20sffactory/community_robot_arm/Assembly & Control Guides/Wiring Guide/wiring-a4988.jpg

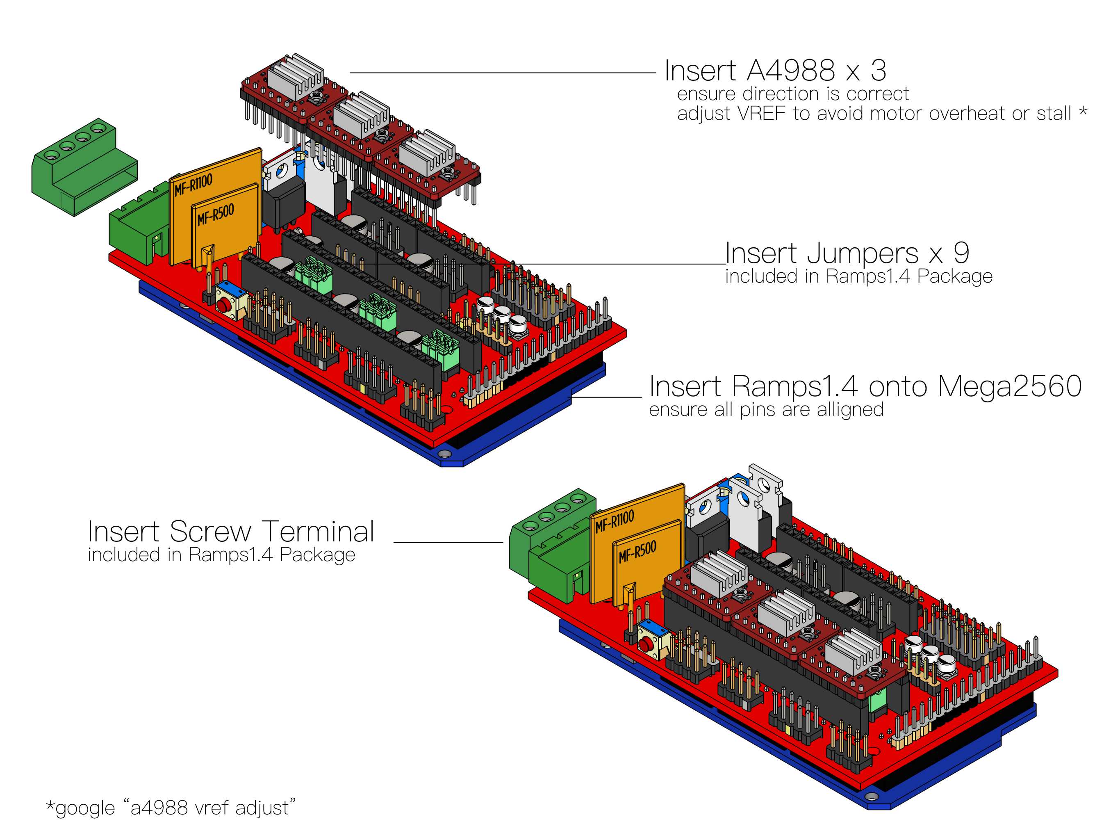
Assembly & Control Guides/Wiring Guide/wiring-a4988.jpg
