20sffactory/community_robot_arm/Assembly & Control Guides/Wiring Guide/wiring-endstops.jpg

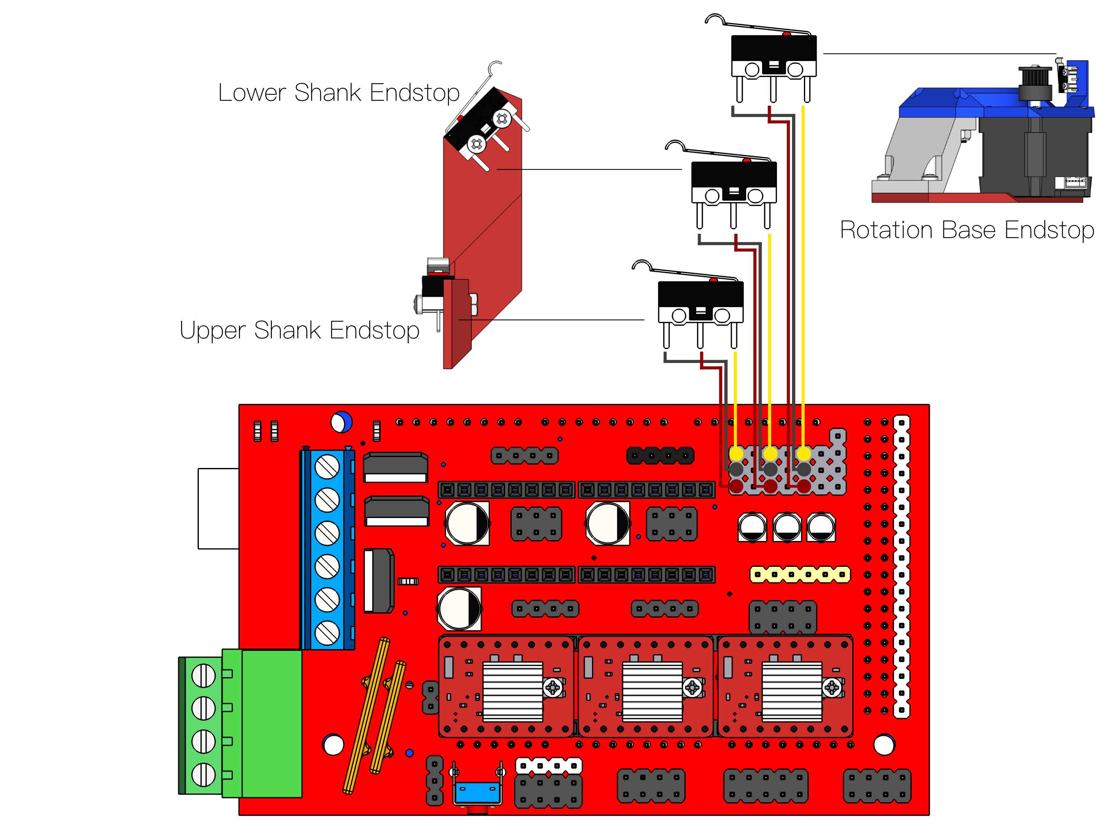
Assembly & Control Guides/Wiring Guide/wiring-endstops.jpg
