20sffactory/community_robot_arm/Assembly & Control Guides/robot_bom.jpg

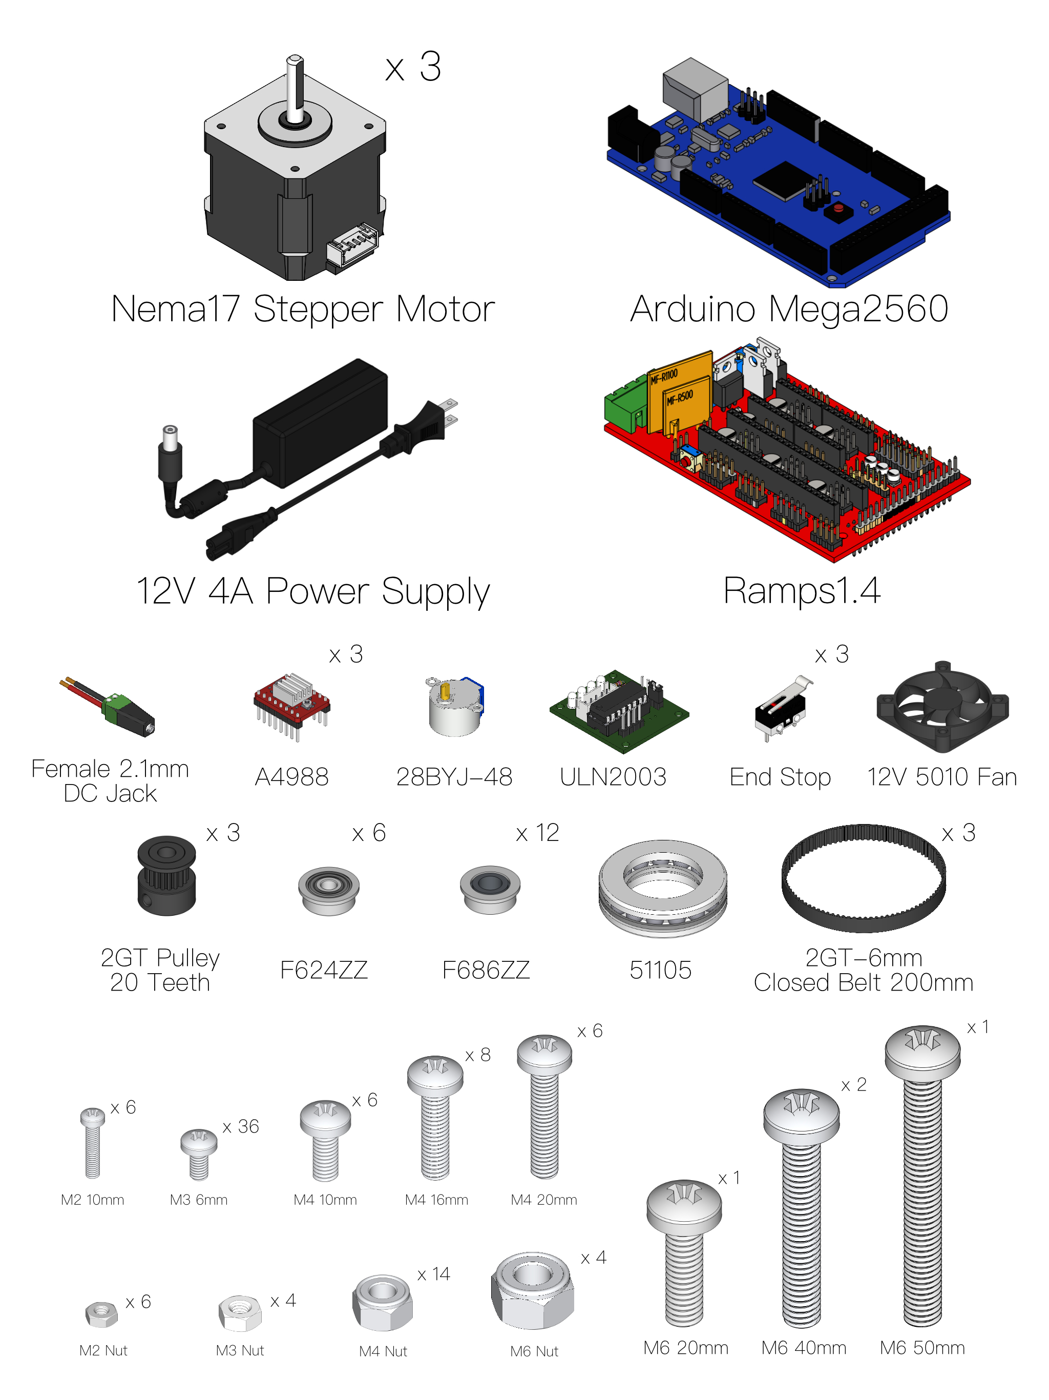
Assembly & Control Guides/robot_bom.jpg
