20sffactory/community_robot_arm/CAD Files/dual_manipulator_support/main_body_dual_v2.stl

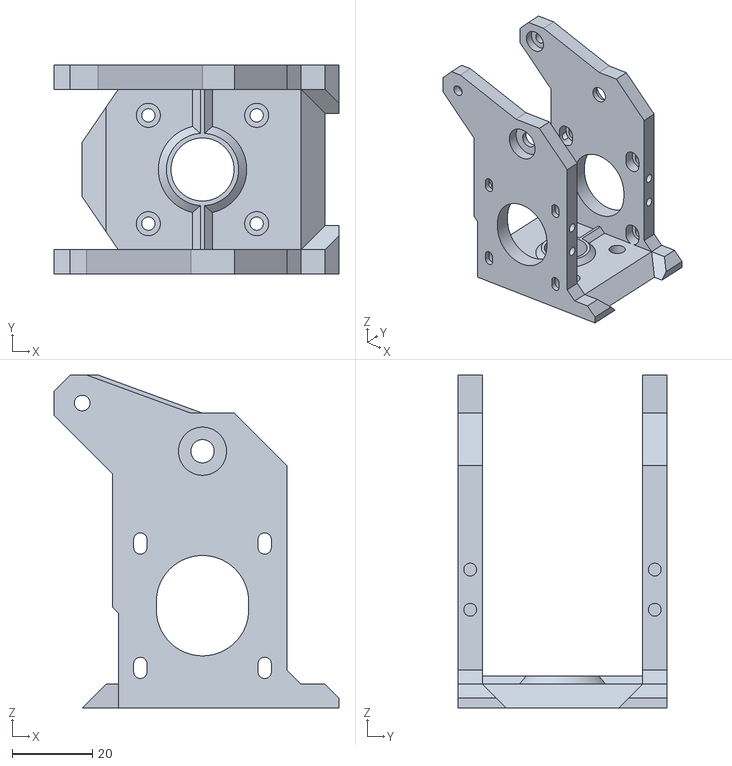
[picture p4: CAD file, 2021-02-04]
CAD Files/dual_manipulator_support/main_body_dual_v2.stl
71.0 x 52.0 x 83.0
