20sffactory/community_robot_arm/CAD Files/robot_belt_arm main_body_v2.stl

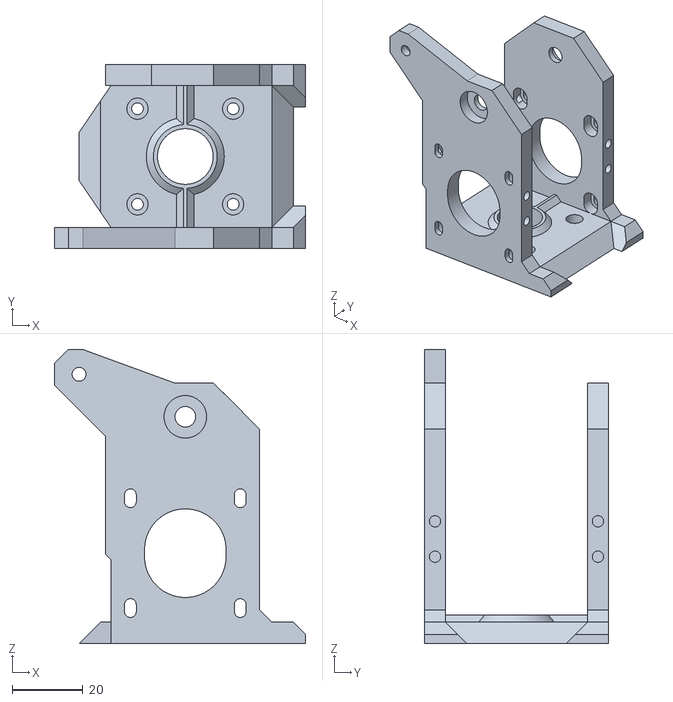
[picture p5: CAD file, 2021-02-04]
CAD Files/robot_belt_arm main_body_v2.stl
71.0 x 52.0 x 83.0
