20sffactory/community_robot_arm/CAD Files/rail_stl/rail_motor_mount.stl

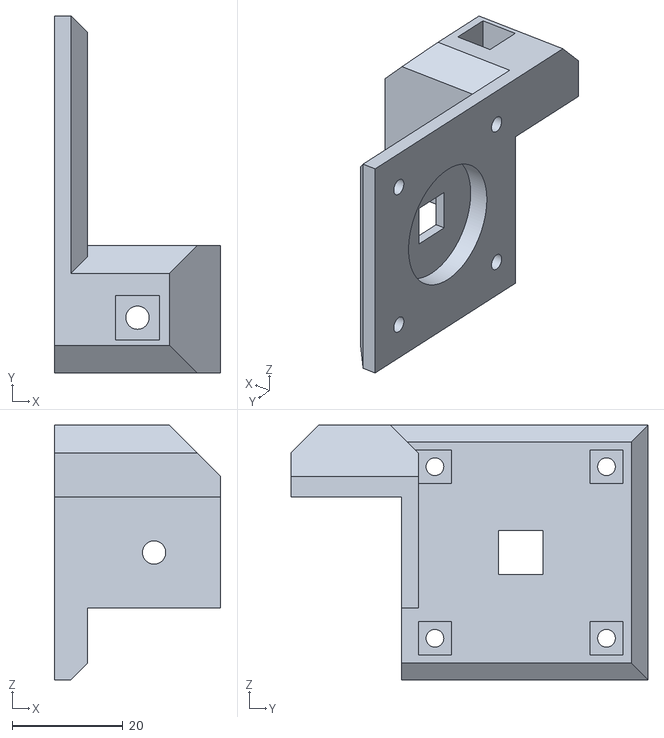
[picture p6: CAD file, 2020-11-04]
CAD Files/rail_stl/rail_motor_mount.stl
30.0 x 64.5 x 46.0
