20sffactory/community_robot_arm/CAD Files/robot_arm_upper_shank_v2.stl

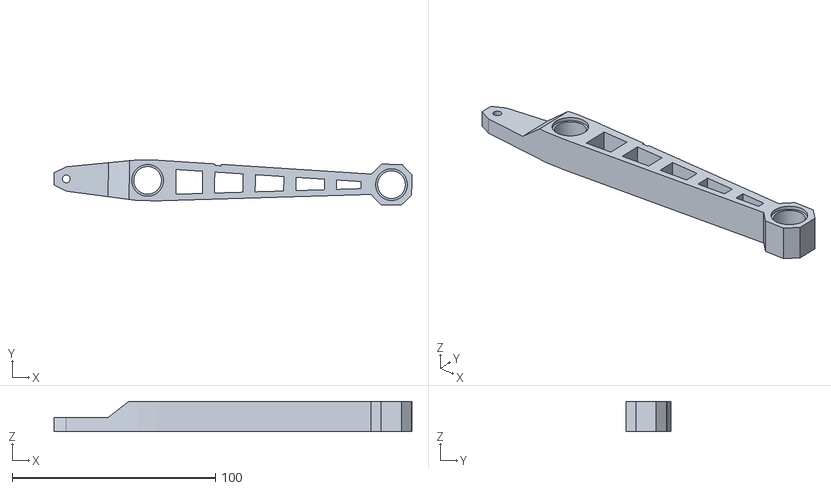
[picture p7: CAD file, 2021-08-22]
CAD Files/robot_arm_upper_shank_v2.stl
176.1 x 22.3 x 15.0
