20sffactory/community_robot_arm/CAD Files/shank_calibrator/shank_calibrator_120mm.stl

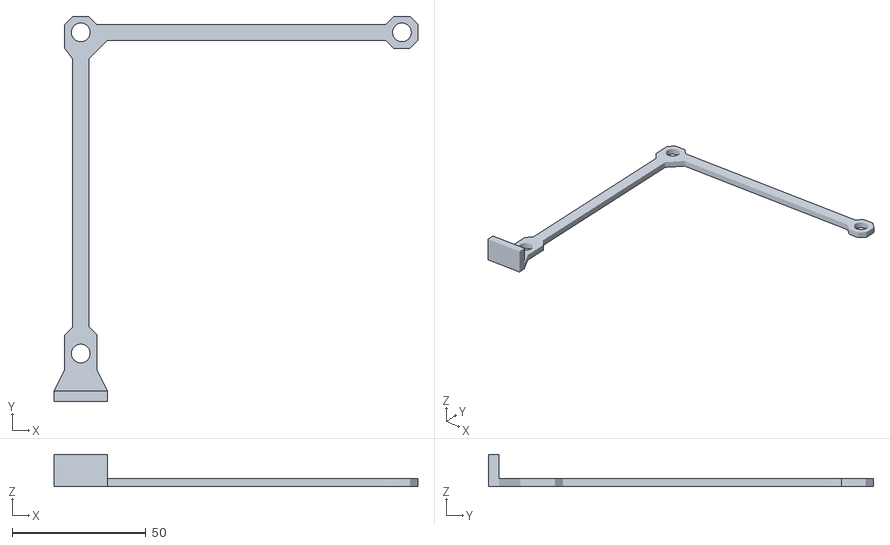
[picture p8: CAD file, 2021-01-24]
CAD Files/shank_calibrator/shank_calibrator_120mm.stl
136.0 x 144.0 x 12.0
