20sffactory/community_robot_arm/CAD Files/shank_pleuel_140mm/lower_shank_140.stl

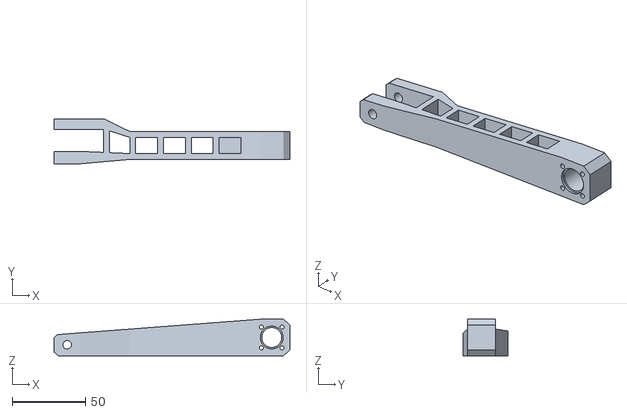
[picture p9: CAD file, 2021-01-19]
CAD Files/shank_pleuel_140mm/lower_shank_140.stl
161.4 x 30.5 x 25.0
