20sffactory/community_robot_arm/CAD Files/toolheads_stl/28byj_cover_by_woutervanschaik/Cap.stp

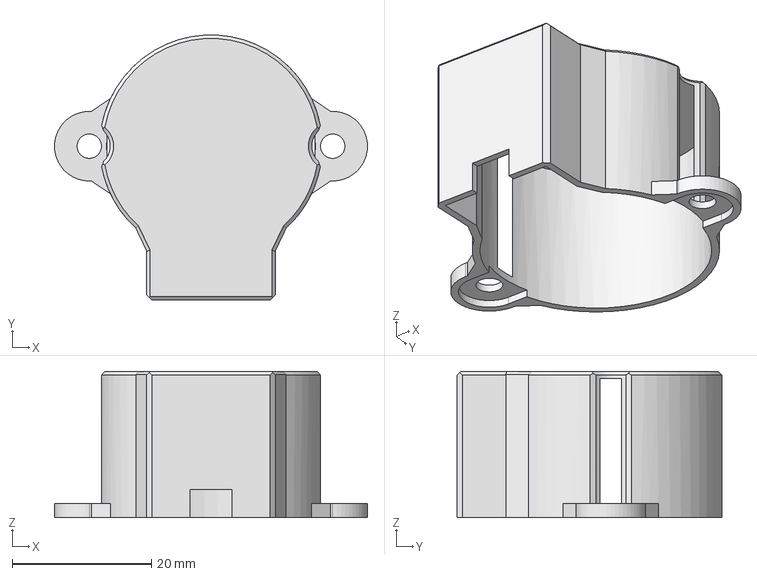
[picture p10: CAD file, 2021-02-07]
CAD Files/toolheads_stl/28byj_cover_by_woutervanschaik/Cap.stp
45.0 x 38.1 x 21.0 mm
