20sffactory/community_robot_arm/CAD Files/toolheads_stl/3dprint_extractor.stl

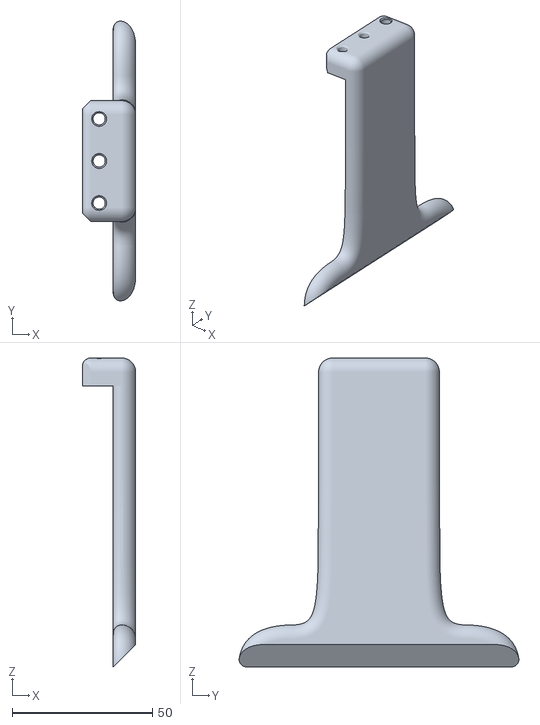
[picture p11: CAD file, 2021-02-24]
CAD Files/toolheads_stl/3dprint_extractor.stl
19.0 x 99.6 x 110.0
