20sffactory/community_robot_arm/CAD Files/toolheads_stl/gripper_stl_by_ftobler/gripperHolePlateWithPenHolder_by_Leandro.stl

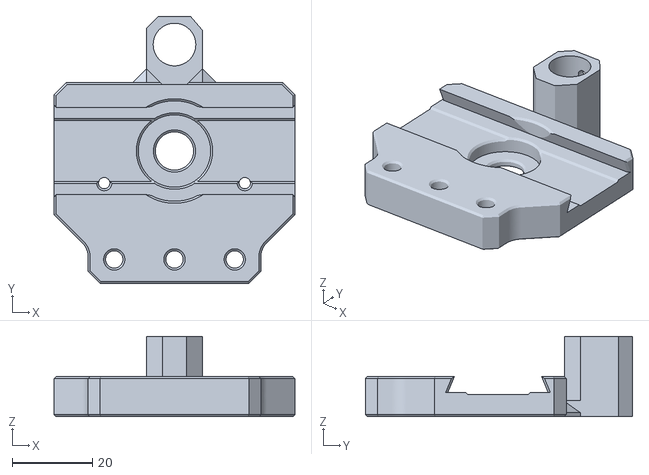
[picture p12: CAD file, 2021-01-23]
CAD Files/toolheads_stl/gripper_stl_by_ftobler/gripperHolePlateWithPenHolder_by_Leandro.stl
60.0 x 66.5 x 20.0
