20sffactory/community_robot_arm/CAD Files/toolheads_stl/servo_gripper_stl_by_20sffactory/servo_gripperBase.stl

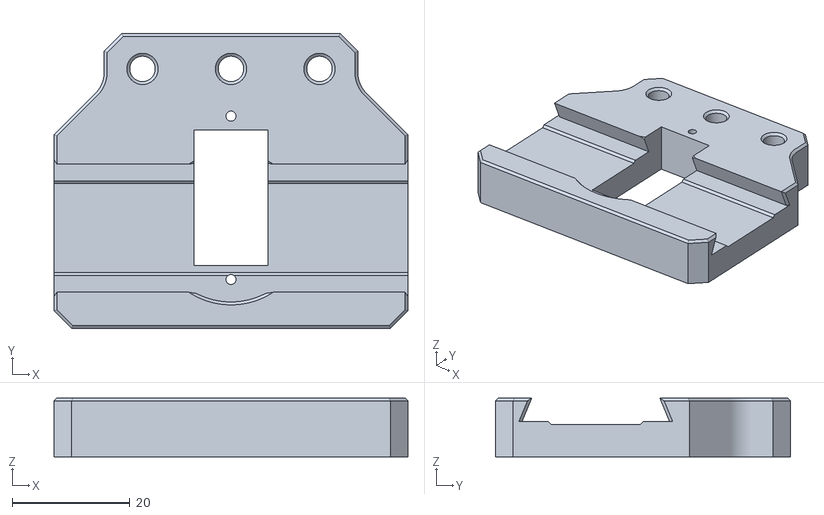
[picture p13: CAD file, 2021-05-25]
CAD Files/toolheads_stl/servo_gripper_stl_by_20sffactory/servo_gripperBase.stl
60.0 x 50.0 x 10.0
