20sffactory/community_robot_arm/CAD Files/rail_stl/rail_leg.stl

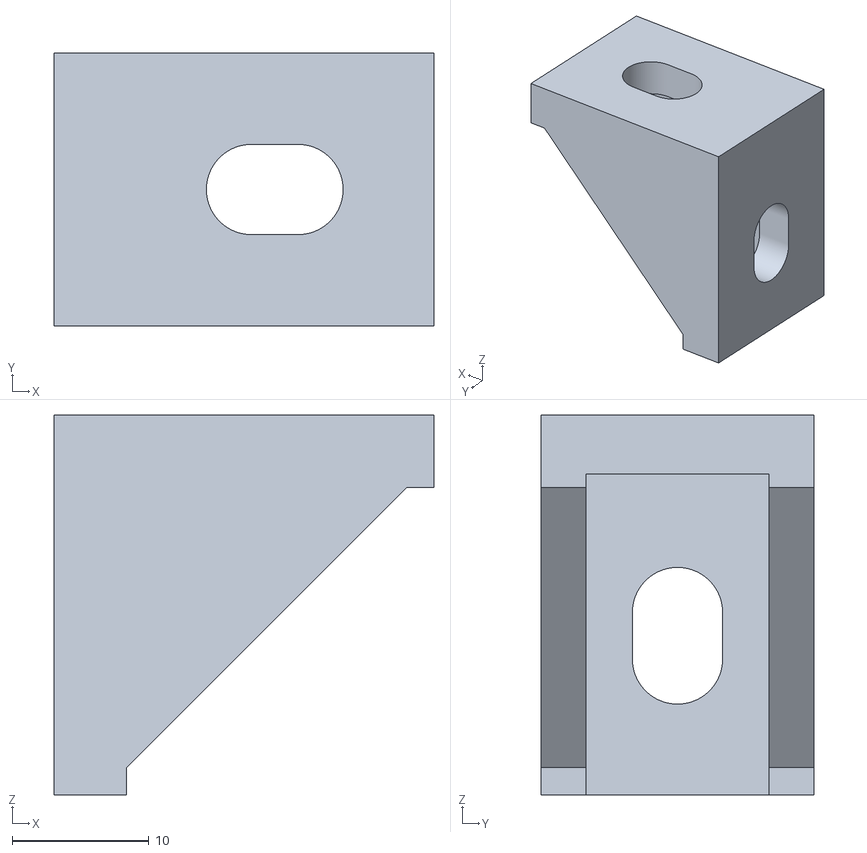
[picture p14: CAD file, 2020-11-04]
CAD Files/rail_stl/rail_leg.stl
27.8 x 20.0 x 27.8
