20sffactory/community_robot_arm/CAD Files/robot_belt_arm socket_v2.stl

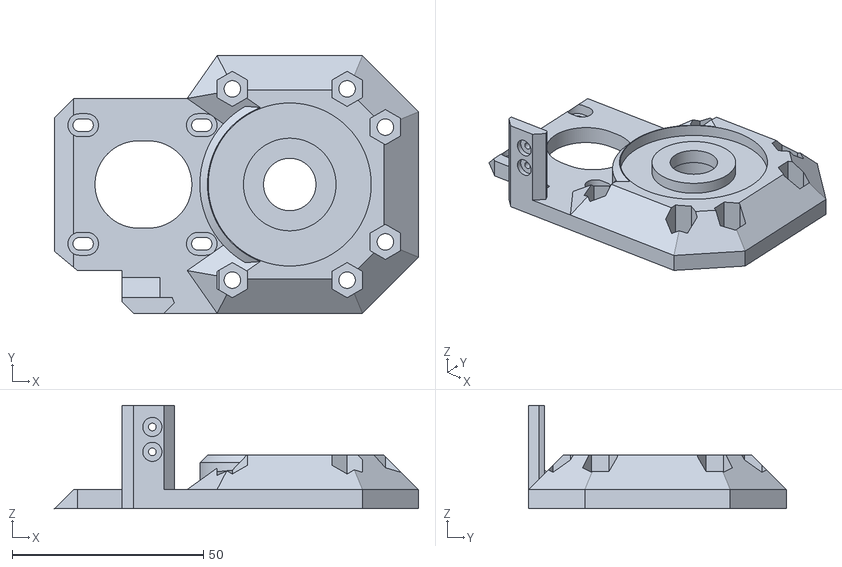
[picture p15: CAD file, 2021-02-04]
CAD Files/robot_belt_arm socket_v2.stl
95.2 x 67.3 x 27.0
