20sffactory/community_robot_arm/CAD Files/shank_calibrator/shank_calibrator_140mm.stl

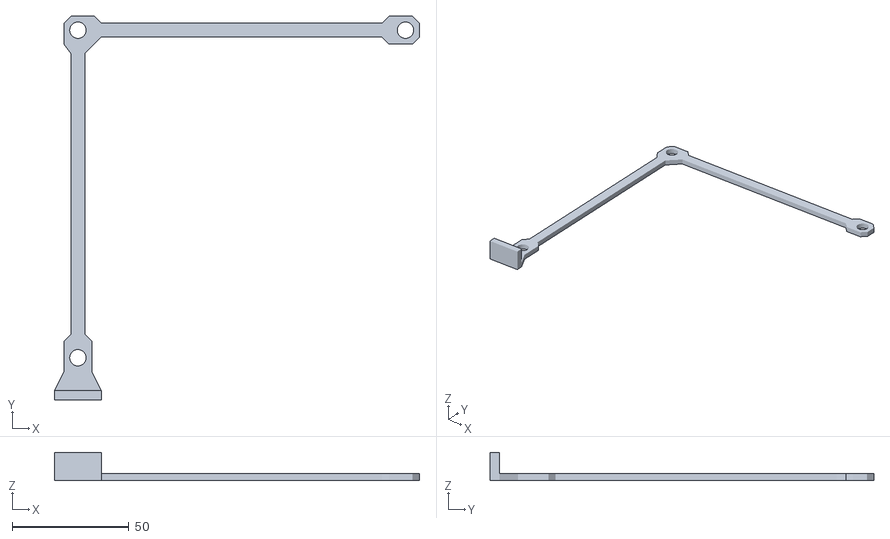
[picture p16: CAD file, 2021-01-24]
CAD Files/shank_calibrator/shank_calibrator_140mm.stl
156.0 x 164.0 x 12.0
