20sffactory/community_robot_arm/CAD Files/shank_pleuel_140mm/pleuel_bend_140.stl

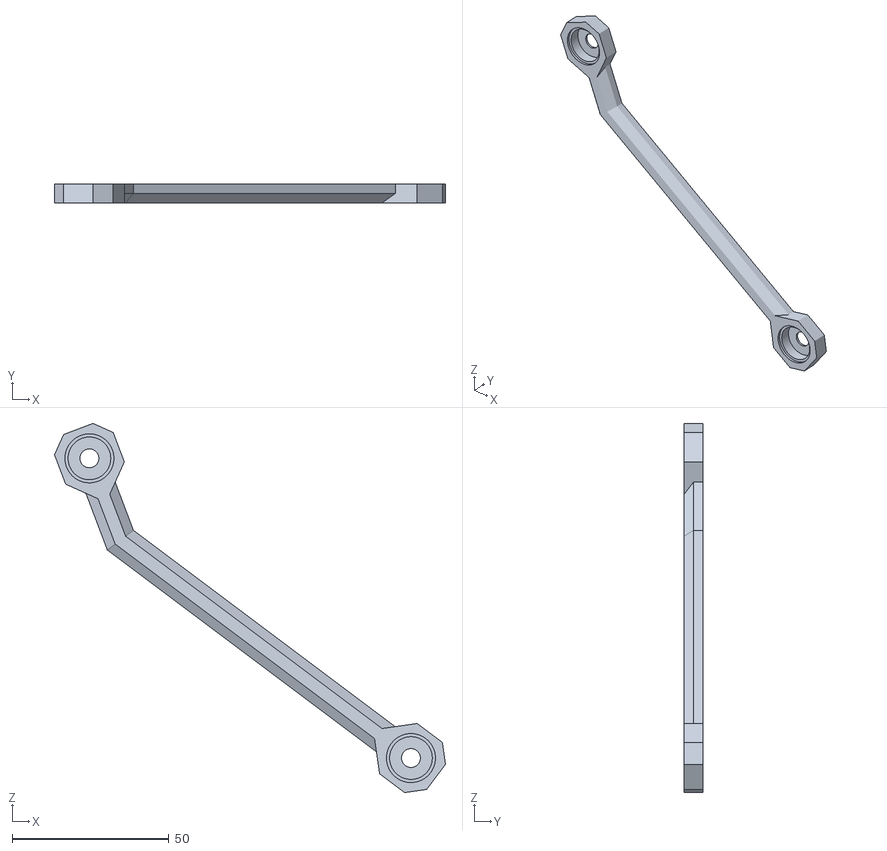
[picture p17: CAD file, 2021-01-19]
CAD Files/shank_pleuel_140mm/pleuel_bend_140.stl
124.5 x 6.00 x 117.6
