20sffactory/community_robot_arm/CAD Files/toolheads_stl/dragon_head.stl

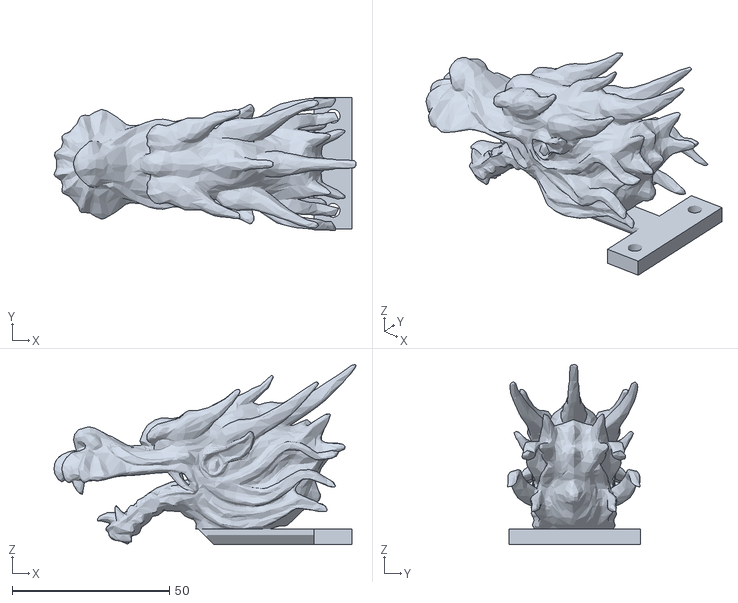
[picture p18: CAD file, 2021-02-24]
CAD Files/toolheads_stl/dragon_head.stl
96.2 x 42.5 x 57.4
