20sffactory/community_robot_arm/CAD Files/toolheads_stl/gripper_stl_by_ftobler/gripperBase_by_ftobler.stl

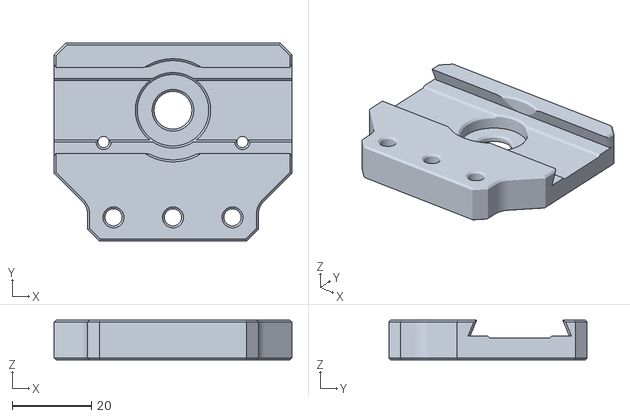
[picture p19: CAD file, 2021-01-16]
CAD Files/toolheads_stl/gripper_stl_by_ftobler/gripperBase_by_ftobler.stl
60.0 x 50.0 x 10.0
