20sffactory/community_robot_arm/CAD Files/toolheads_stl/servo_gripper_stl_by_20sffactory/servo_gripper_shaft.stl

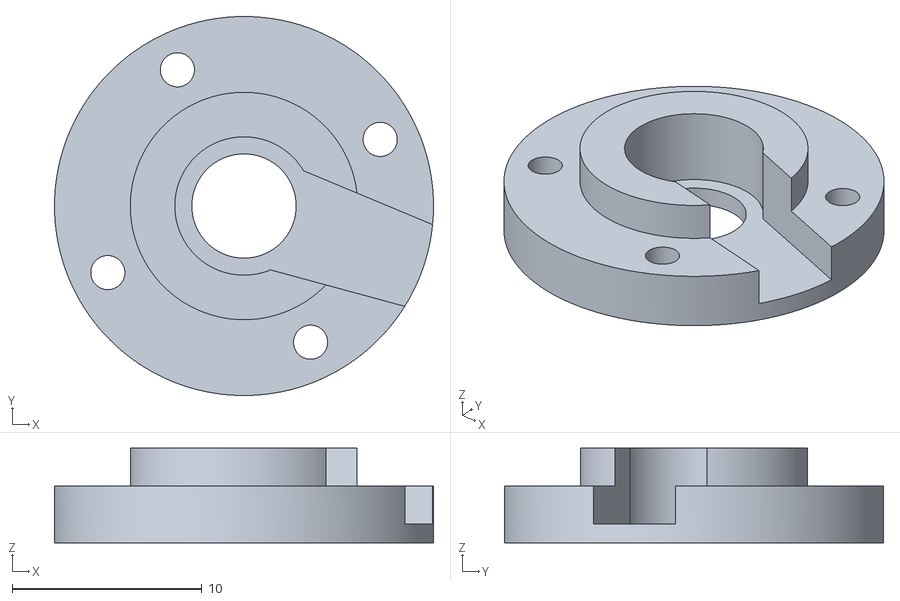
[picture p20: CAD file, 2021-05-25]
CAD Files/toolheads_stl/servo_gripper_stl_by_20sffactory/servo_gripper_shaft.stl
20.0 x 20.0 x 5.00
