20sffactory/community_robot_arm/CAD Files/dual_manipulator_support/triplate_dual.stl

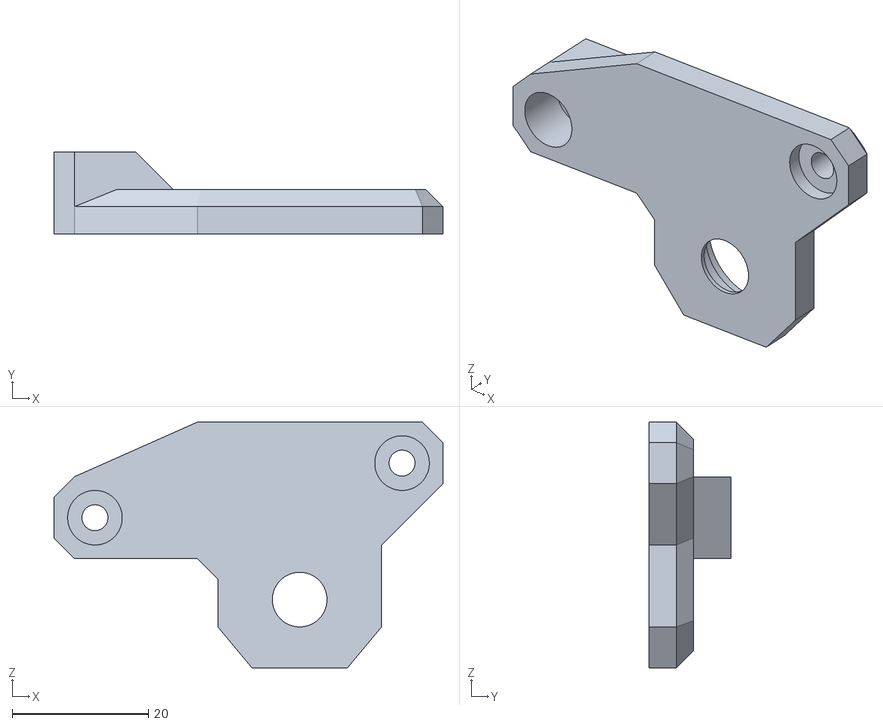
[picture p21: CAD file, 2021-01-19]
CAD Files/dual_manipulator_support/triplate_dual.stl
57.0 x 12.0 x 36.0
