20sffactory/community_robot_arm/CAD Files/rail_stl/rail_slide_plate.stl

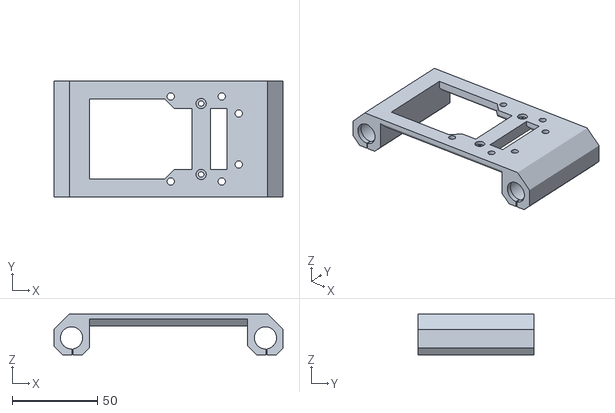
[picture p22: CAD file, 2020-11-04]
CAD Files/rail_stl/rail_slide_plate.stl
134.6 x 68.0 x 24.0
