20sffactory/community_robot_arm/CAD Files/shank_pleuel_140mm/upper_shank_140.stl

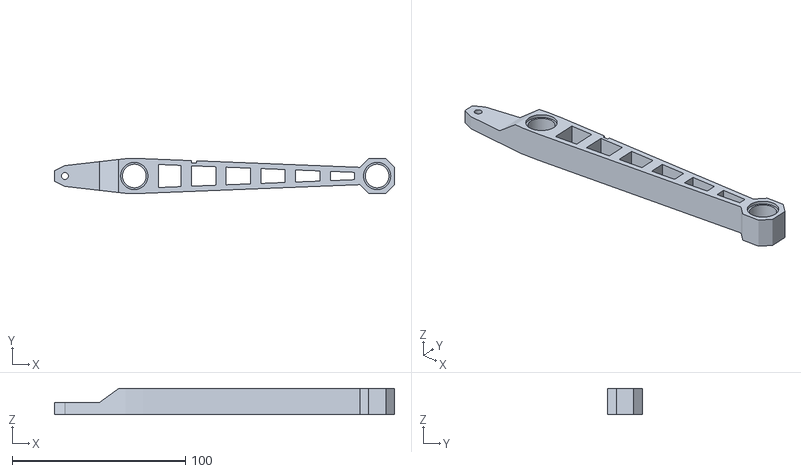
[picture p23: CAD file, 2021-01-19]
CAD Files/shank_pleuel_140mm/upper_shank_140.stl
196.0 x 20.0 x 15.0
