20sffactory/community_robot_arm/CAD Files/toolheads_stl/gripper_stl_by_ftobler/gripper_shaft.stl

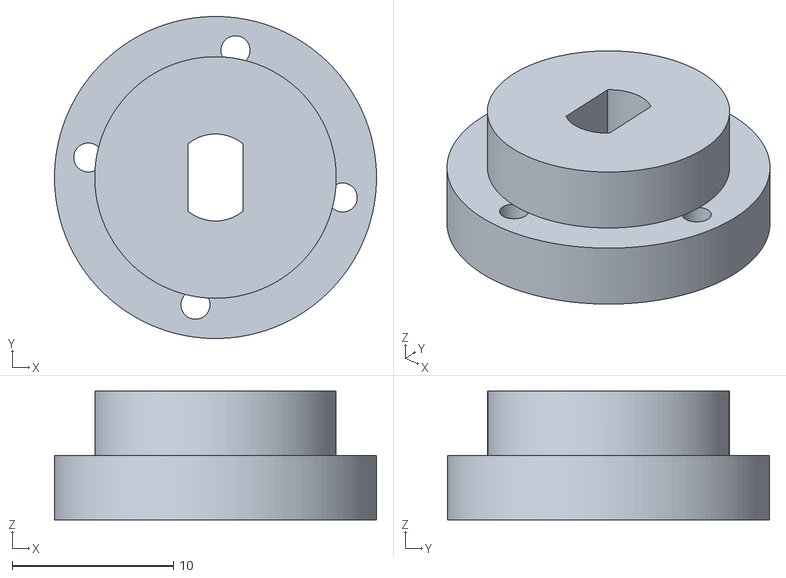
[picture p24: CAD file, 2021-01-16]
CAD Files/toolheads_stl/gripper_stl_by_ftobler/gripper_shaft.stl
20.0 x 20.0 x 8.00
