20sffactory/community_robot_arm/CAD Files/toolheads_stl/pen_plotter.stl

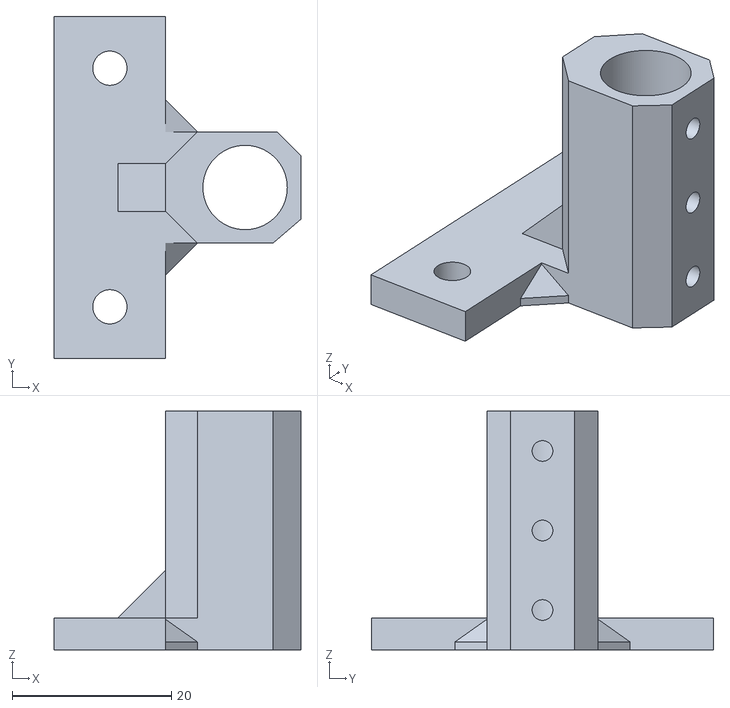
[picture p25: CAD file, 2020-10-14]
CAD Files/toolheads_stl/pen_plotter.stl
31.0 x 43.0 x 30.0
