20sffactory/community_robot_arm/CAD Files/toolheads_stl/servo_gripper_stl_by_20sffactory/servo_gripperBaseWithPenHolder.stl

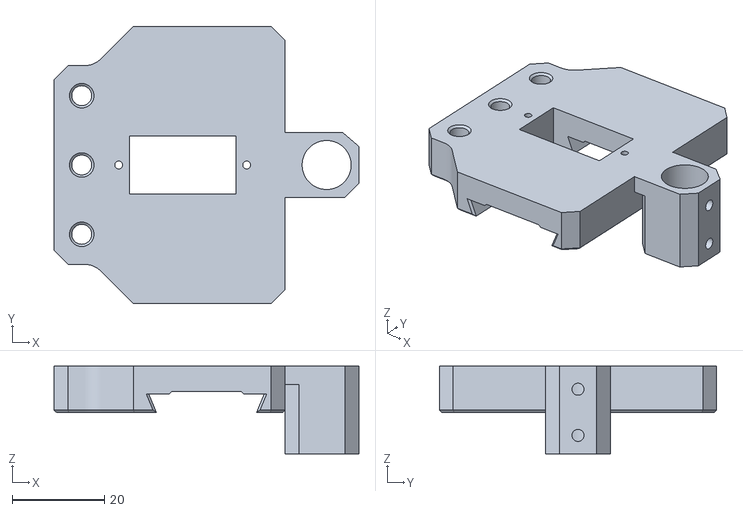
[picture p26: CAD file, 2021-05-25]
CAD Files/toolheads_stl/servo_gripper_stl_by_20sffactory/servo_gripperBaseWithPenHolder.stl
66.0 x 60.0 x 19.0
