20sffactory/community_robot_arm/CAD Files/case_fangrill.stl

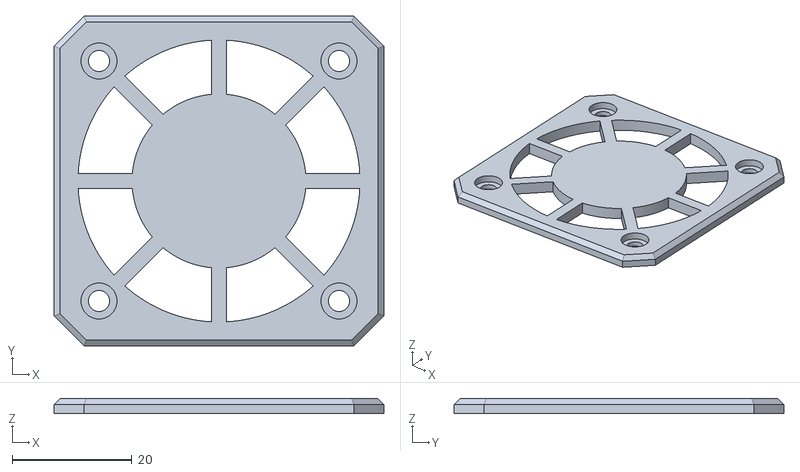
[picture p27: CAD file, 2020-10-07]
CAD Files/case_fangrill.stl
55.0 x 55.0 x 2.50
