20sffactory/community_robot_arm/CAD Files/dual_manipulator_support/manipulator_dual.stl

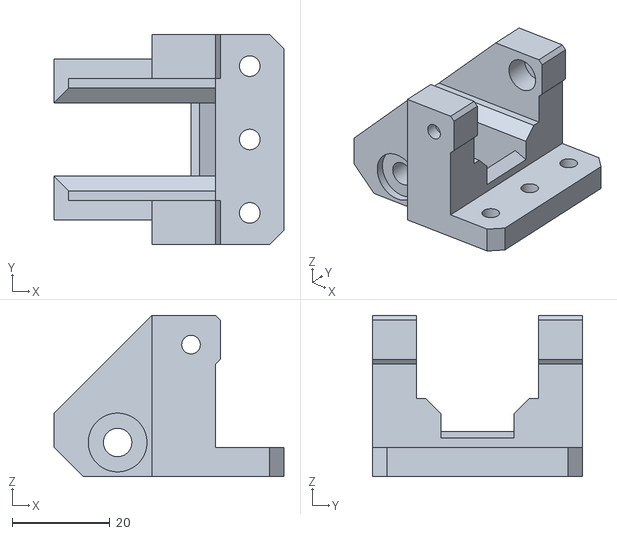
[picture p28: CAD file, 2021-01-19]
CAD Files/dual_manipulator_support/manipulator_dual.stl
47.0 x 43.0 x 33.0
