20sffactory/community_robot_arm/CAD Files/rail_stl/rail_rod_fastener.stl

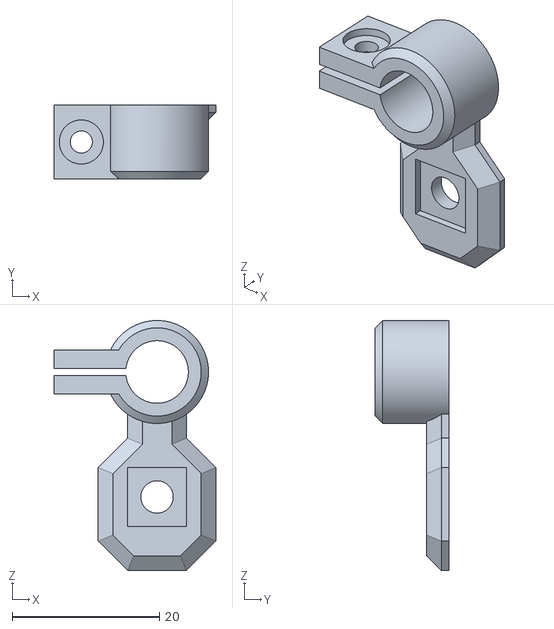
[picture p29: CAD file, 2020-11-04]
CAD Files/rail_stl/rail_rod_fastener.stl
22.0 x 10.0 x 34.0
