20sffactory/community_robot_arm/CAD Files/shank_pleuel_140mm/pleuel_140.stl

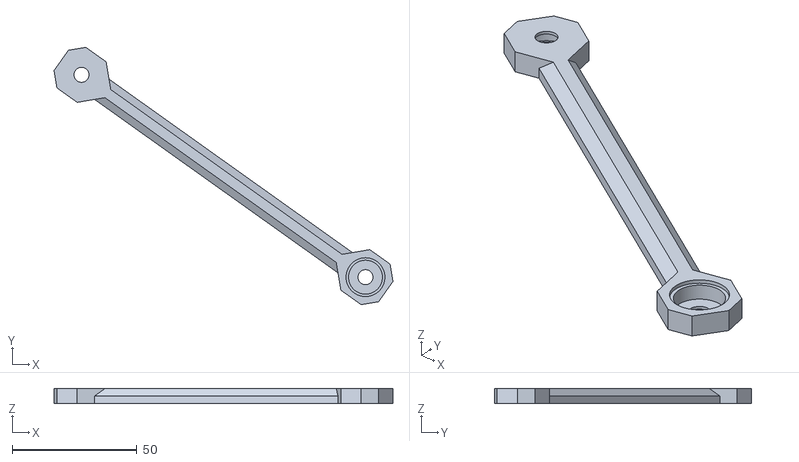
[picture p30: CAD file, 2021-01-19]
CAD Files/shank_pleuel_140mm/pleuel_140.stl
136.1 x 103.3 x 6.00
