20sffactory/community_robot_arm/CAD Files/toolheads_stl/servo_gripper_stl_by_20sffactory/gripperFinger_by_ftobler.stl

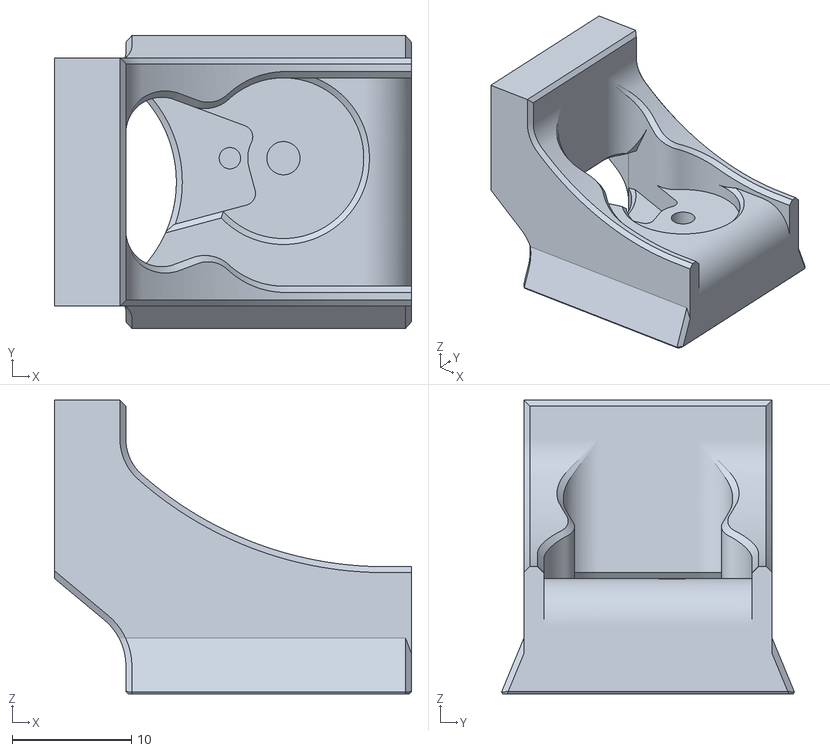
[picture p31: CAD file, 2021-01-16]
CAD Files/toolheads_stl/servo_gripper_stl_by_20sffactory/gripperFinger_by_ftobler.stl
30.0 x 24.6 x 24.7
