20sffactory/community_robot_arm/CAD Files/case_top.stl

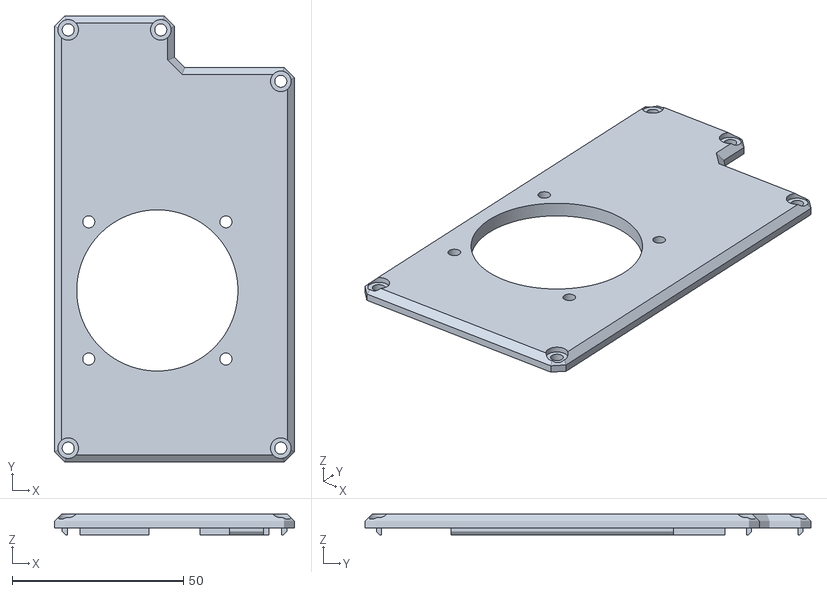
[picture p32: CAD file, 2020-10-07]
CAD Files/case_top.stl
70.0 x 130.0 x 6.00
