20sffactory/community_robot_arm/CAD Files/rail_stl/rail_belt_holder.stl

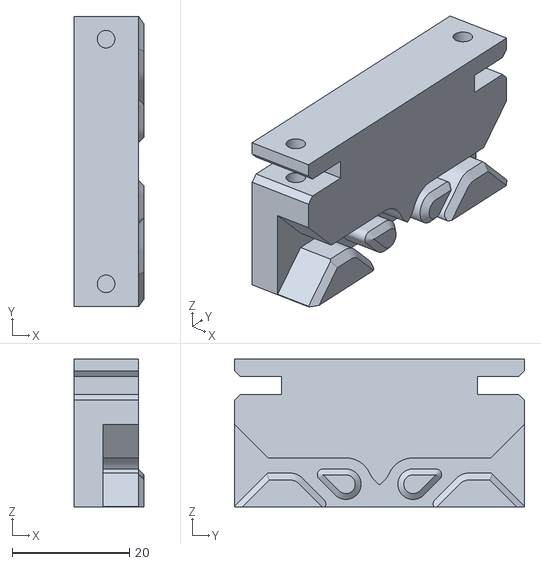
[picture p33: CAD file, 2020-11-04]
CAD Files/rail_stl/rail_belt_holder.stl
12.0 x 49.4 x 25.2
