20sffactory/community_robot_arm/CAD Files/case_grill_duplicate.stl

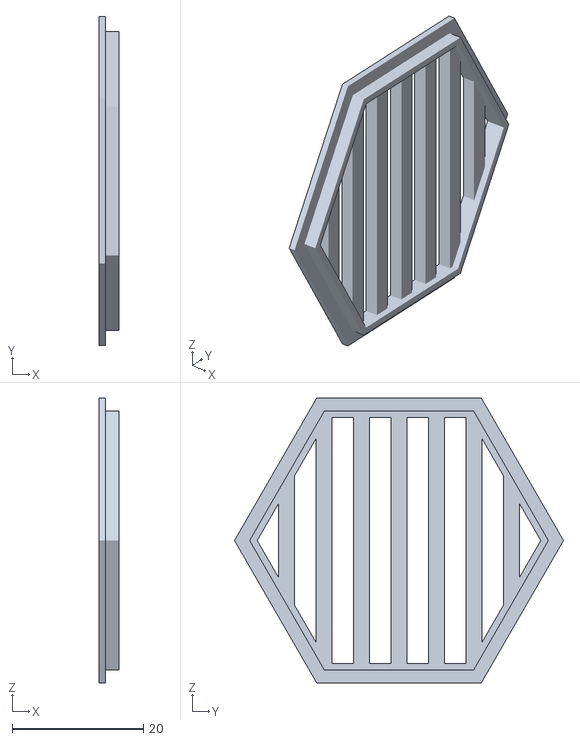
[picture p34: CAD file, 2020-10-07]
CAD Files/case_grill_duplicate.stl
3.00 x 50.1 x 43.4
