20sffactory/community_robot_arm/CAD Files/rail_stl/rail_2020.stl

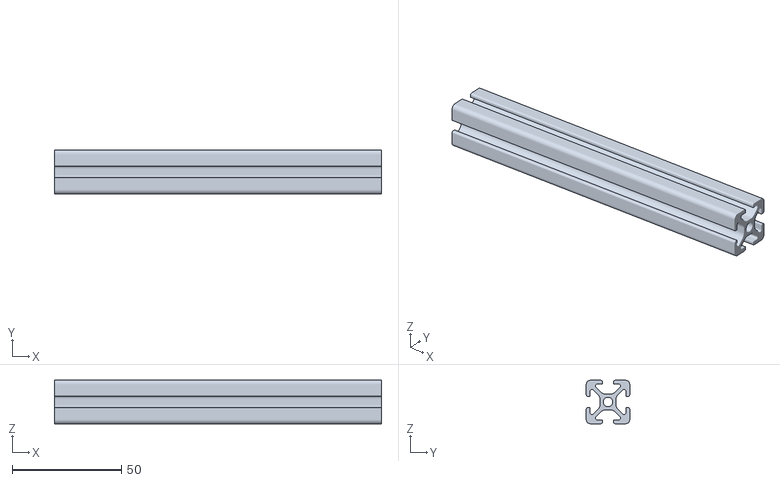
[picture p35: CAD file, 2020-11-04]
CAD Files/rail_stl/rail_2020.stl
150.0 x 20.0 x 20.0
