20sffactory/community_robot_arm/CAD Files/case_cablehole.stl

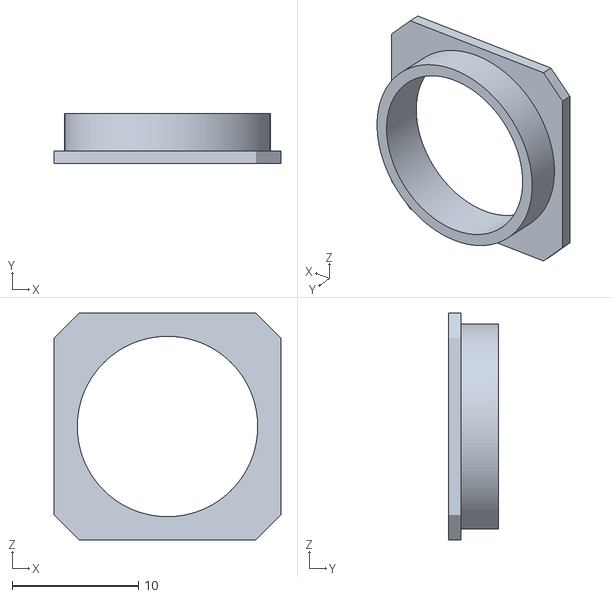
[picture p36: CAD file, 2020-10-07]
CAD Files/case_cablehole.stl
18.0 x 4.00 x 18.0
