20sffactory/community_robot_arm/CAD Files/rail_stl/rail_rod_mount.stl

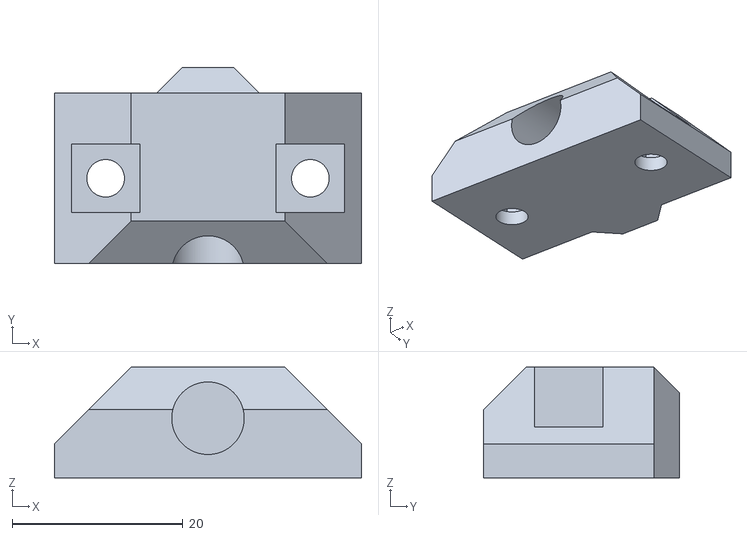
[picture p37: CAD file, 2020-11-04]
CAD Files/rail_stl/rail_rod_mount.stl
36.0 x 23.0 x 13.0
