20sffactory/community_robot_arm/CAD Files/case_bottom.stl

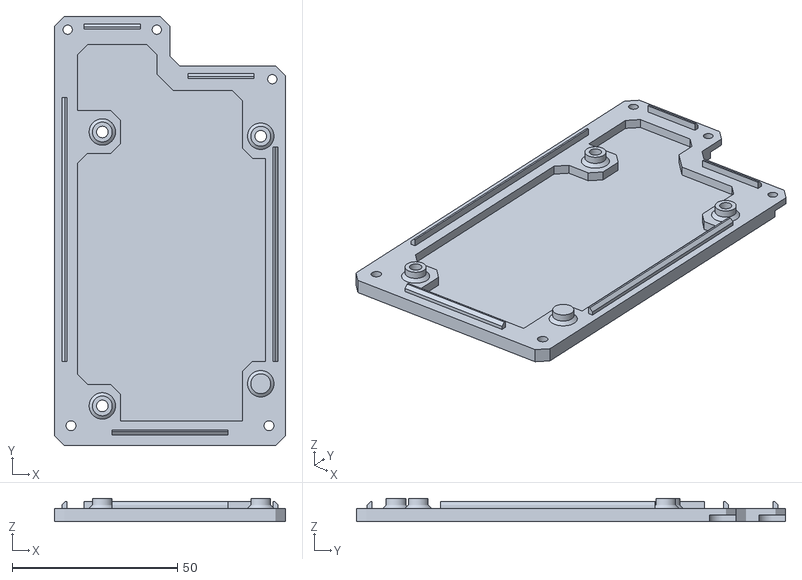
[picture p38: CAD file, 2020-10-07]
CAD Files/case_bottom.stl
70.0 x 130.0 x 7.00
