20sffactory/community_robot_arm/CAD Files/rail_stl/rail_slide_endstop.stl

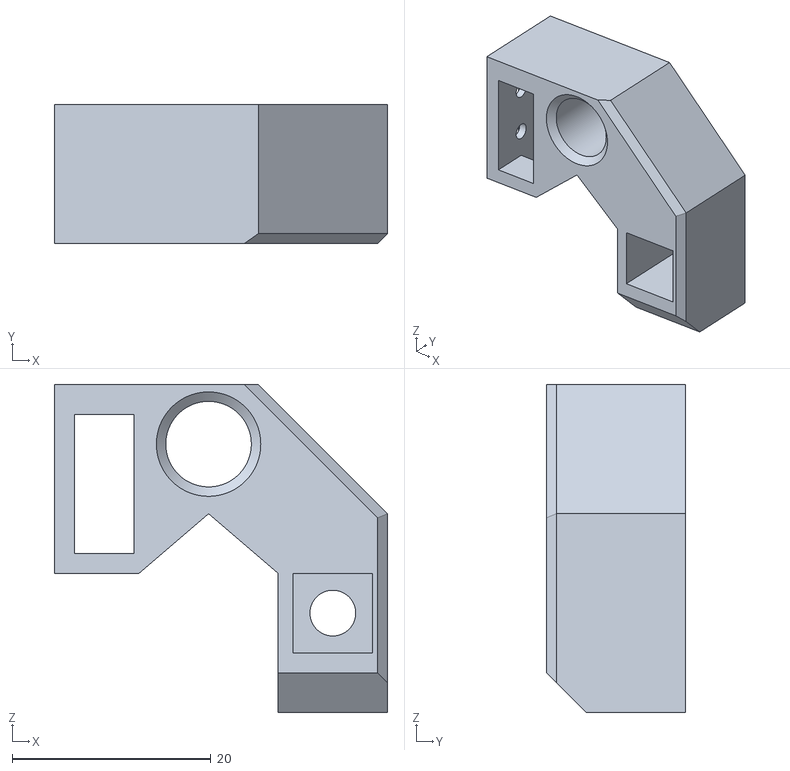
[picture p39: CAD file, 2020-11-04]
CAD Files/rail_stl/rail_slide_endstop.stl
33.5 x 14.0 x 33.0
