20sffactory/community_robot_arm/CAD Files/case_body.stl

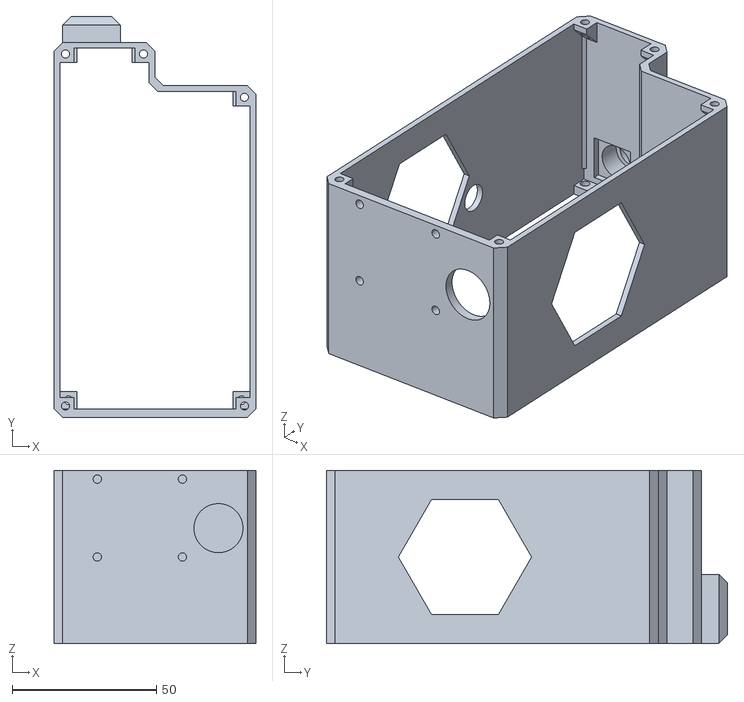
[picture p40: CAD file, 2020-10-07]
CAD Files/case_body.stl
70.0 x 139.0 x 60.0
