20sffactory/community_robot_arm/CAD Files/rail_stl/rail_pulley_mount.stl

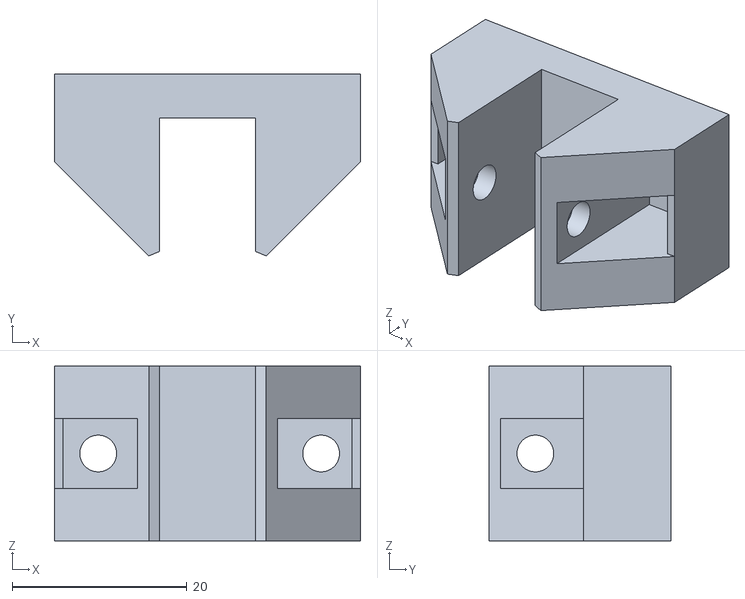
[picture p41: CAD file, 2020-11-04]
CAD Files/rail_stl/rail_pulley_mount.stl
35.0 x 20.8 x 20.0
