20sffactory/community_robot_arm/CAD Files/case_resetbutton.stl

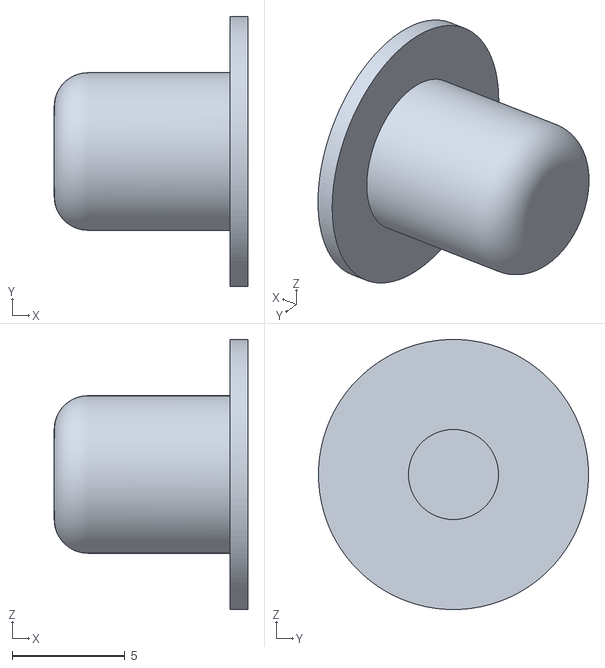
[picture p42: CAD file, 2020-10-07]
CAD Files/case_resetbutton.stl
8.60 x 12.0 x 12.0
