20sffactory/community_robot_arm/CAD Files/case_usb.stl

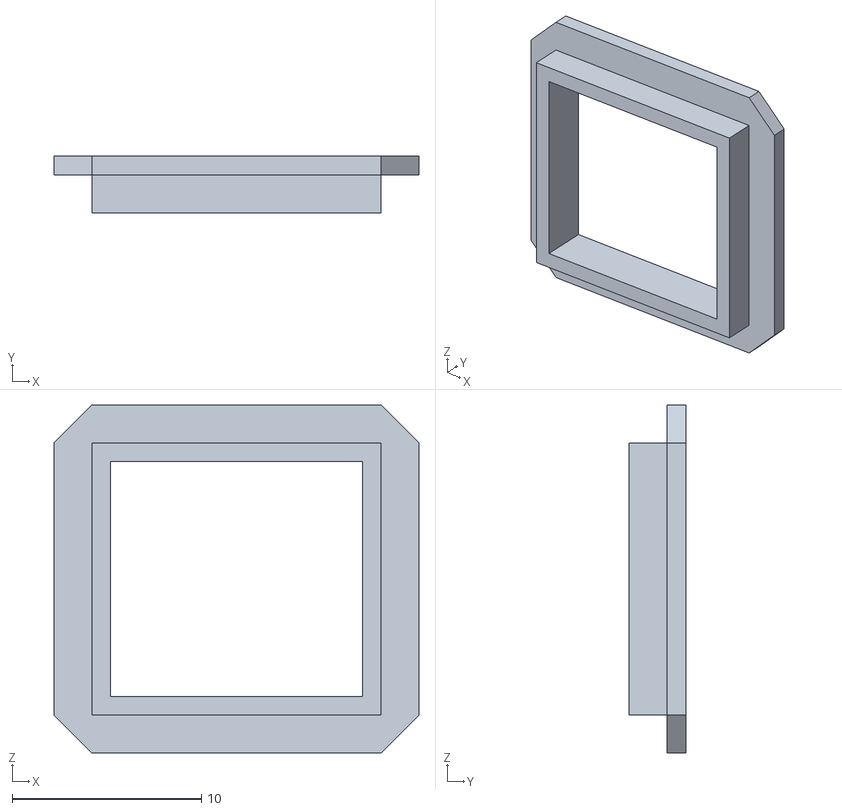
[picture p43: CAD file, 2020-10-07]
CAD Files/case_usb.stl
19.3 x 3.00 x 18.4
