20sffactory/community_robot_arm/CAD Files/robot_arm_enclosure_v0.2.step

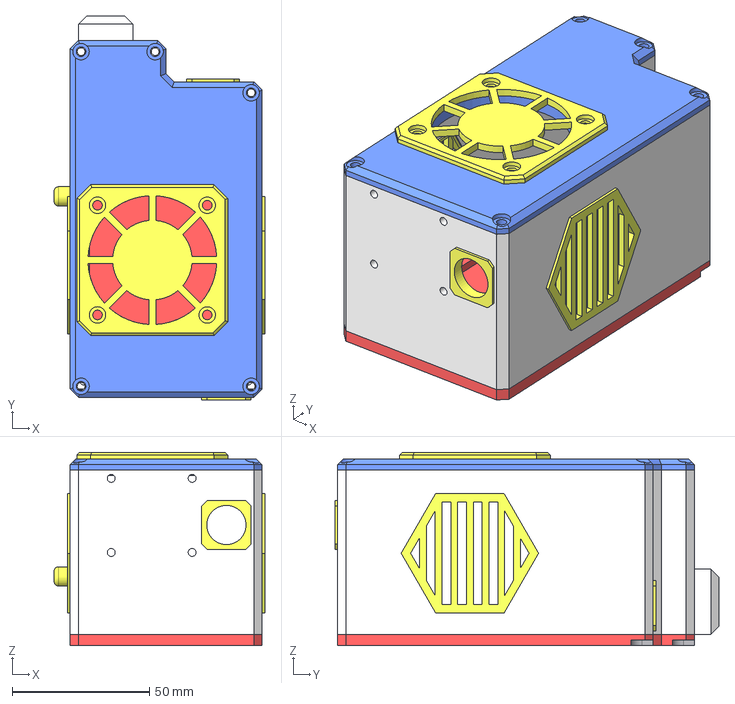
[picture p44: CAD file, 2020-10-04]
CAD Files/robot_arm_enclosure_v0.2.step
76.8 x 140.0 x 70.5 mm
