20sffactory/community_robot_arm/CAD Files/robot_arm upper_shank.stl

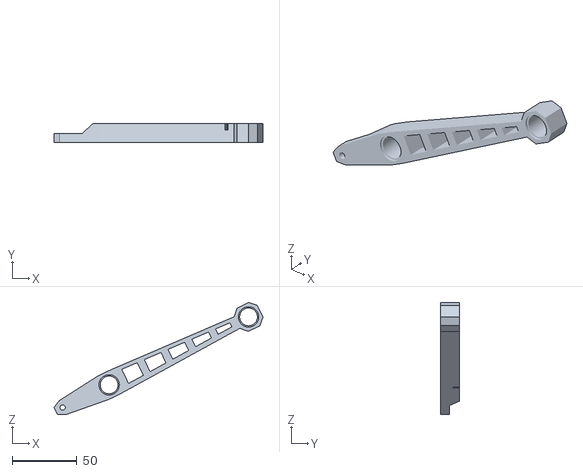
[picture p45: CAD file, 2020-08-24]
CAD Files/robot_arm upper_shank.stl
161.7 x 15.0 x 86.7
