20sffactory/community_robot_arm/CAD Files/robot_belt_arm triplate.stl

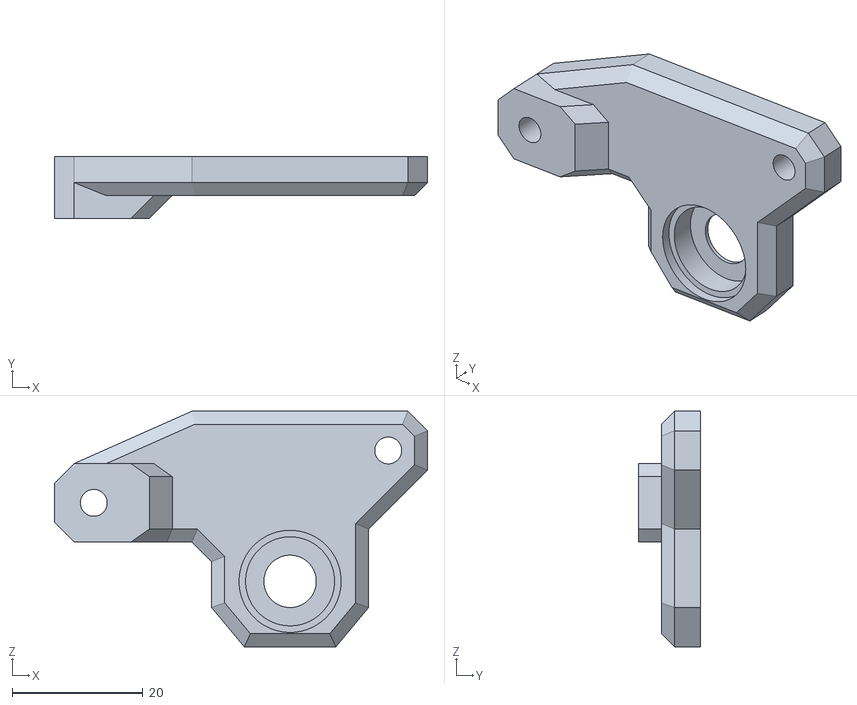
[picture p46: CAD file, 2020-08-24]
CAD Files/robot_belt_arm triplate.stl
57.0 x 9.50 x 36.0
