20sffactory/community_robot_arm/CAD Files/robot_belt_arm gear_body.stl

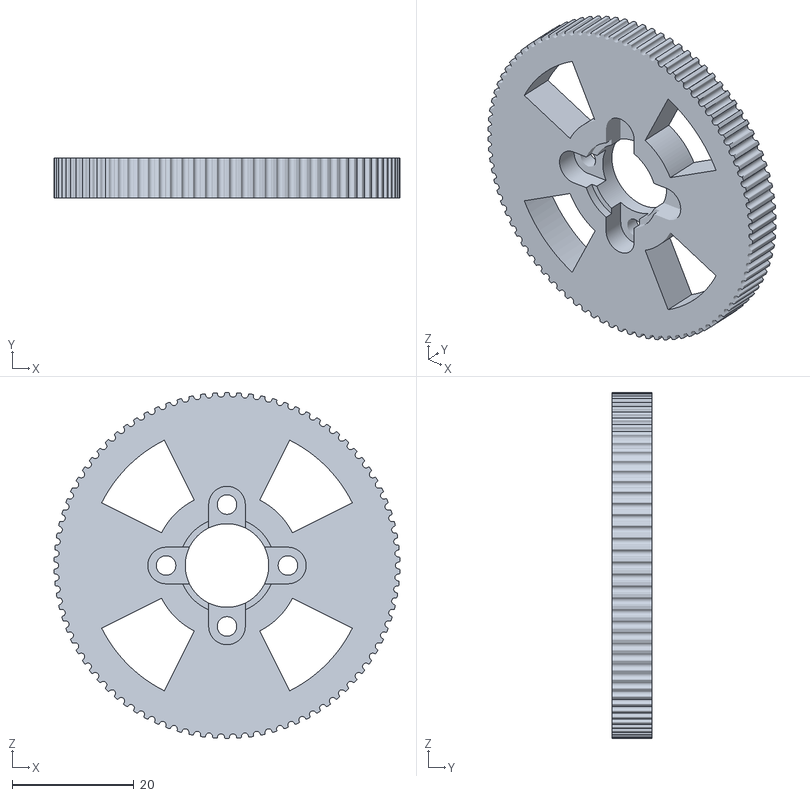
[picture p47: CAD file, 2020-08-24]
CAD Files/robot_belt_arm gear_body.stl
56.8 x 6.50 x 56.8
