20sffactory/community_robot_arm/CAD Files/robot_belt_arm basering.stl

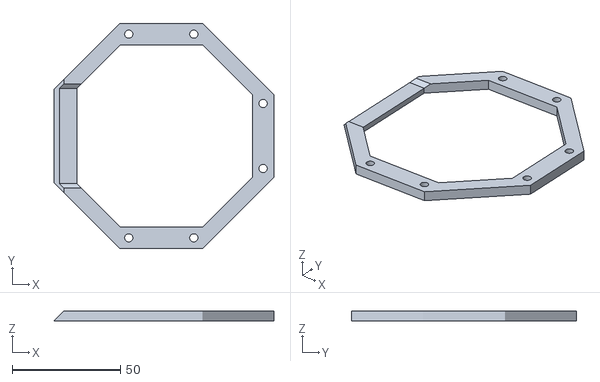
[picture p48: CAD file, 2020-08-24]
CAD Files/robot_belt_arm basering.stl
101.5 x 104.0 x 4.50
