20sffactory/community_robot_arm/CAD Files/robot_belt_arm stabilizer.stl

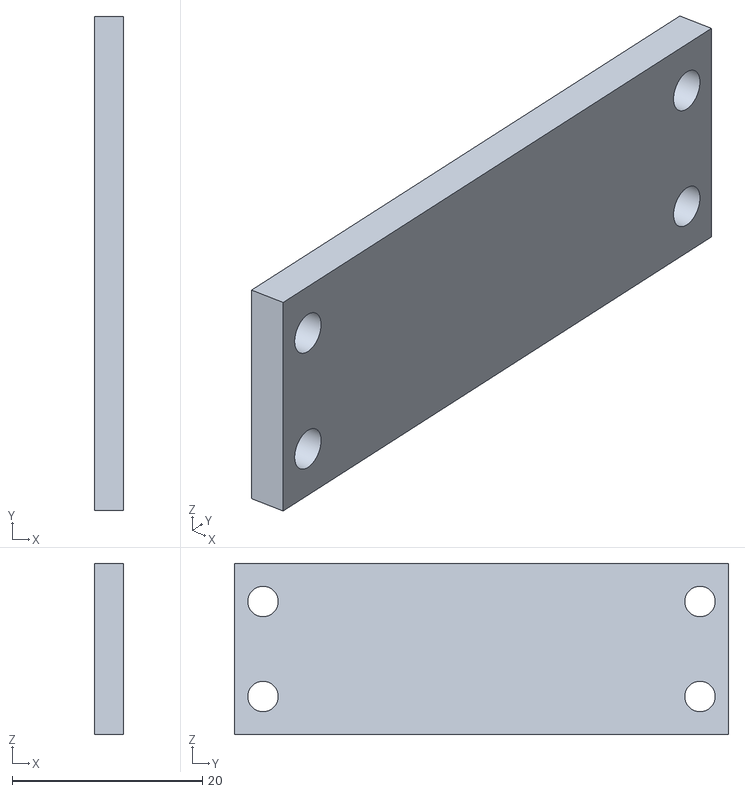
[picture p49: CAD file, 2020-08-24]
CAD Files/robot_belt_arm stabilizer.stl
3.00 x 52.0 x 18.0
