20sffactory/community_robot_arm/CAD Files/robot_belt_arm rotategear.stl

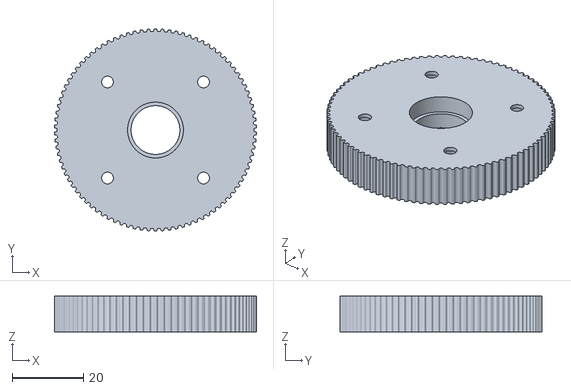
[picture p50: CAD file, 2020-08-24]
CAD Files/robot_belt_arm rotategear.stl
56.8 x 56.8 x 10.0
