20sffactory/community_robot_arm/CAD Files/robot_belt_arm pleuel_bend_lower.stl

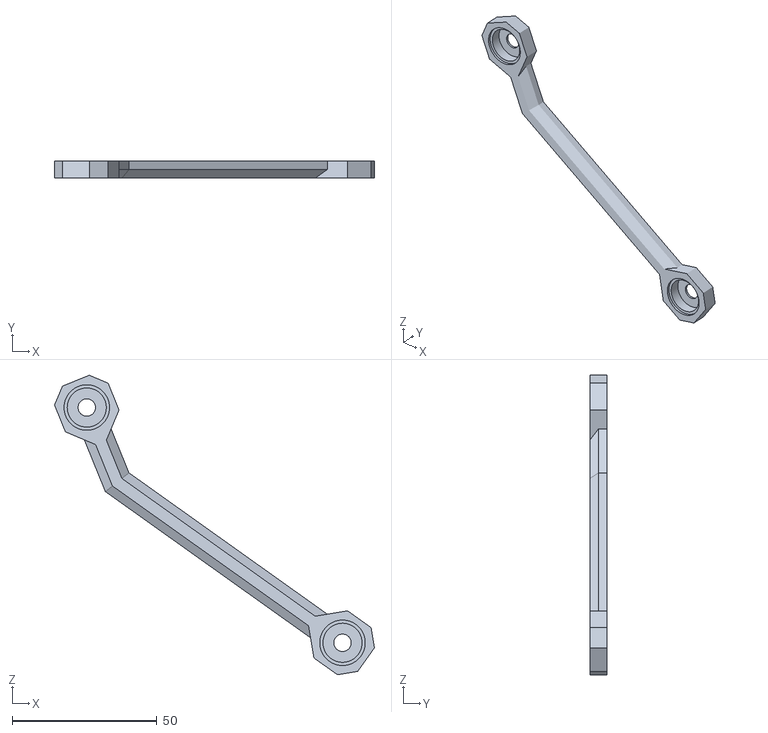
[picture p51: CAD file, 2020-08-24]
CAD Files/robot_belt_arm pleuel_bend_lower.stl
110.5 x 6.00 x 103.4
