20sffactory/community_robot_arm/CAD Files/robot_belt_arm leg.stl

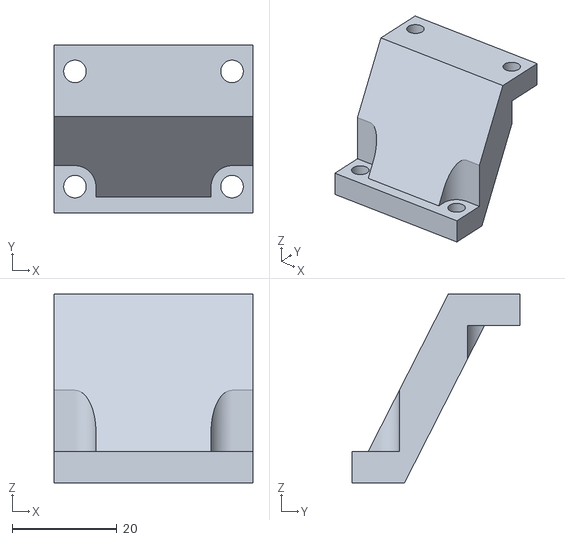
[picture p52: CAD file, 2020-08-24]
CAD Files/robot_belt_arm leg.stl
38.0 x 32.0 x 36.0
