20sffactory/community_robot_arm/CAD Files/robot_belt_arm lever.stl

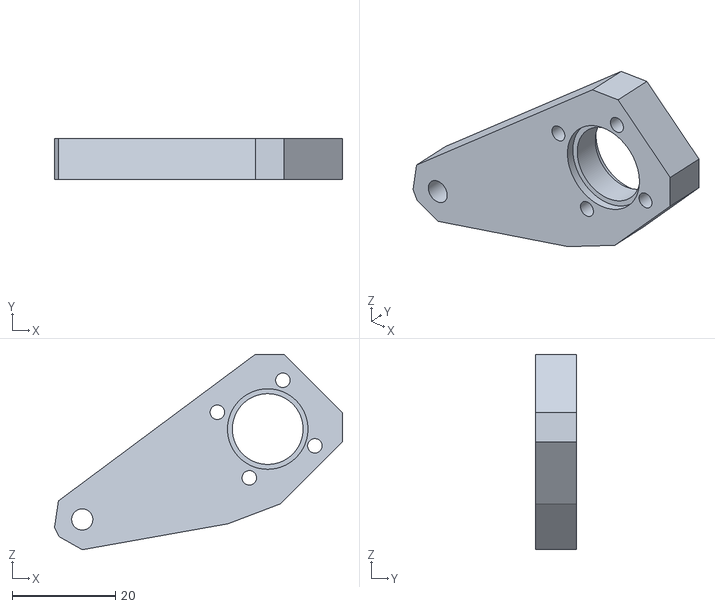
[picture p53: CAD file, 2020-08-24]
CAD Files/robot_belt_arm lever.stl
55.8 x 8.00 x 37.9
