20sffactory/community_robot_arm/CAD Files/robot_belt_arm pleuel_bend_upper.stl

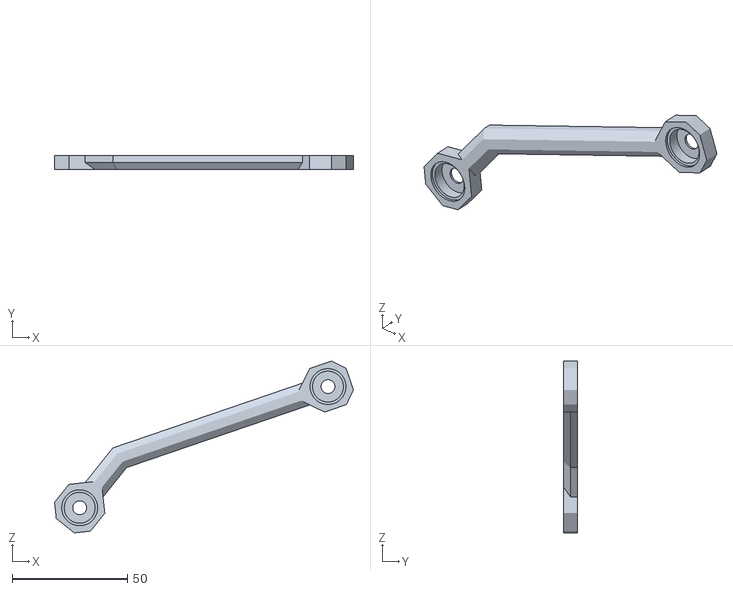
[picture p54: CAD file, 2020-08-24]
CAD Files/robot_belt_arm pleuel_bend_upper.stl
129.9 x 6.00 x 74.6
