20sffactory/community_robot_arm/CAD Files/robot_belt_arm pleuel.stl

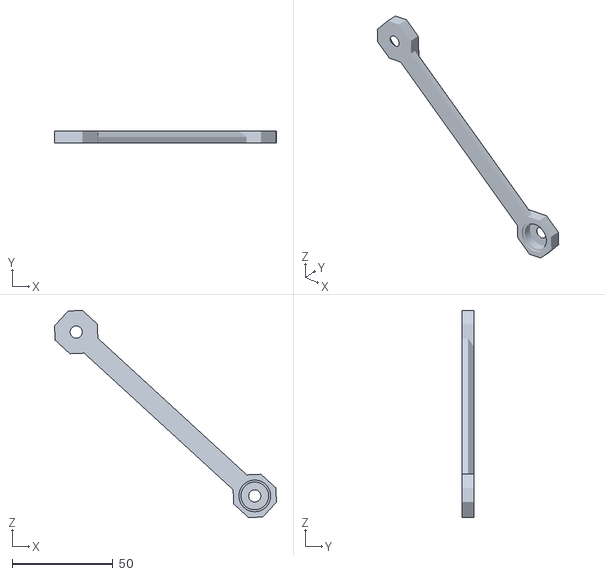
[picture p55: CAD file, 2020-08-24]
CAD Files/robot_belt_arm pleuel.stl
109.9 x 6.00 x 102.6
