20sffactory/community_robot_arm/CAD Files/robot_belt_arm endstop.stl

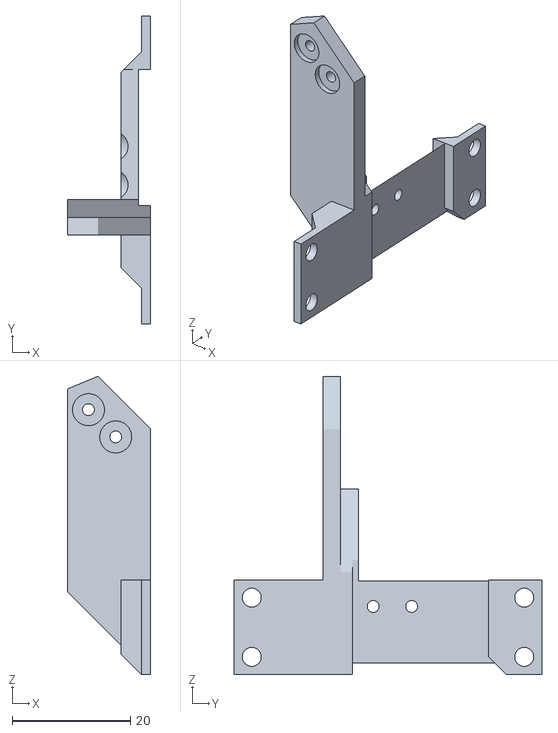
[picture p56: CAD file, 2020-08-24]
CAD Files/robot_belt_arm endstop.stl
14.0 x 52.0 x 50.4
