20sffactory/community_robot_arm/CAD Files/robot_belt_arm lower_shank.stl

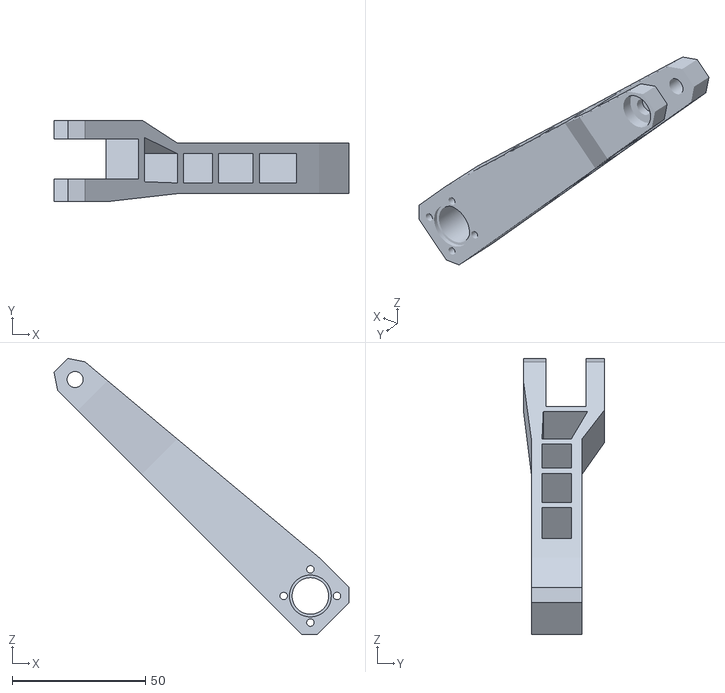
[picture p57: CAD file, 2020-08-24]
CAD Files/robot_belt_arm lower_shank.stl
110.7 x 30.5 x 103.7
