20sffactory/community_robot_arm/CAD Files/robot_belt_arm manipulator.stl

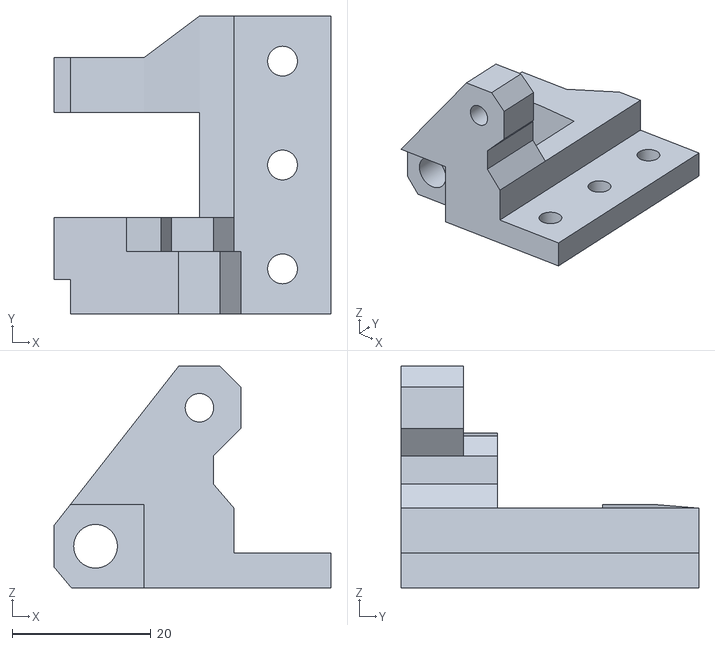
[picture p58: CAD file, 2020-08-24]
CAD Files/robot_belt_arm manipulator.stl
40.0 x 43.0 x 32.0
