20sffactory/community_robot_arm/(list of files, cad)

Other CAD files:
CAD Files/case_grill.stl
CAD Files/dual_manipulator_support/main_body_dual.stl
CAD Files/robot_belt_arm main_body.stl
CAD Files/robot_belt_arm socket.stl
CAD Files/toolheads_stl/28byj_cover_by_woutervanschaik/Cap.stl
CAD Files/toolheads_stl/servo_gripper_stl_by_20sffactory/gripper_screw_secure.stl
