20sffactory/community_robot_arm/Assembly & Control Guides/Assembly Guide/01 - basering.jpg

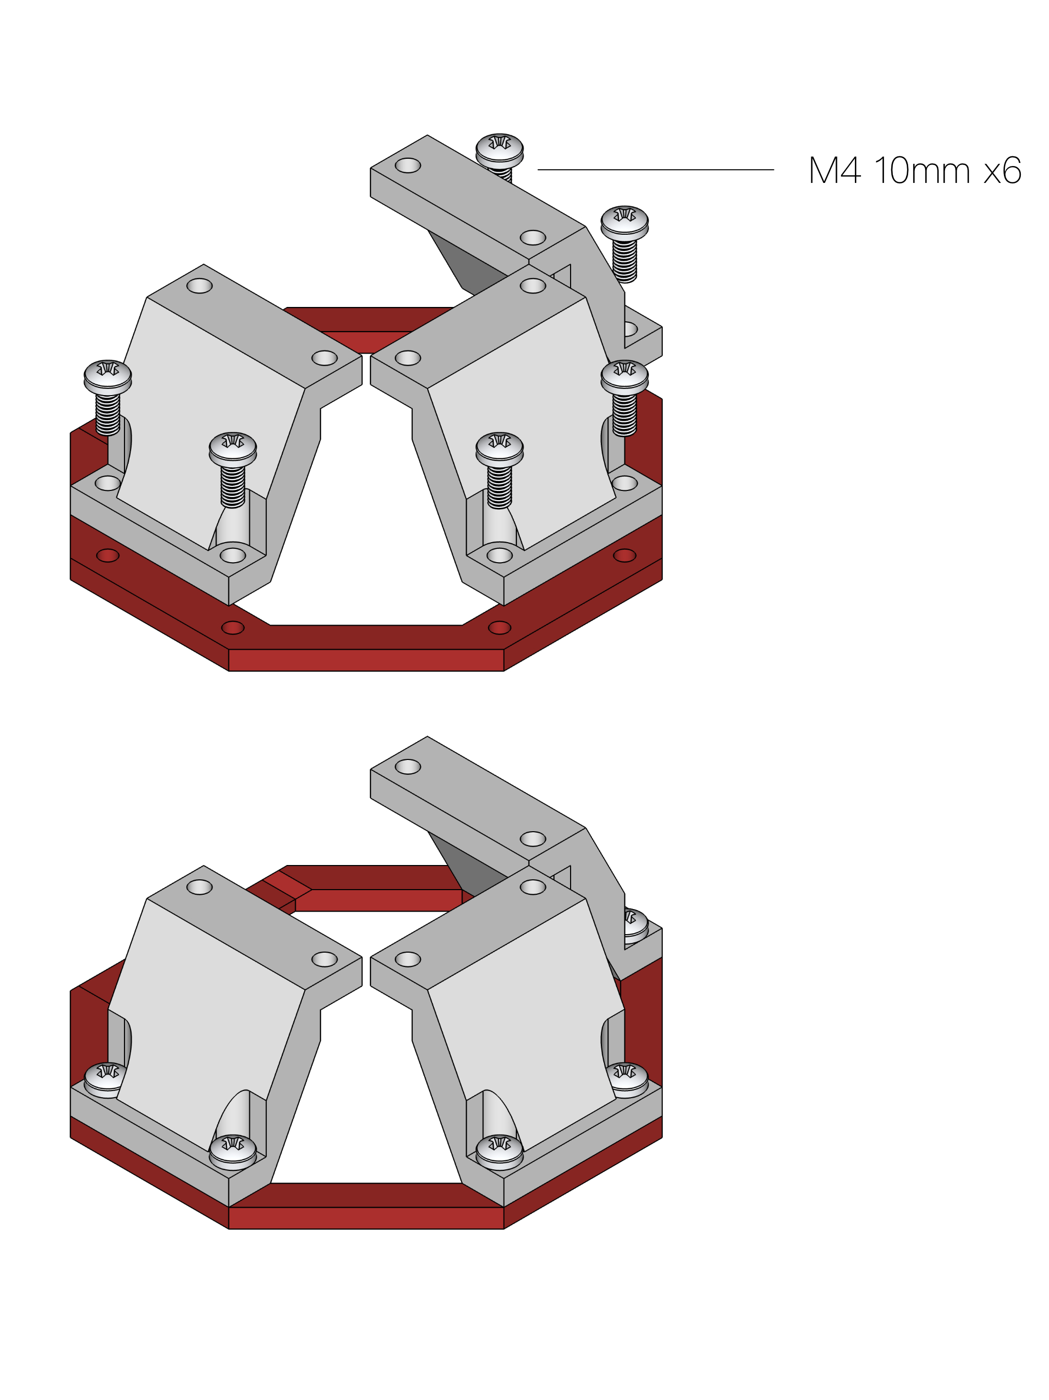
Assembly & Control Guides/Assembly Guide/01 - basering.jpg
