20sffactory/community_robot_arm/Assembly & Control Guides/Assembly Guide/02 - socket.jpg

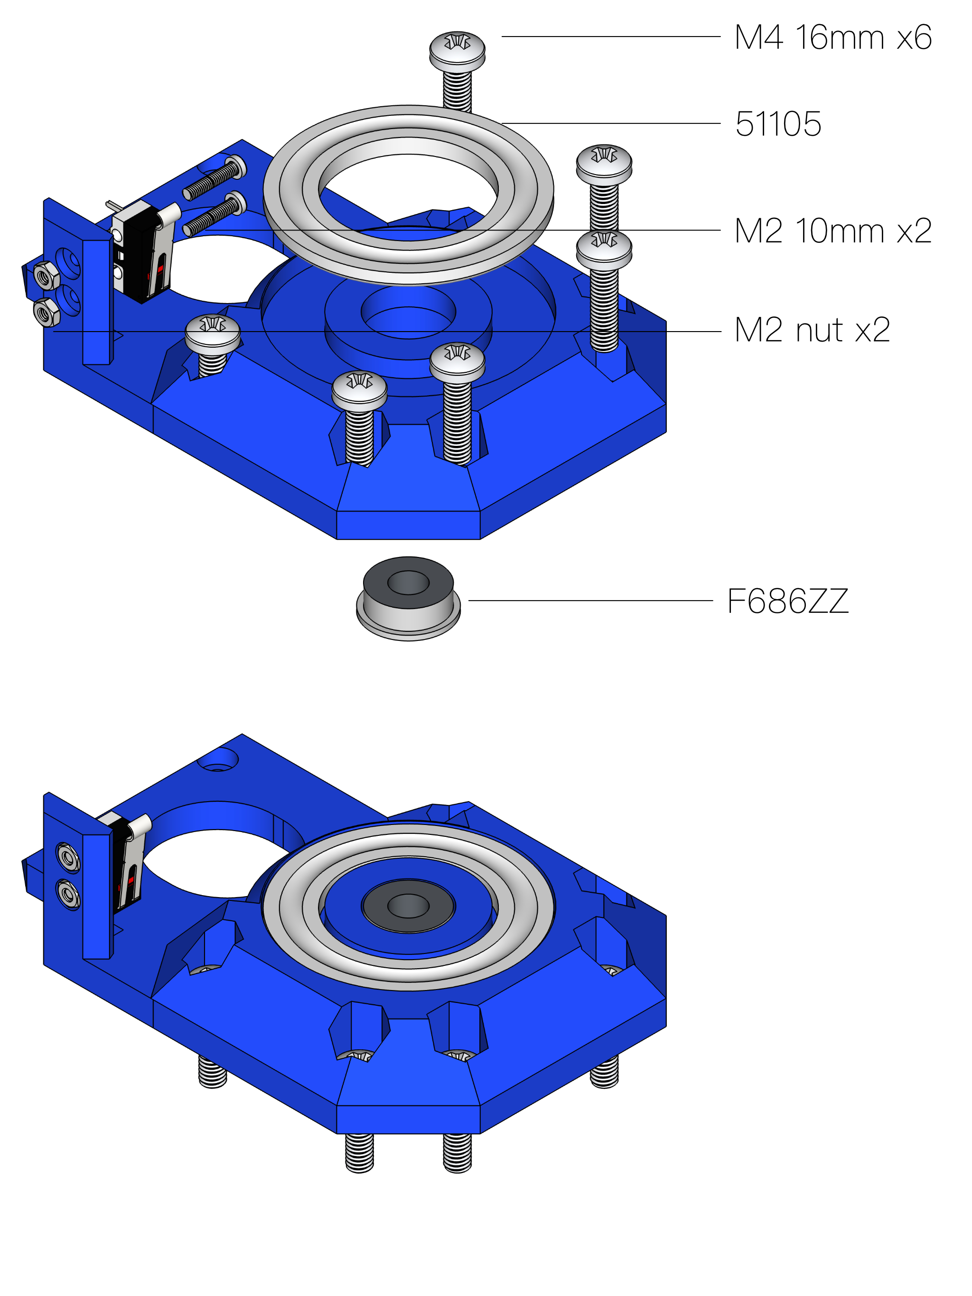
Assembly & Control Guides/Assembly Guide/02 - socket.jpg
