20sffactory/community_robot_arm/Assembly & Control Guides/Assembly Guide/03 - base.jpg

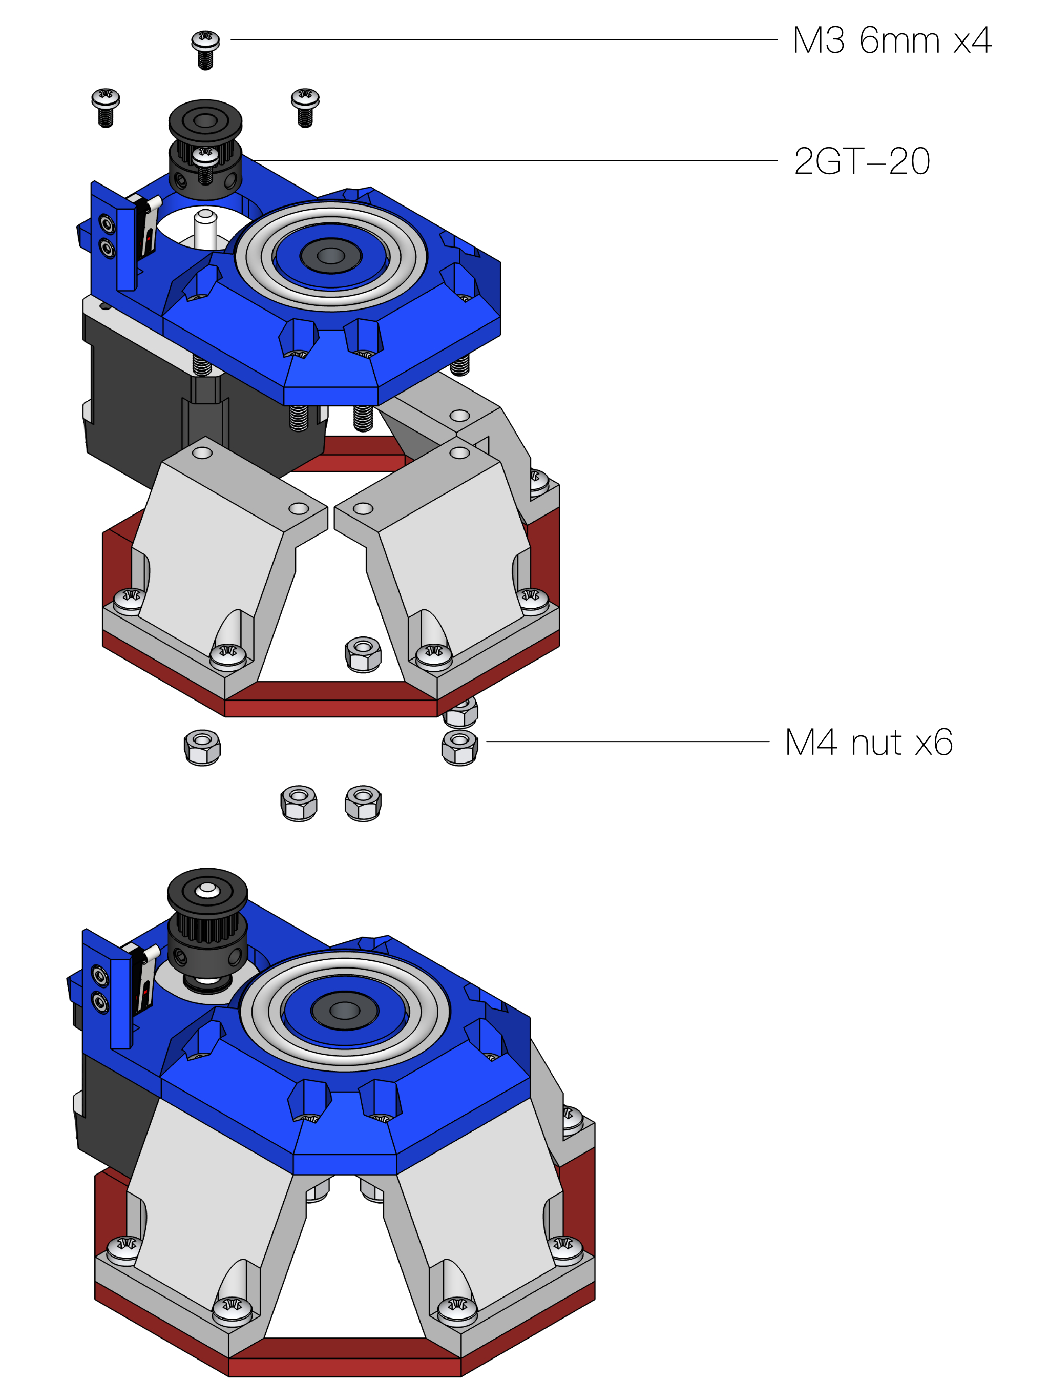
Assembly & Control Guides/Assembly Guide/03 - base.jpg
