20sffactory/community_robot_arm/Assembly & Control Guides/Assembly Guide/04 - rotategear.jpg

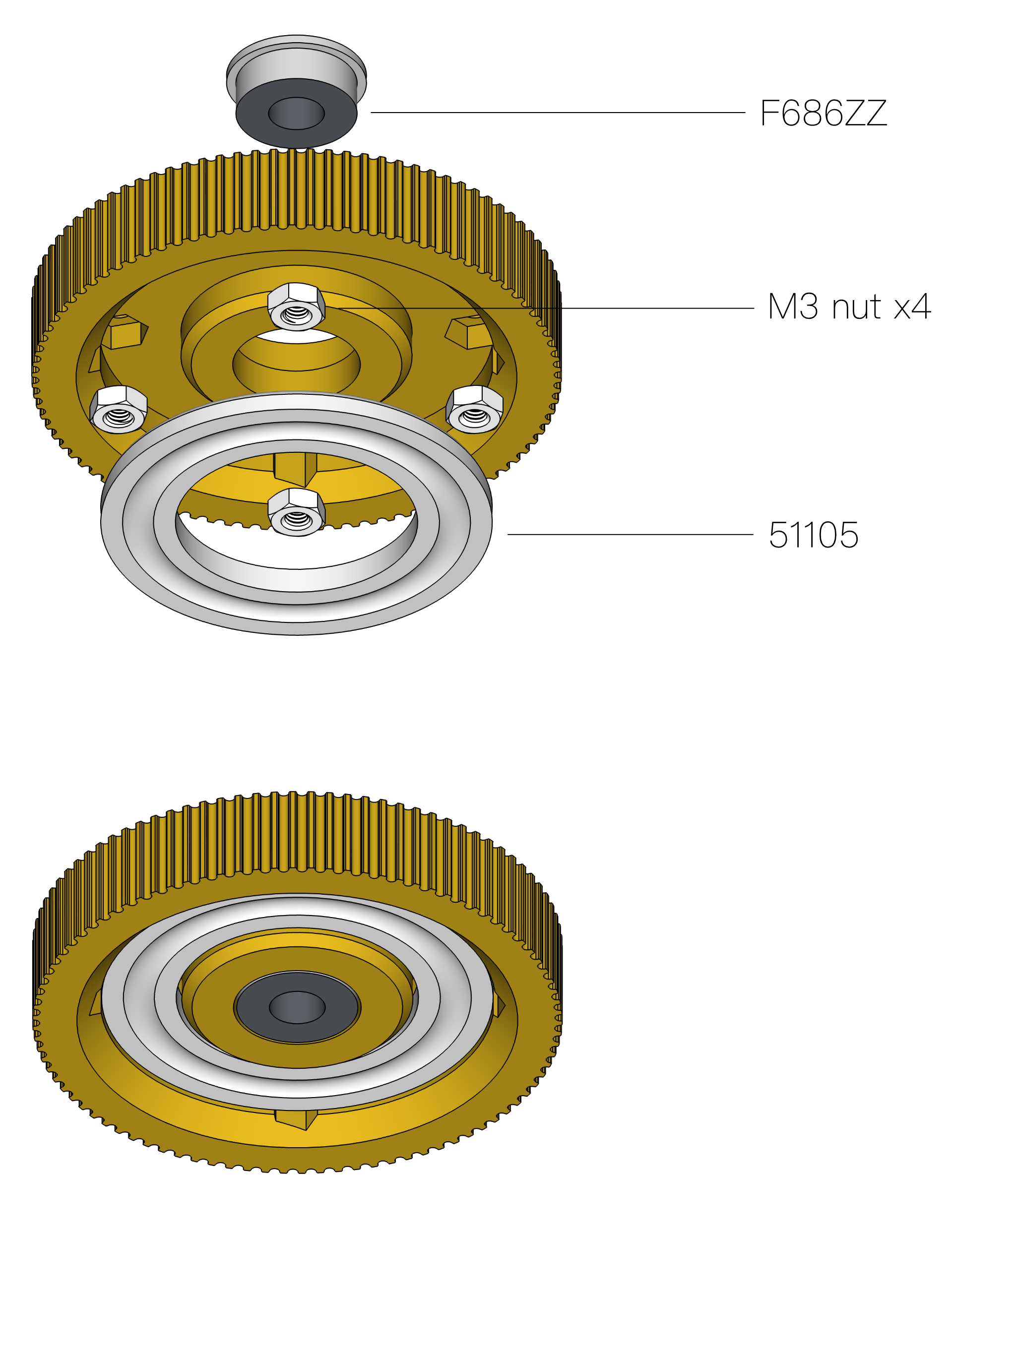
Assembly & Control Guides/Assembly Guide/04 - rotategear.jpg
