20sffactory/community_robot_arm/Assembly & Control Guides/Assembly Guide/05 - rotate_base.jpg

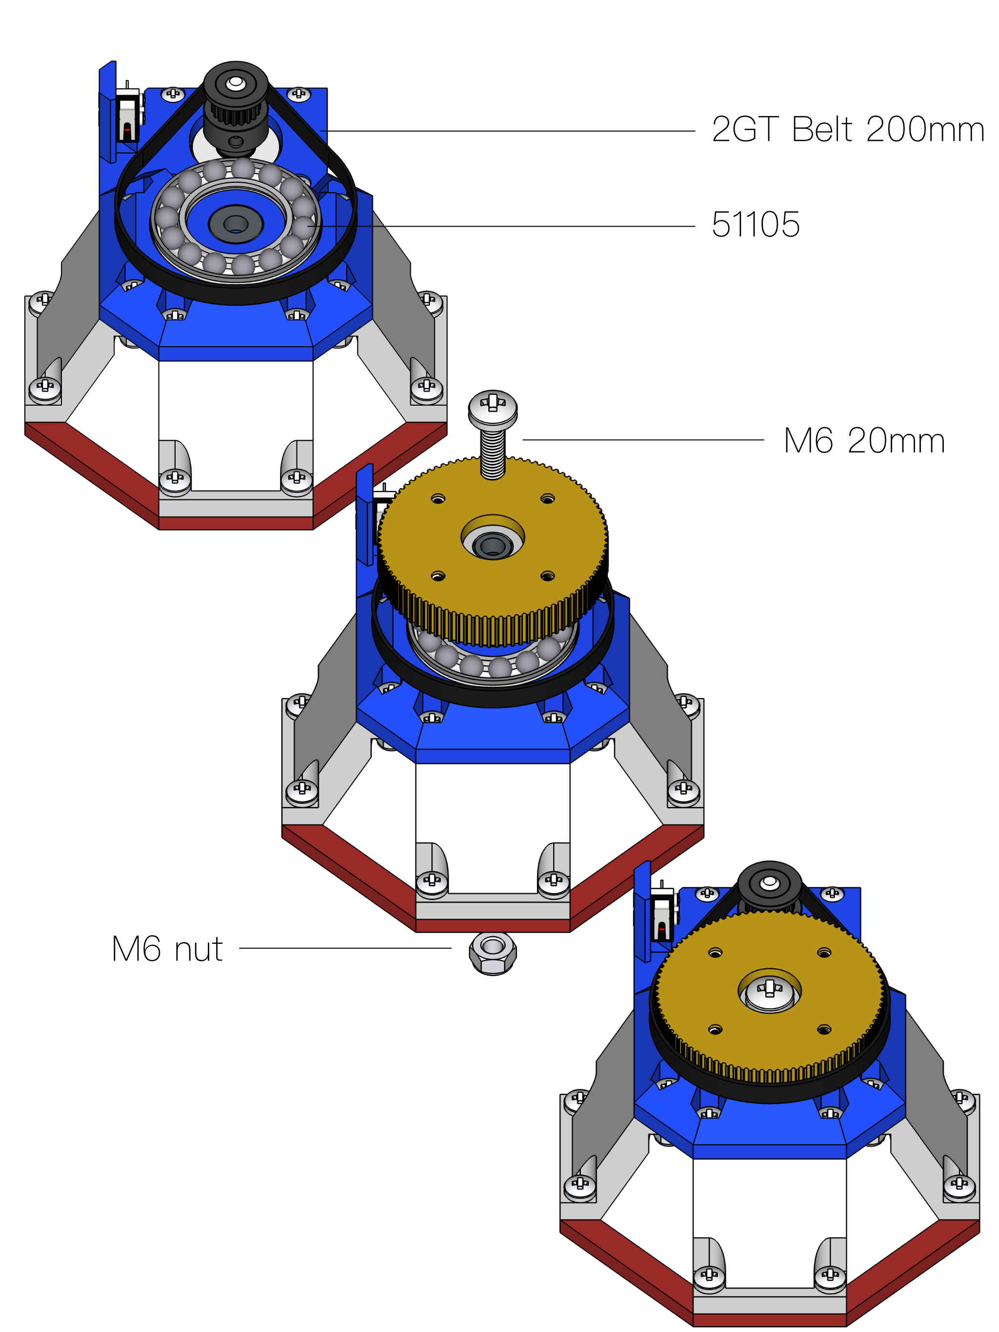
Assembly & Control Guides/Assembly Guide/05 - rotate_base.jpg
