20sffactory/community_robot_arm/Assembly & Control Guides/Assembly Guide/06 - body_base.jpg

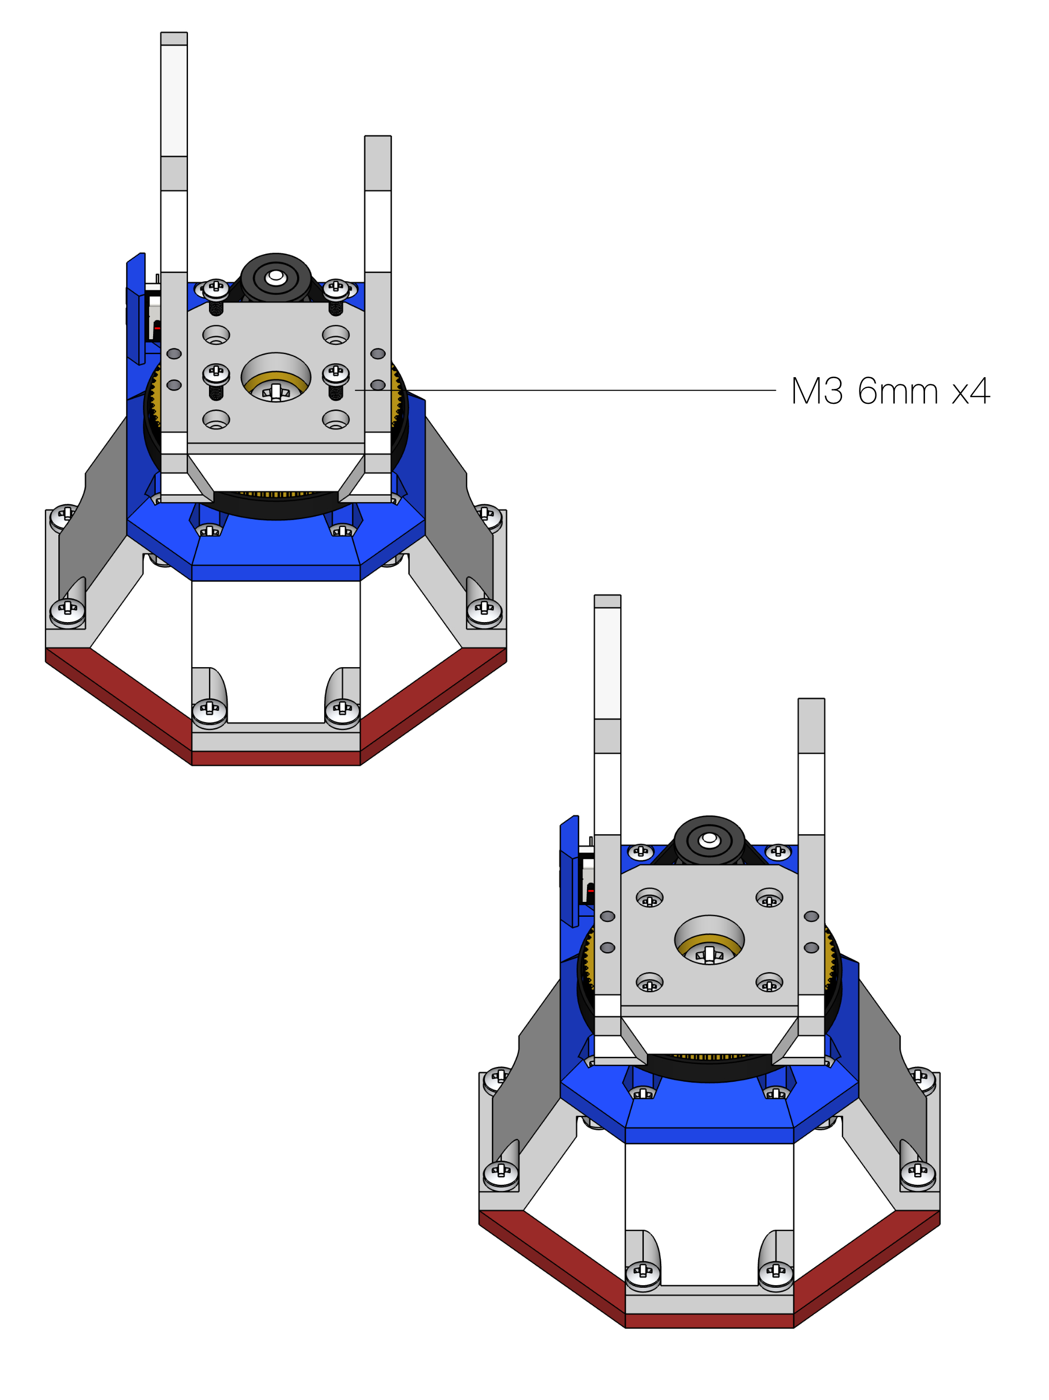
Assembly & Control Guides/Assembly Guide/06 - body_base.jpg
