20sffactory/community_robot_arm/Assembly & Control Guides/Assembly Guide/07 - steppers.jpg

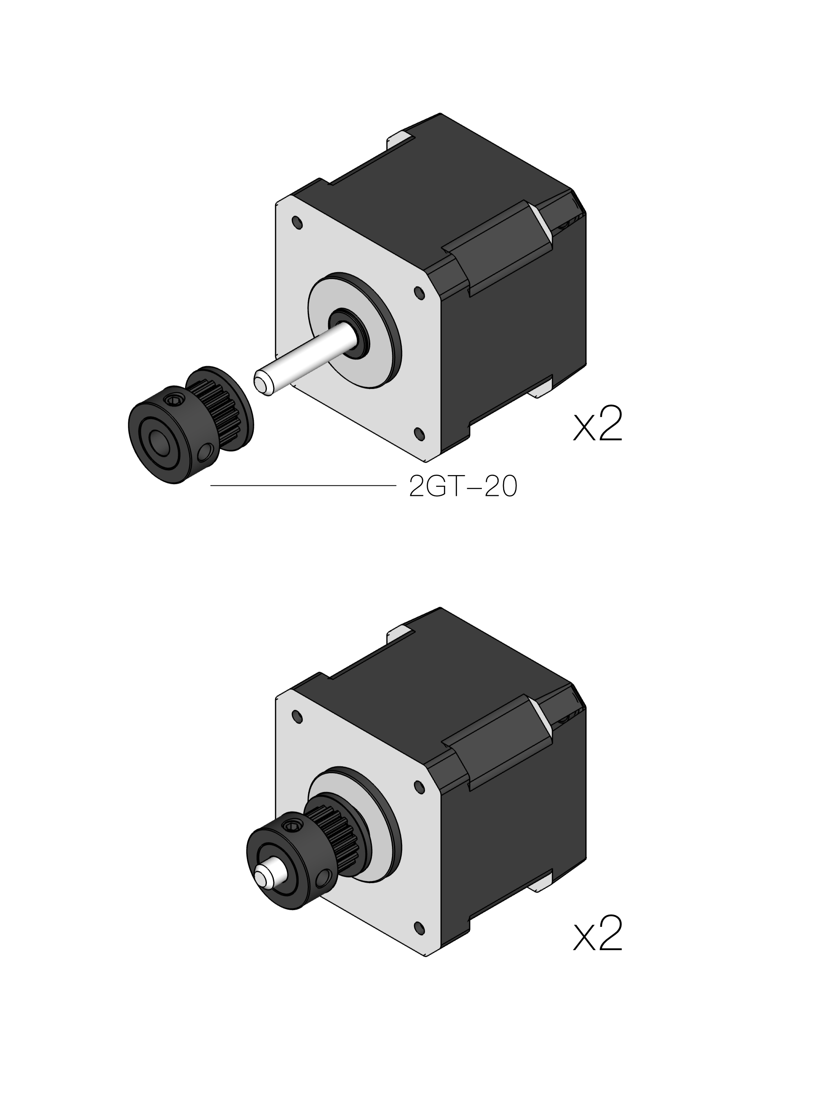
Assembly & Control Guides/Assembly Guide/07 - steppers.jpg
