20sffactory/community_robot_arm/Assembly & Control Guides/Assembly Guide/08 - upper_motor.jpg

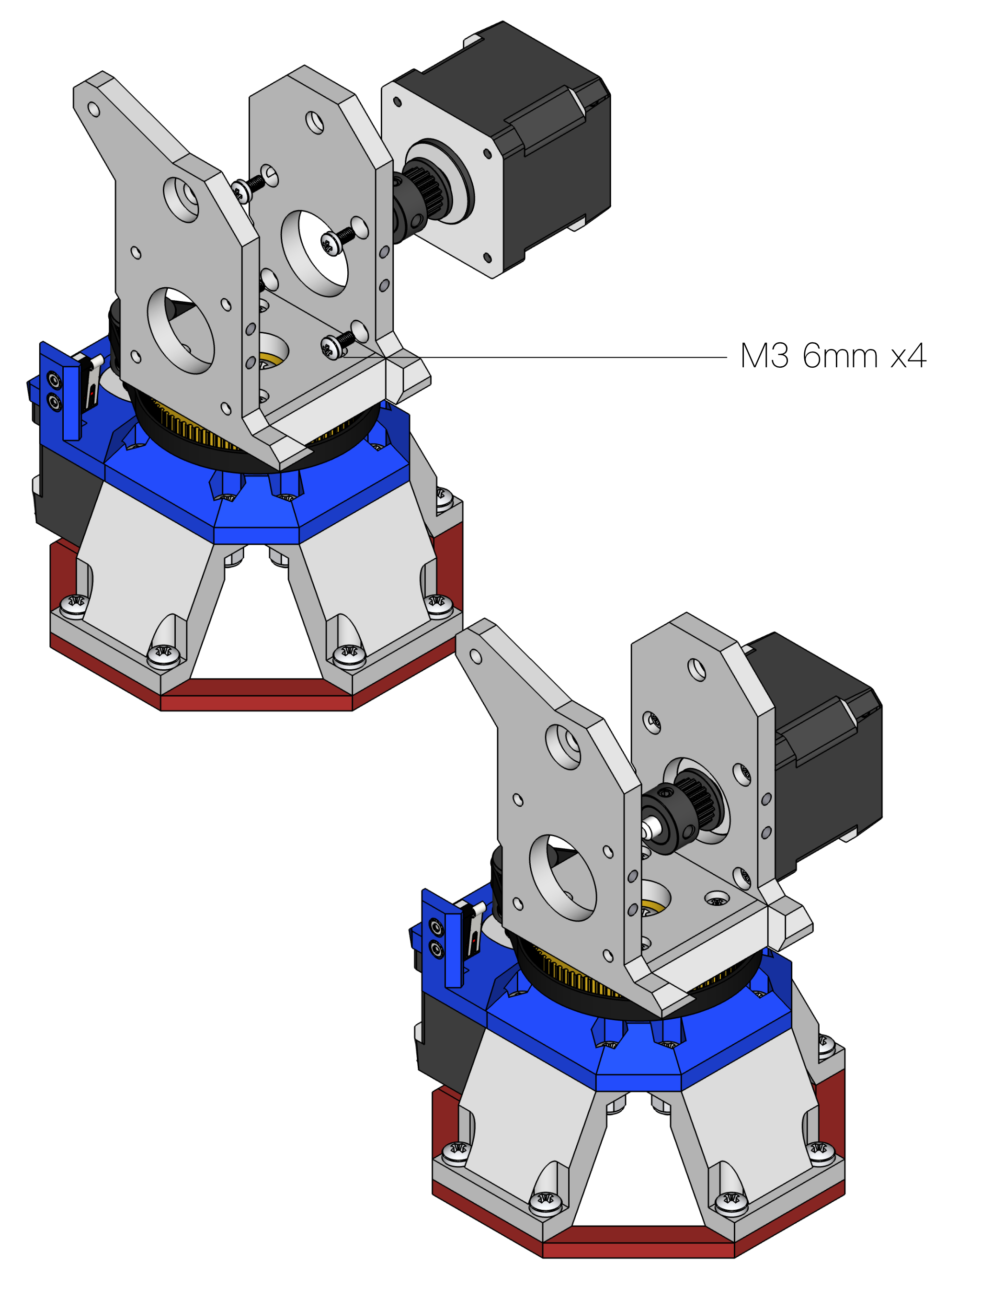
Assembly & Control Guides/Assembly Guide/08 - upper_motor.jpg
