20sffactory/community_robot_arm/Assembly & Control Guides/Assembly Guide/09 - lower_motor.jpg

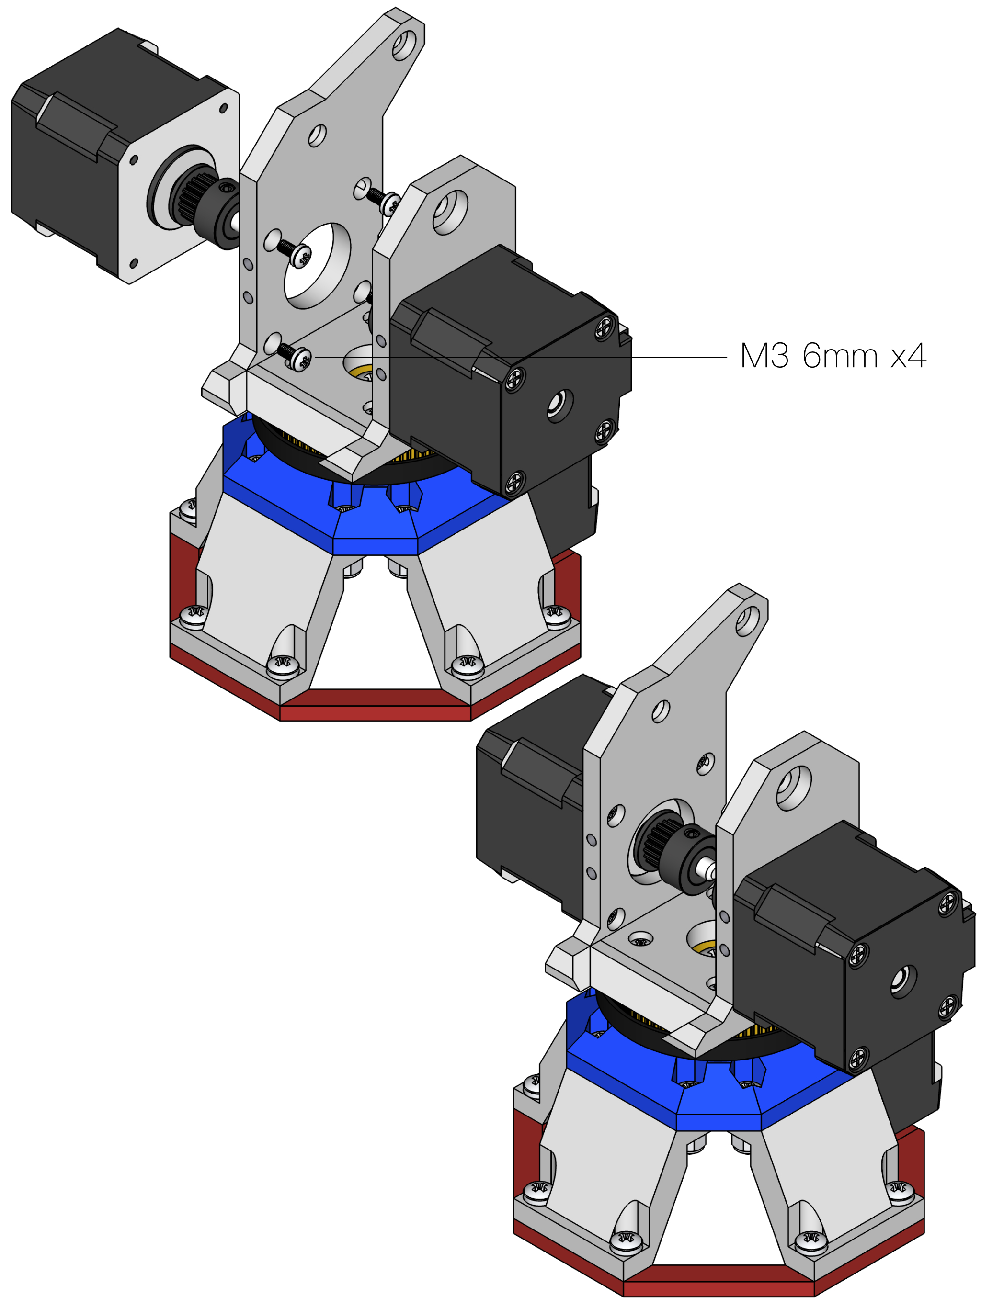
Assembly & Control Guides/Assembly Guide/09 - lower_motor.jpg
