20sffactory/community_robot_arm/Assembly & Control Guides/Assembly Guide/10 - endstop.jpg

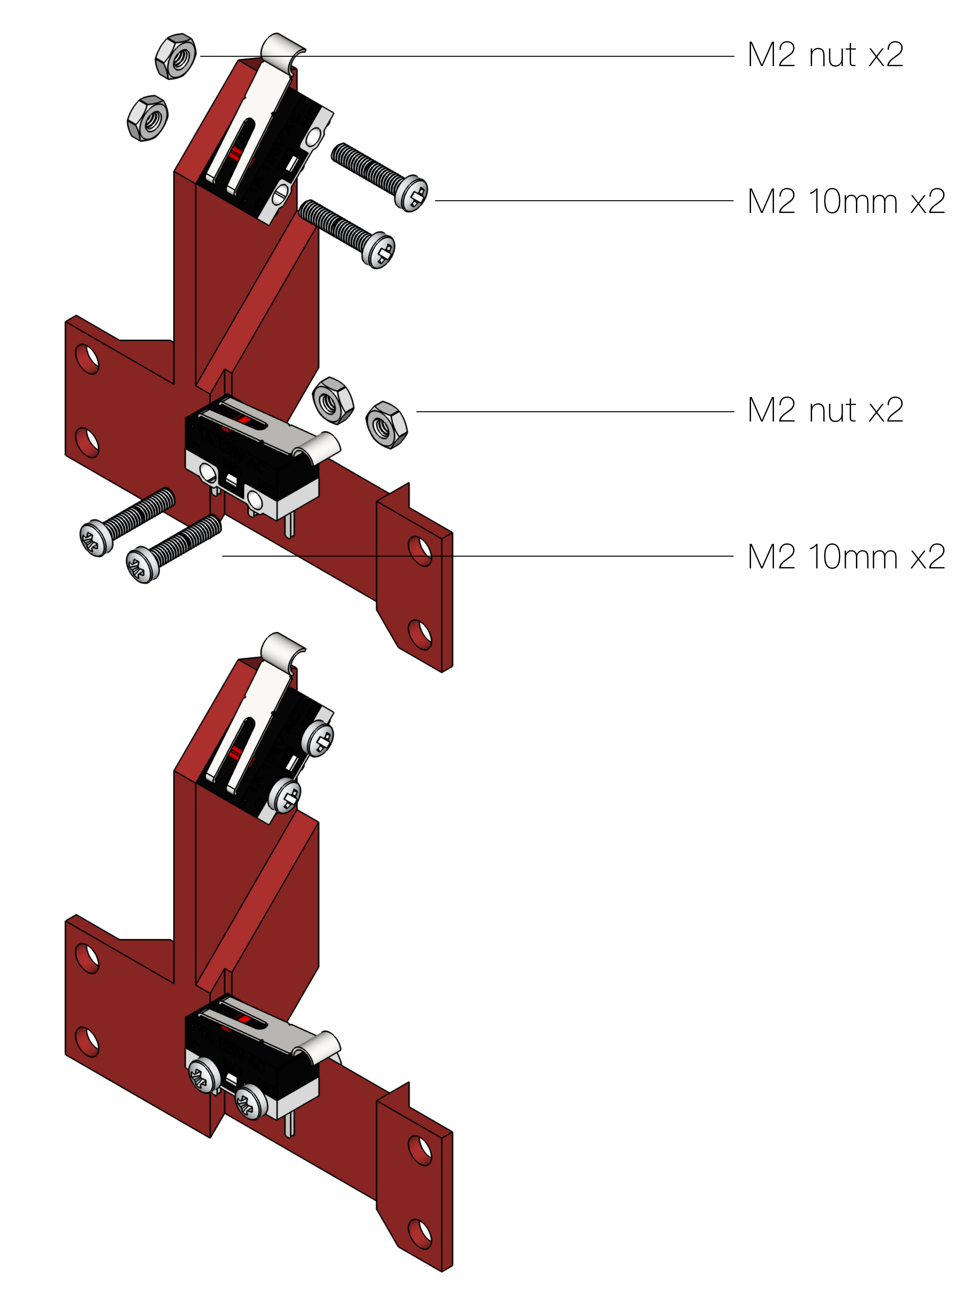
Assembly & Control Guides/Assembly Guide/10 - endstop.jpg
