20sffactory/community_robot_arm/Assembly & Control Guides/Assembly Guide/11 - lever.jpg

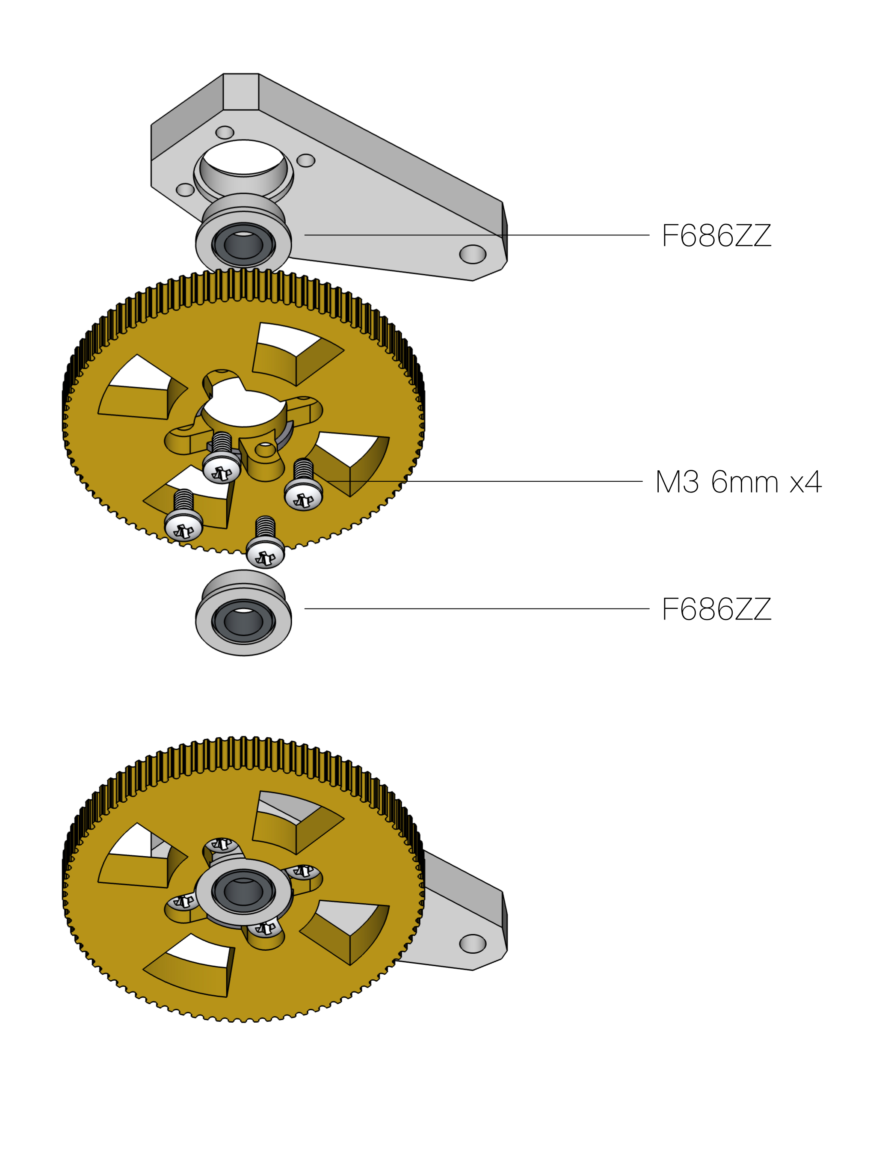
Assembly & Control Guides/Assembly Guide/11 - lever.jpg
