20sffactory/community_robot_arm/Assembly & Control Guides/Assembly Guide/12 - lowershank.jpg

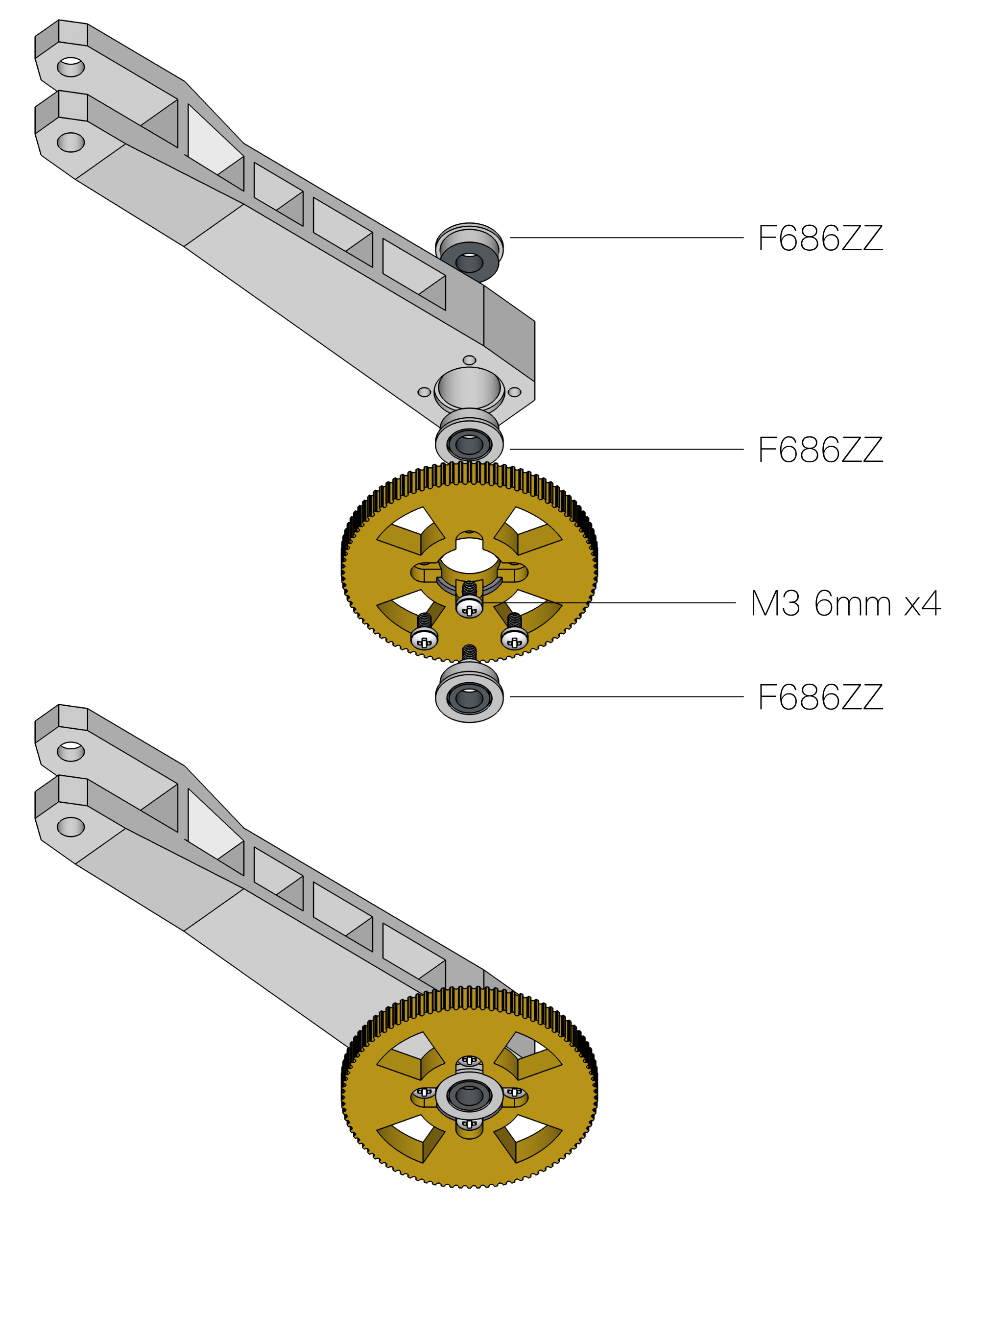
Assembly & Control Guides/Assembly Guide/12 - lowershank.jpg
