20sffactory/community_robot_arm/Assembly & Control Guides/Assembly Guide/13 - lever_belt.jpg

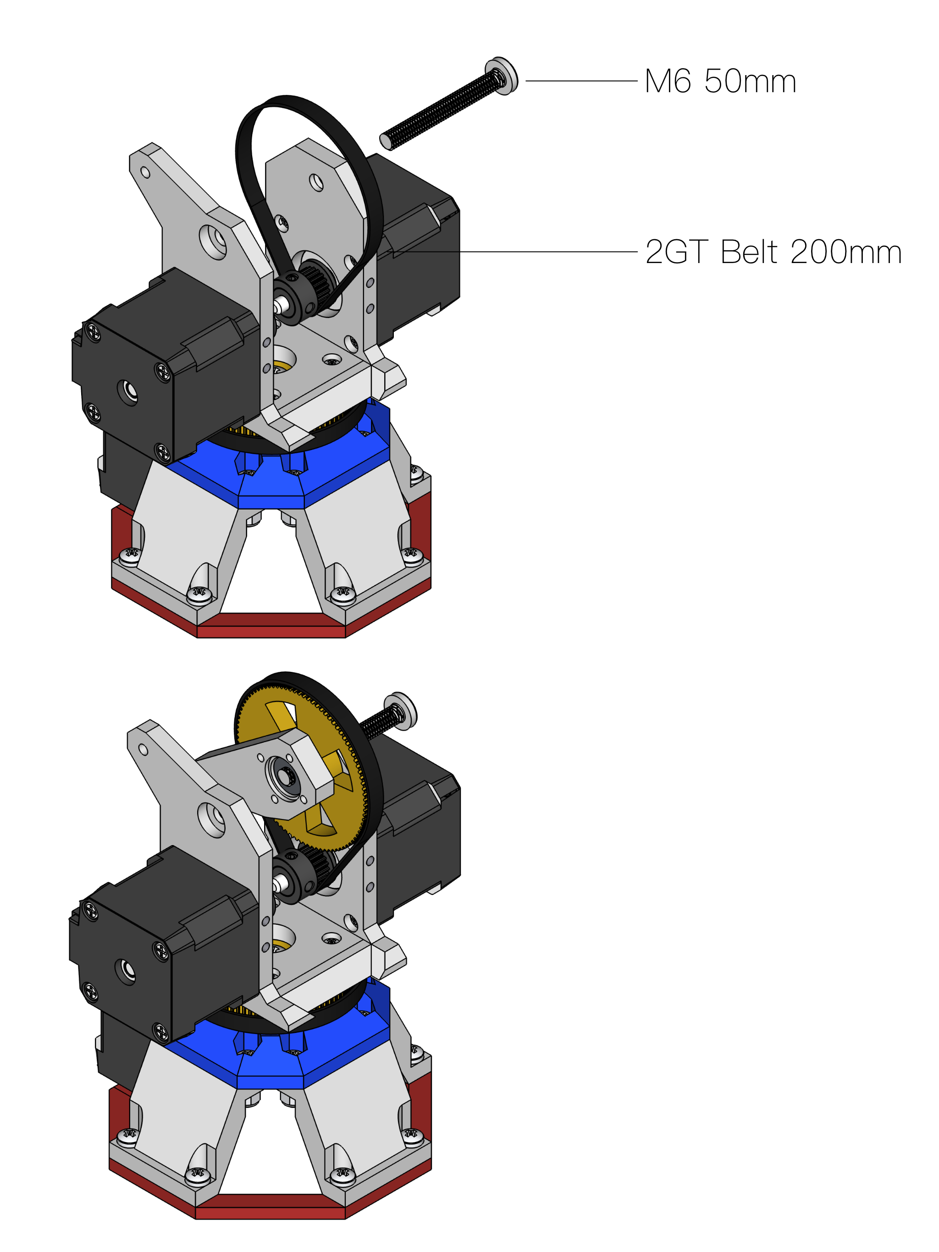
Assembly & Control Guides/Assembly Guide/13 - lever_belt.jpg
