20sffactory/community_robot_arm/Assembly & Control Guides/Assembly Guide/14 - lowershank_belt.jpg

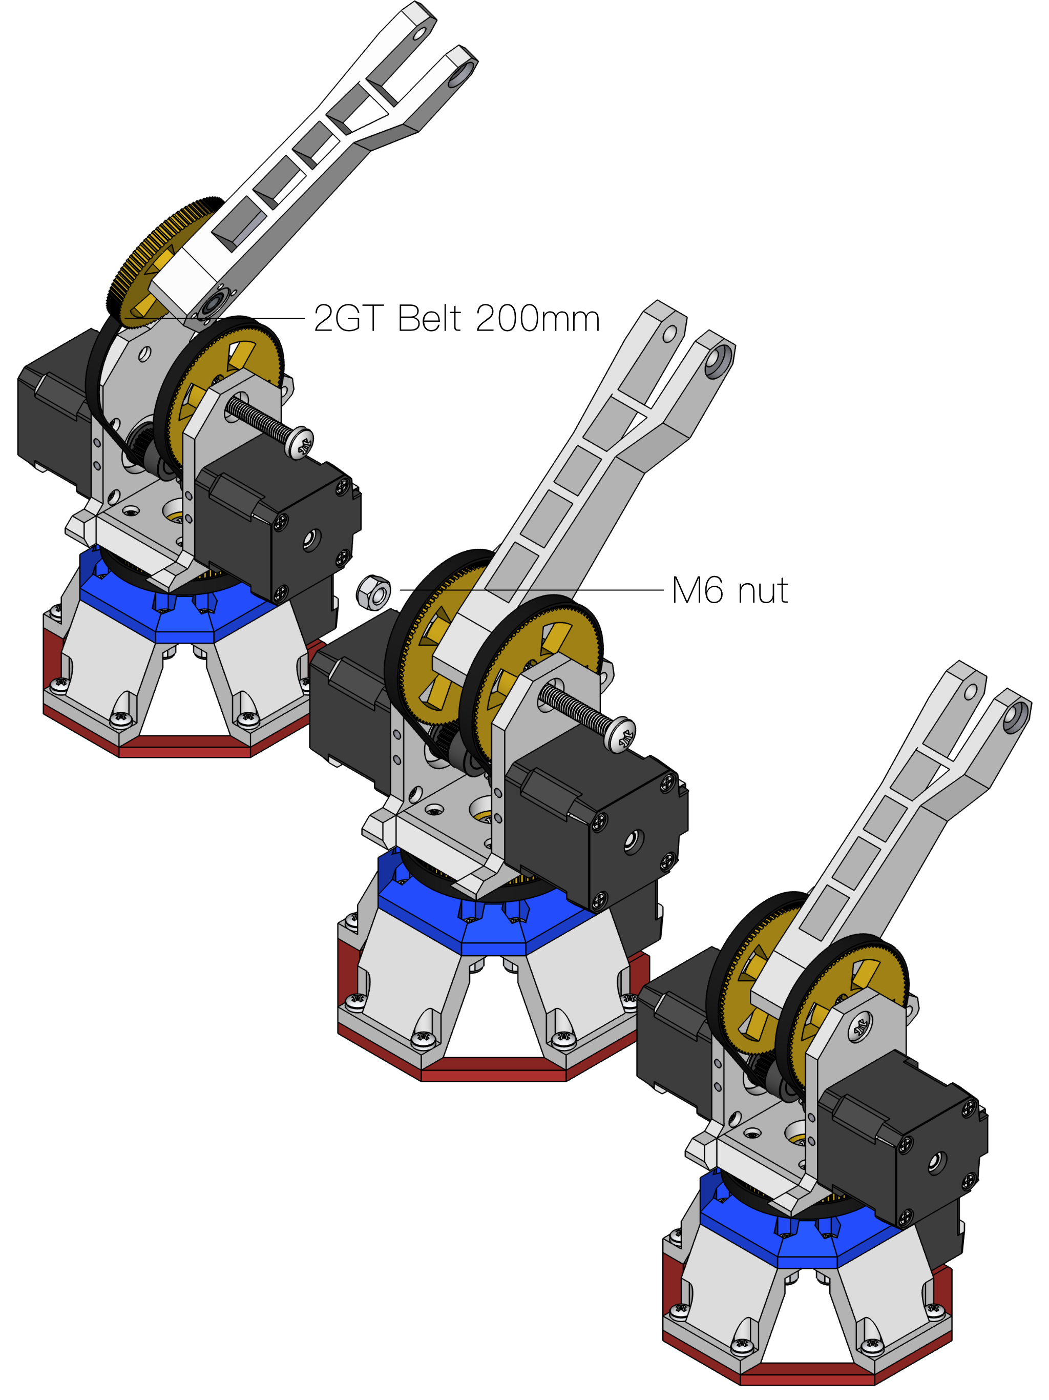
Assembly & Control Guides/Assembly Guide/14 - lowershank_belt.jpg
