20sffactory/community_robot_arm/Assembly & Control Guides/Assembly Guide/15 - stabilizer.png

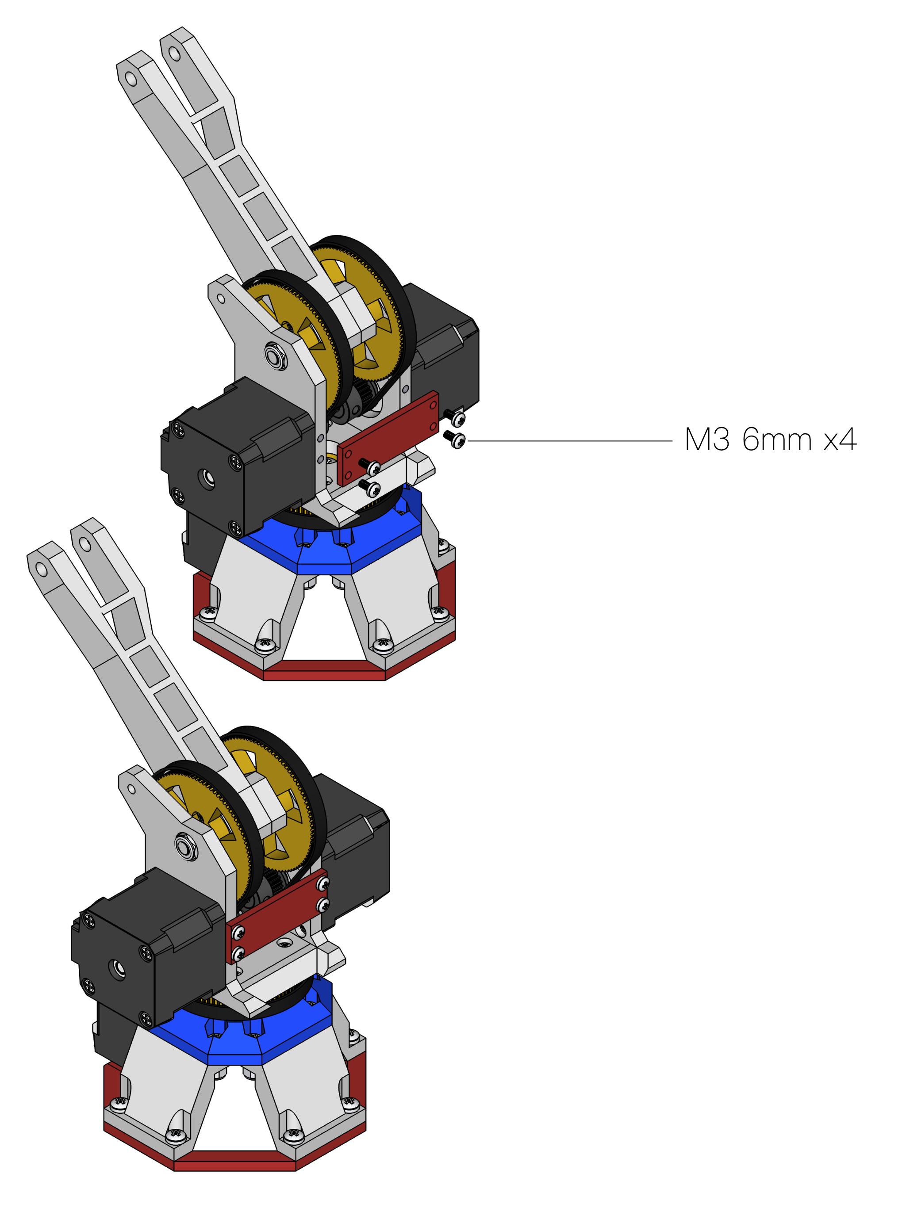
Assembly & Control Guides/Assembly Guide/15 - stabilizer.png
