20sffactory/community_robot_arm/Assembly & Control Guides/Assembly Guide/16 - endstop_body.jpg

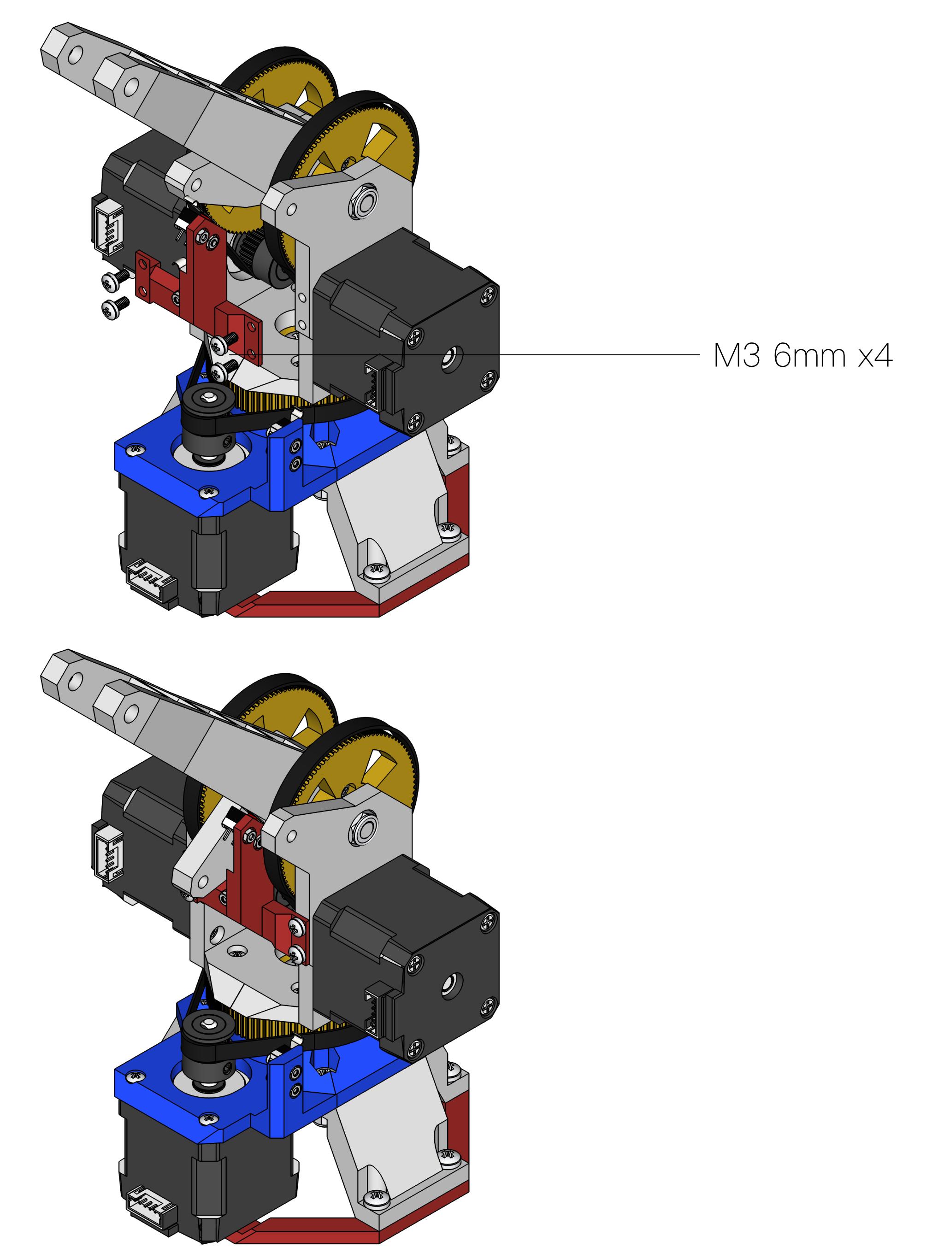
Assembly & Control Guides/Assembly Guide/16 - endstop_body.jpg
