20sffactory/community_robot_arm/Assembly & Control Guides/Assembly Guide/16 - triplate.jpg

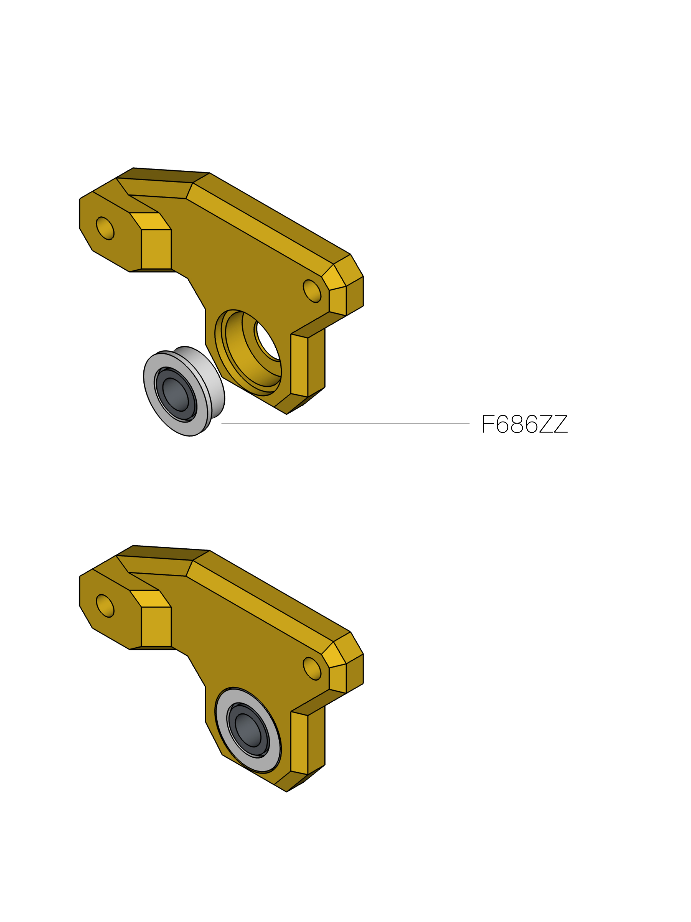
Assembly & Control Guides/Assembly Guide/16 - triplate.jpg
