20sffactory/community_robot_arm/Assembly & Control Guides/Assembly Guide/17 - pleuel.jpg

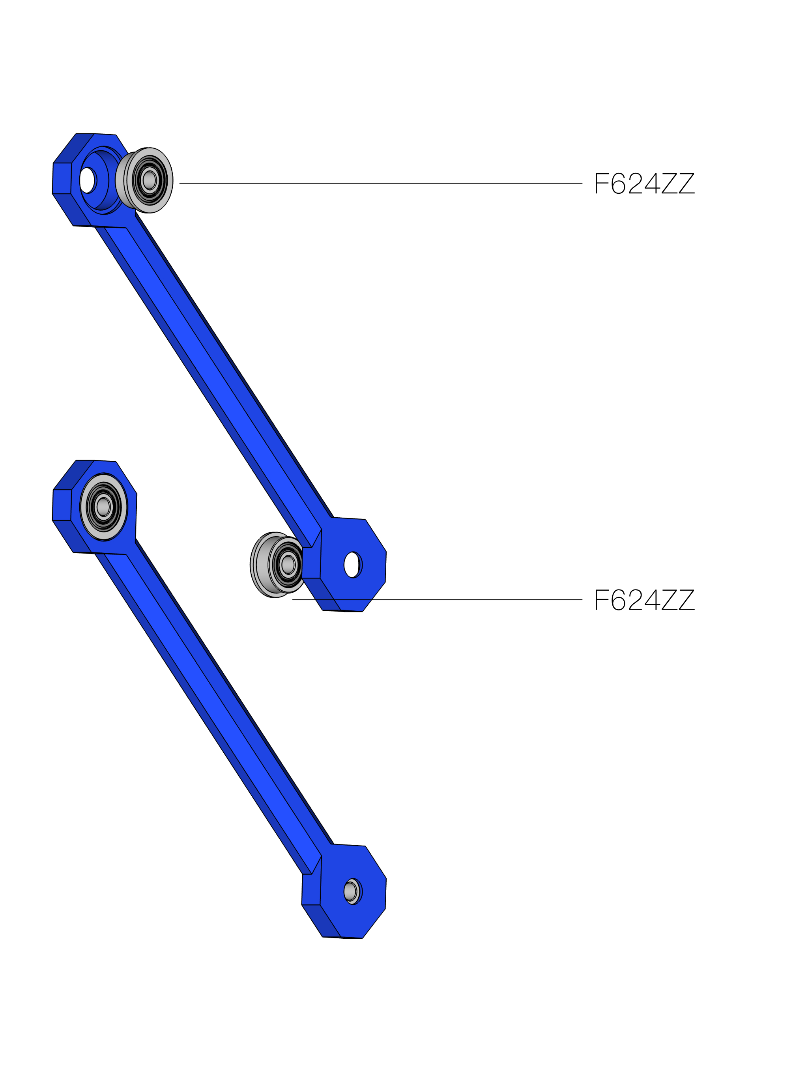
Assembly & Control Guides/Assembly Guide/17 - pleuel.jpg
