20sffactory/community_robot_arm/Assembly & Control Guides/Assembly Guide/18 - pleuel_bend_lower.jpg

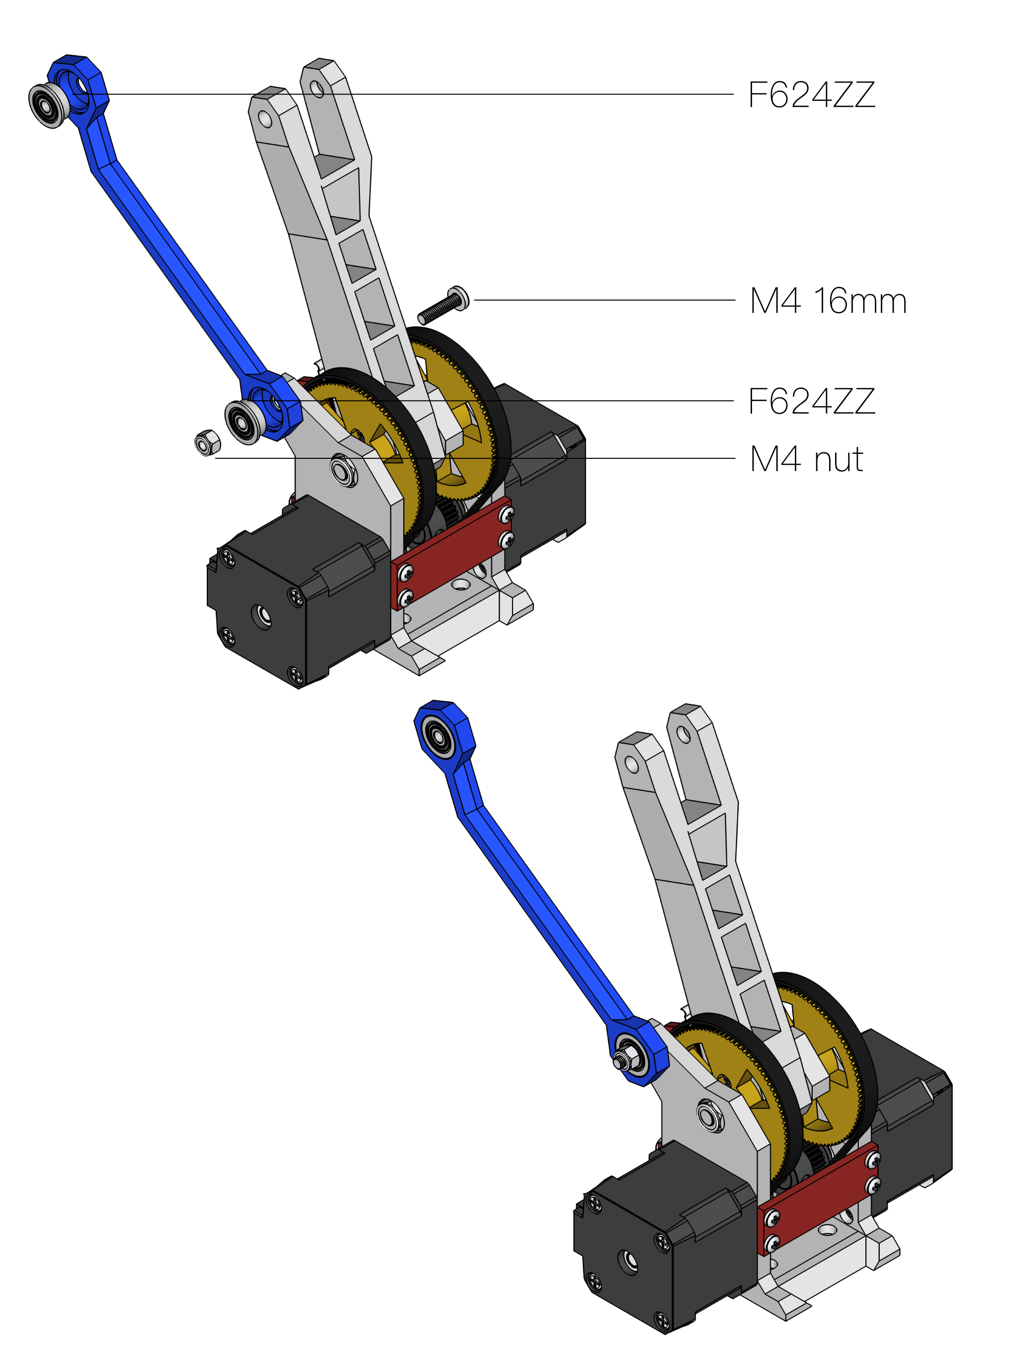
Assembly & Control Guides/Assembly Guide/18 - pleuel_bend_lower.jpg
