20sffactory/community_robot_arm/Assembly & Control Guides/Assembly Guide/19 - pleuel_lever.jpg

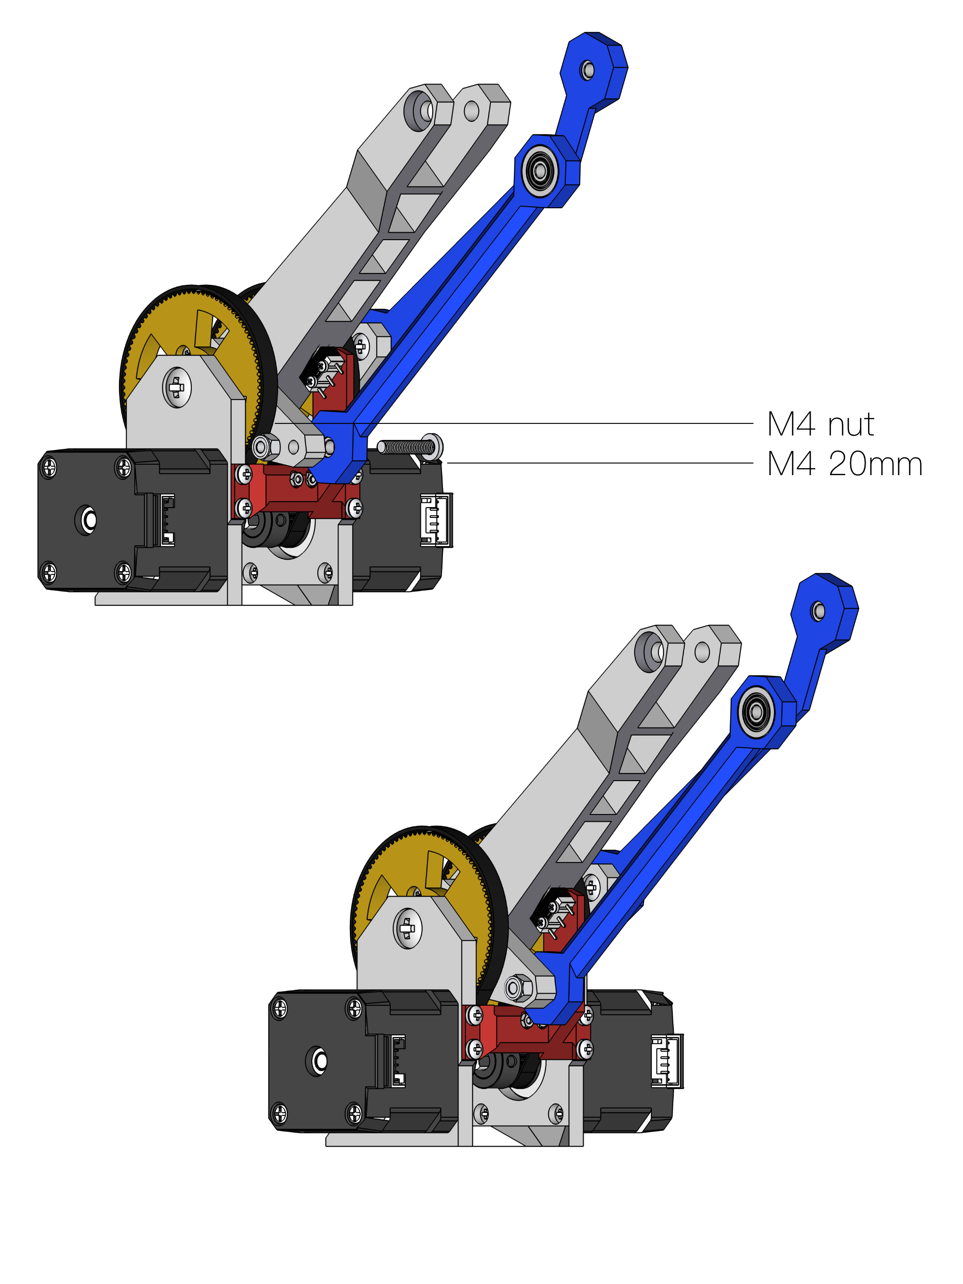
Assembly & Control Guides/Assembly Guide/19 - pleuel_lever.jpg
