20sffactory/community_robot_arm/Assembly & Control Guides/Assembly Guide/20 - upper_shank.jpg

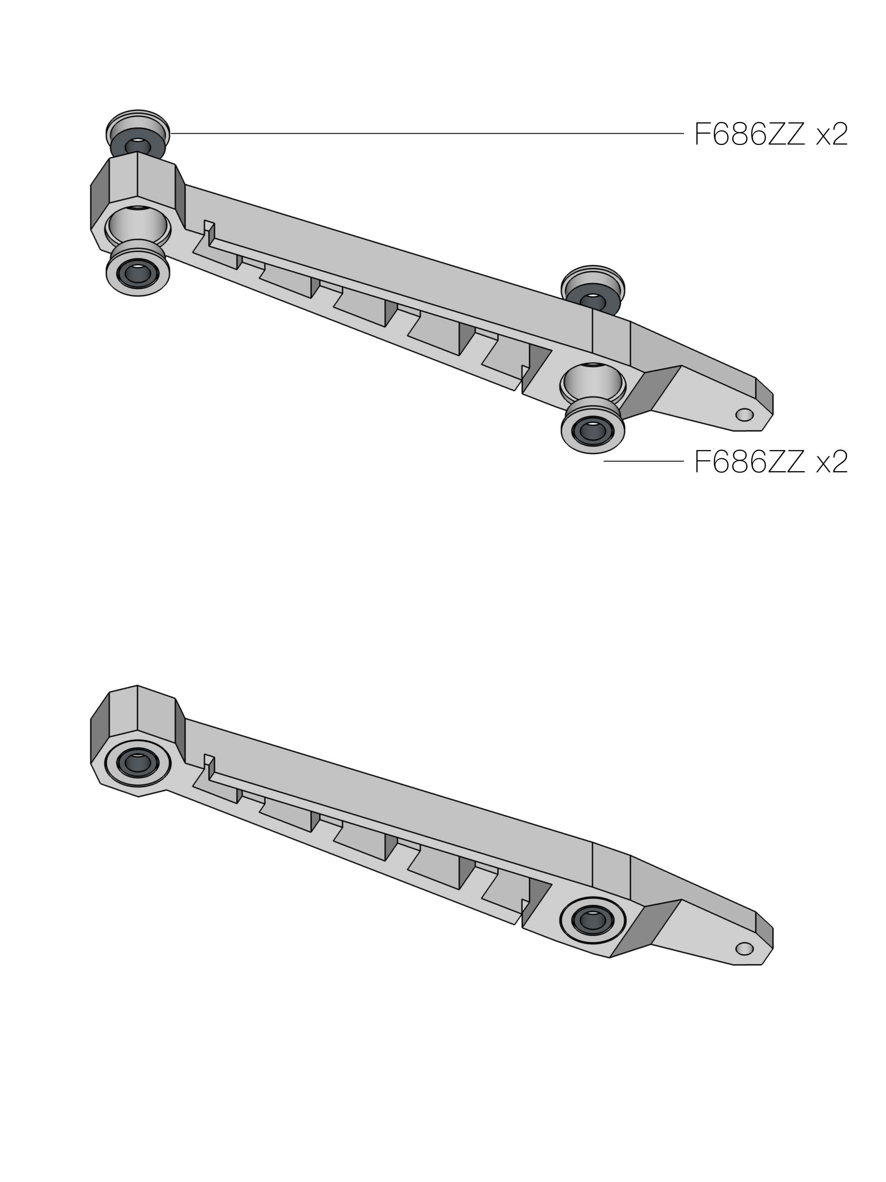
Assembly & Control Guides/Assembly Guide/20 - upper_shank.jpg
