20sffactory/community_robot_arm/Assembly & Control Guides/Assembly Guide/21 - pleuel_shank.jpg

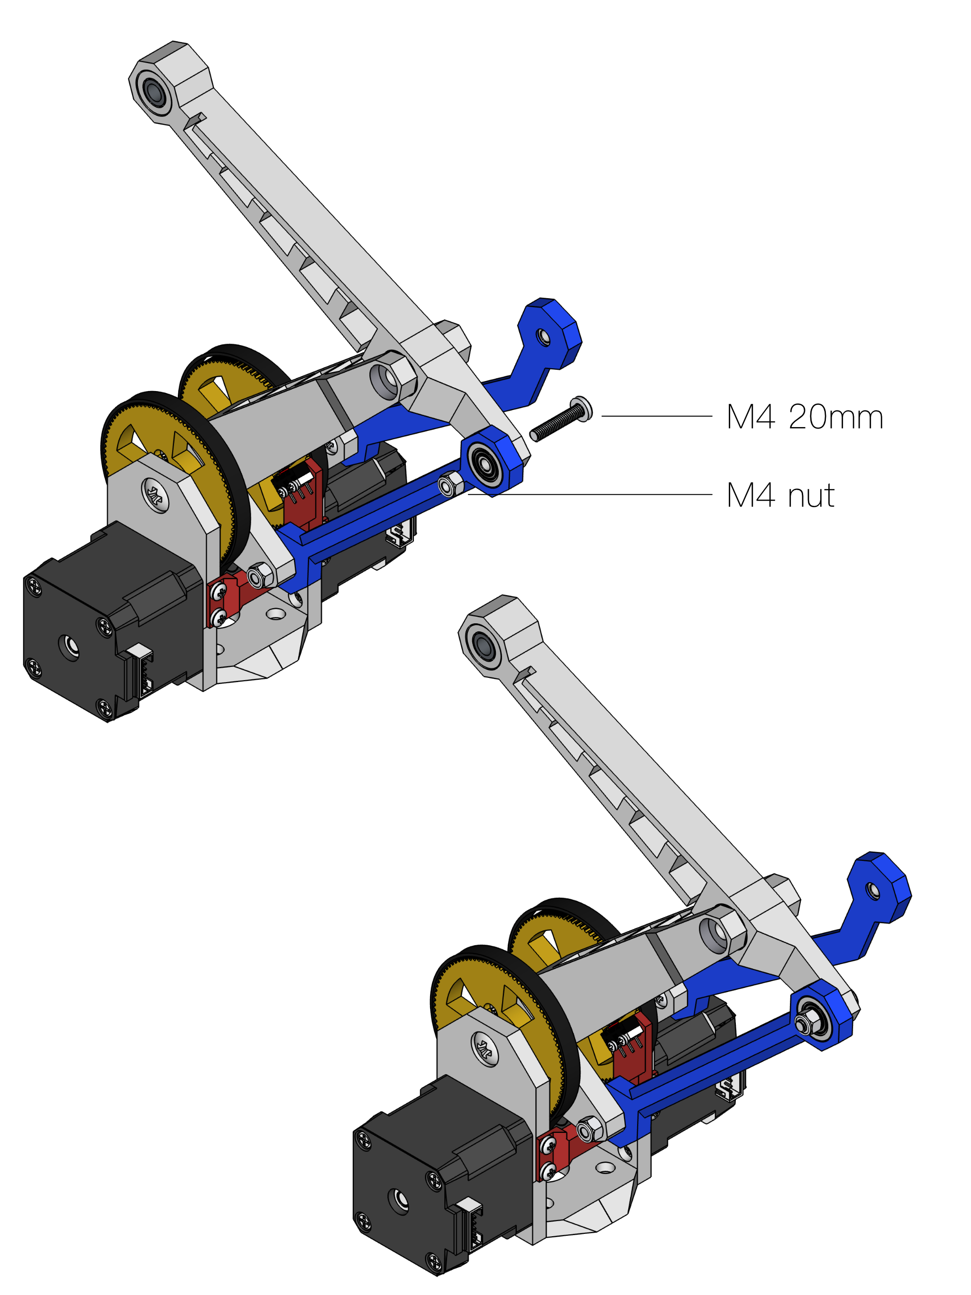
Assembly & Control Guides/Assembly Guide/21 - pleuel_shank.jpg
