20sffactory/community_robot_arm/Assembly & Control Guides/Assembly Guide/22 - manipulator.jpg

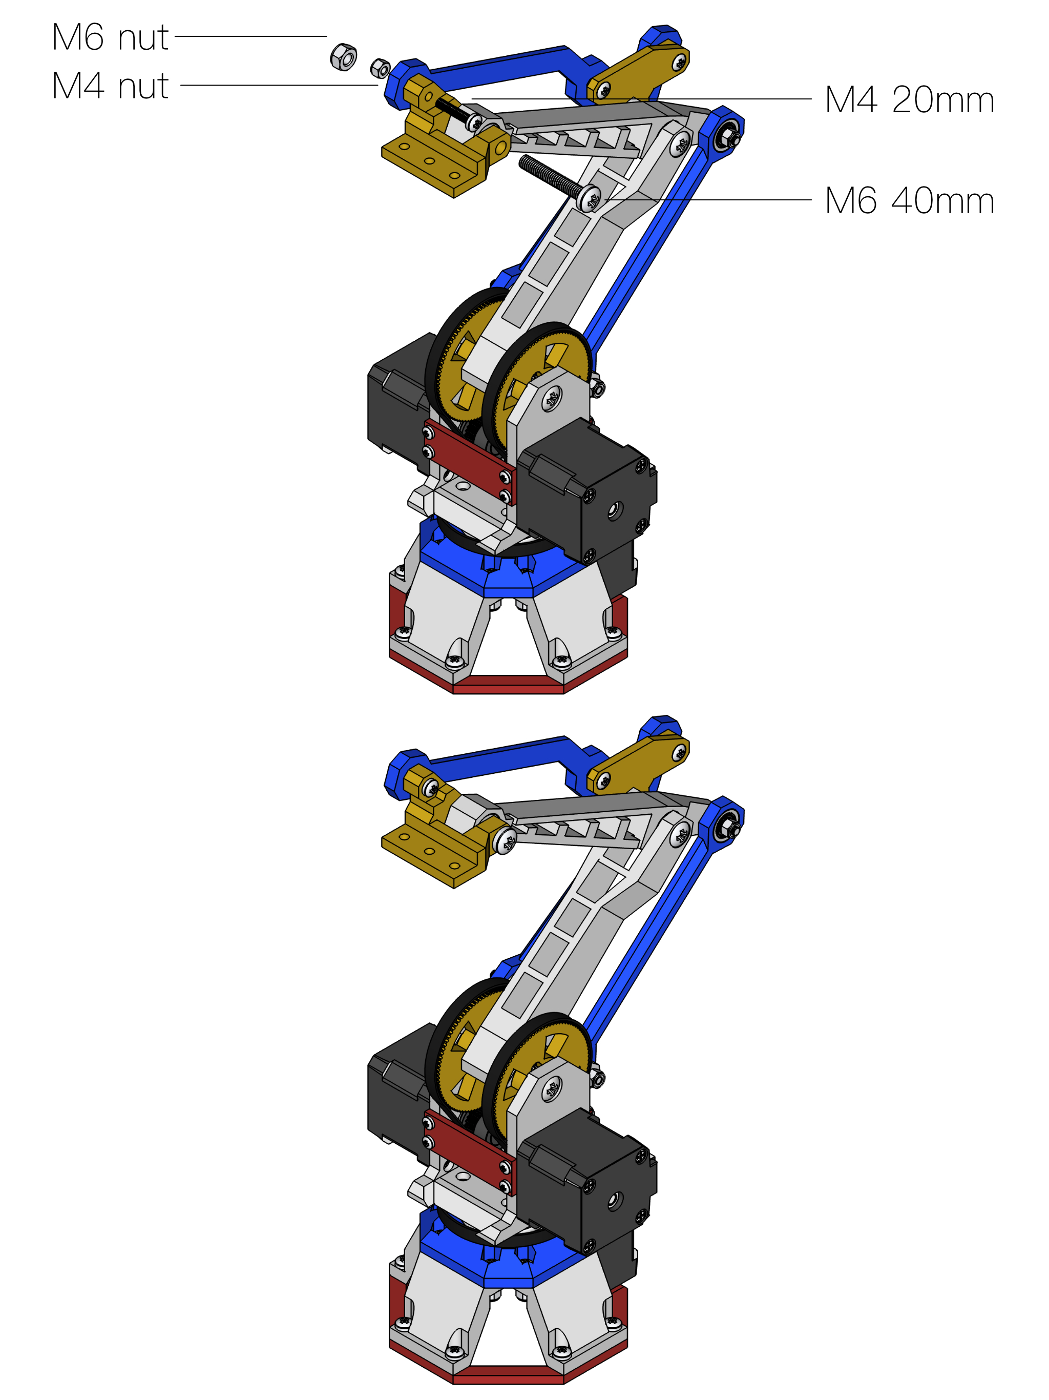
Assembly & Control Guides/Assembly Guide/22 - manipulator.jpg
