20sffactory/community_robot_arm/Assembly & Control Guides/Assembly Guide/22 - pleuel_bend_upper.jpg

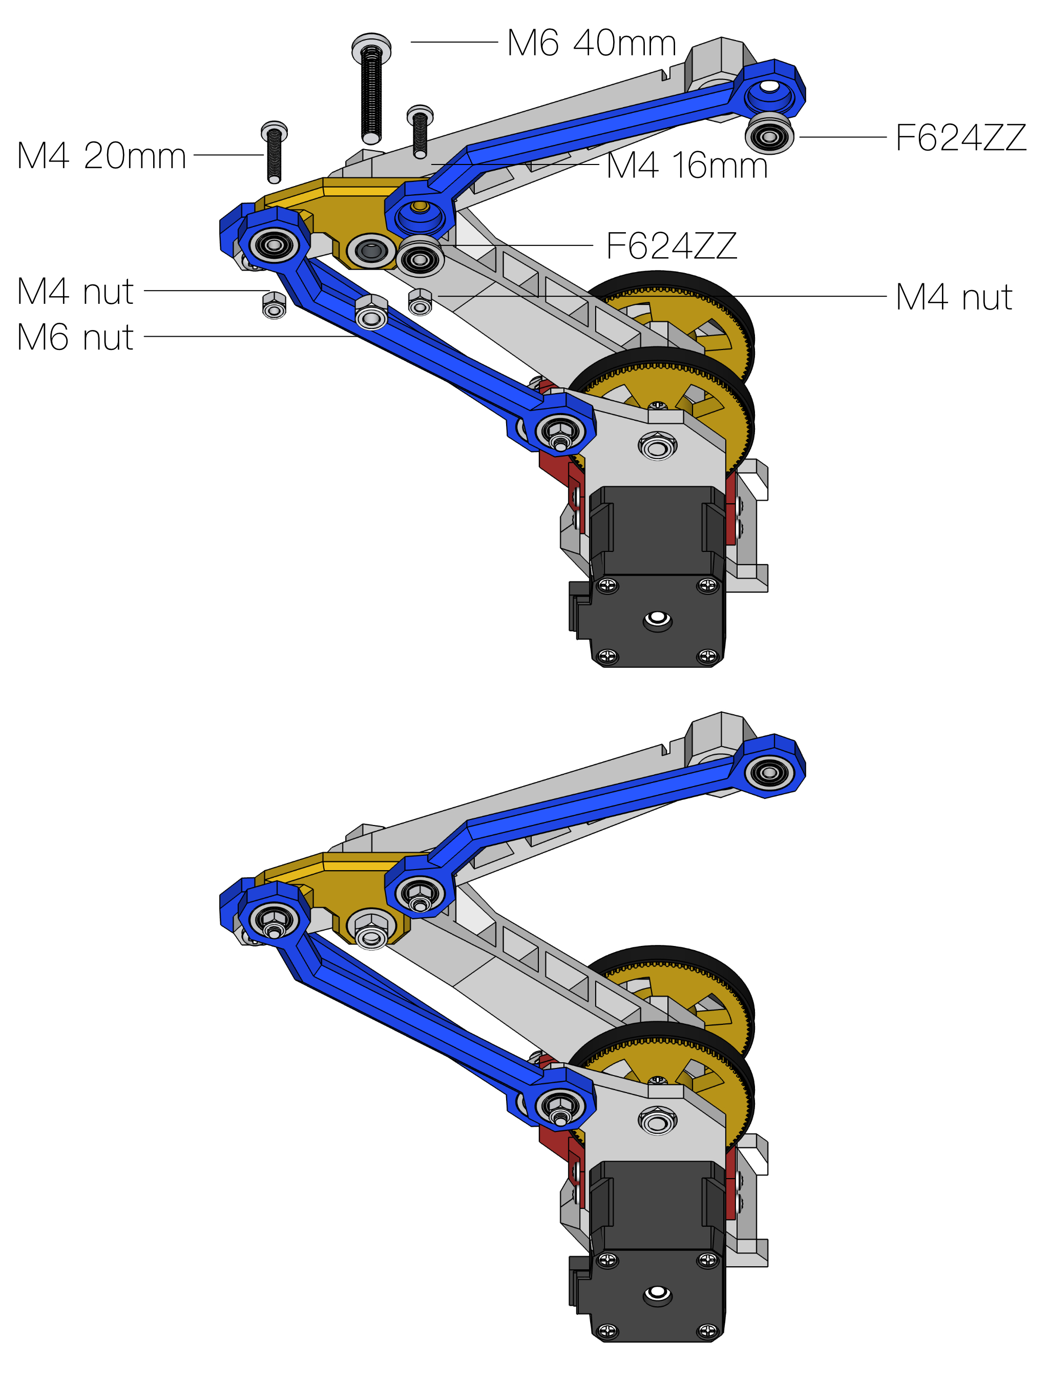
Assembly & Control Guides/Assembly Guide/22 - pleuel_bend_upper.jpg
