20sffactory/community_robot_arm/Assembly & Control Guides/Assembly Guide/23 - gripper.jpg

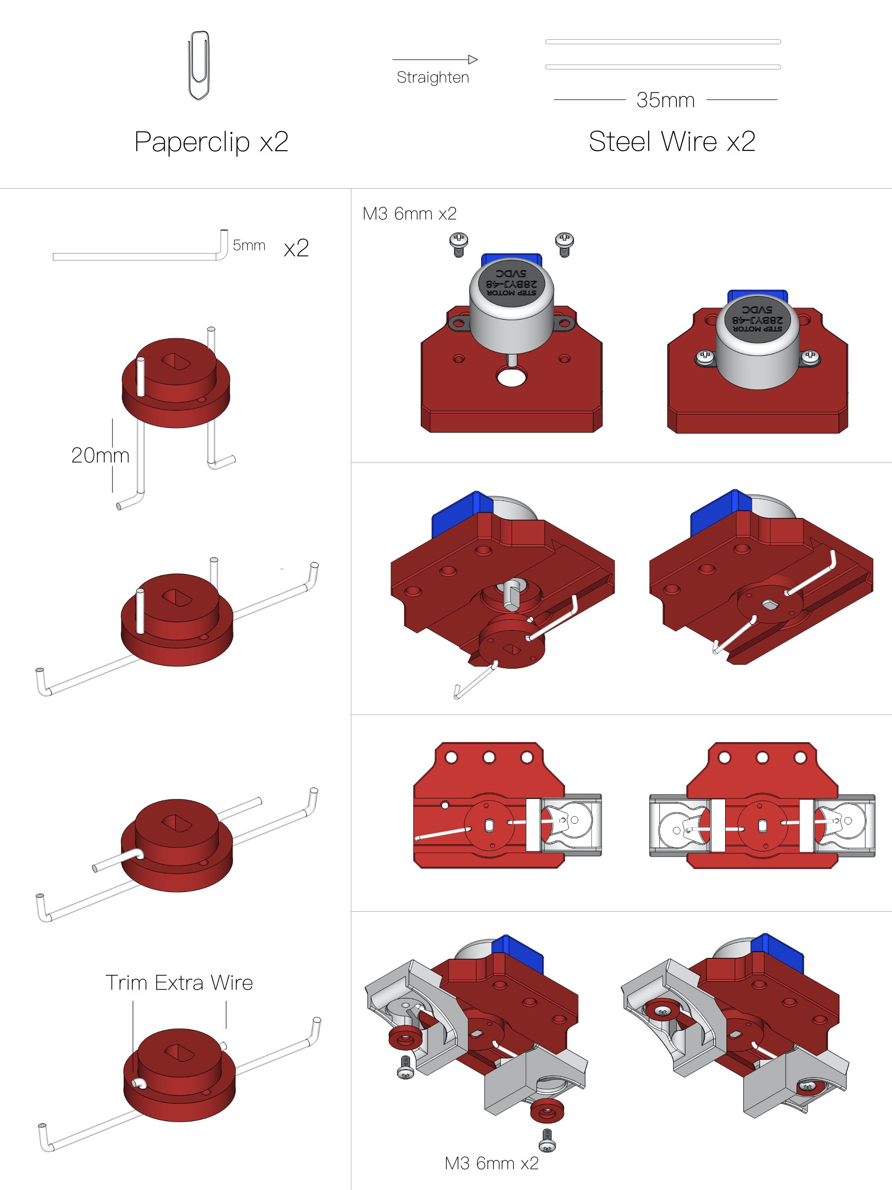
Assembly & Control Guides/Assembly Guide/23 - gripper.jpg
