20sffactory/community_robot_arm/Assembly & Control Guides/Assembly Guide/Assembly - Dual Support Guide.jpg

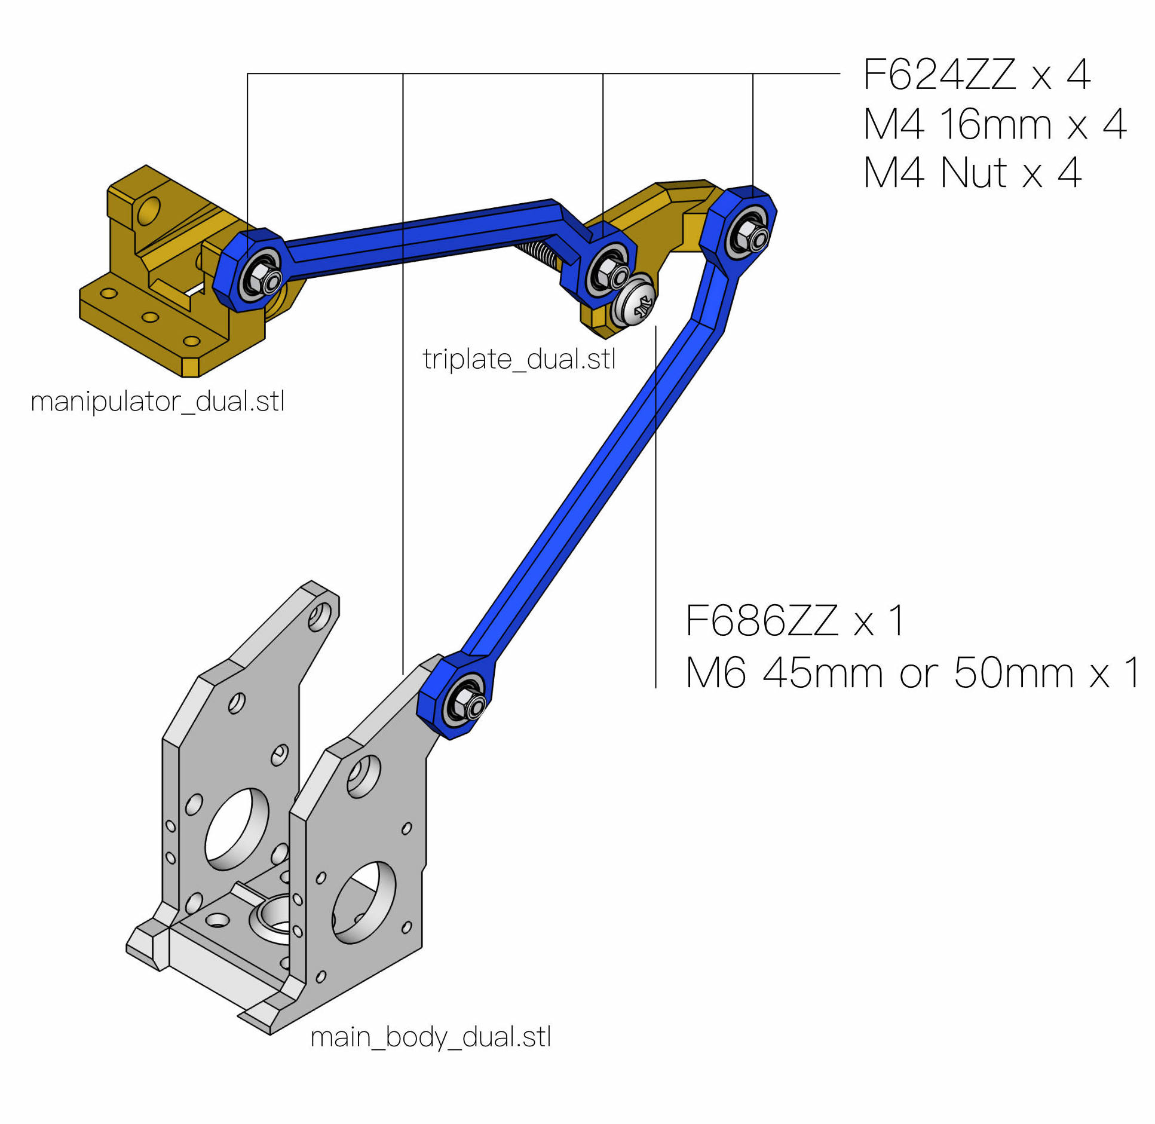
Assembly & Control Guides/Assembly Guide/Assembly - Dual Support Guide.jpg
