20sffactory/community_robot_arm/Assembly & Control Guides/Enclosure Assembly Gudie/case 01.jpg

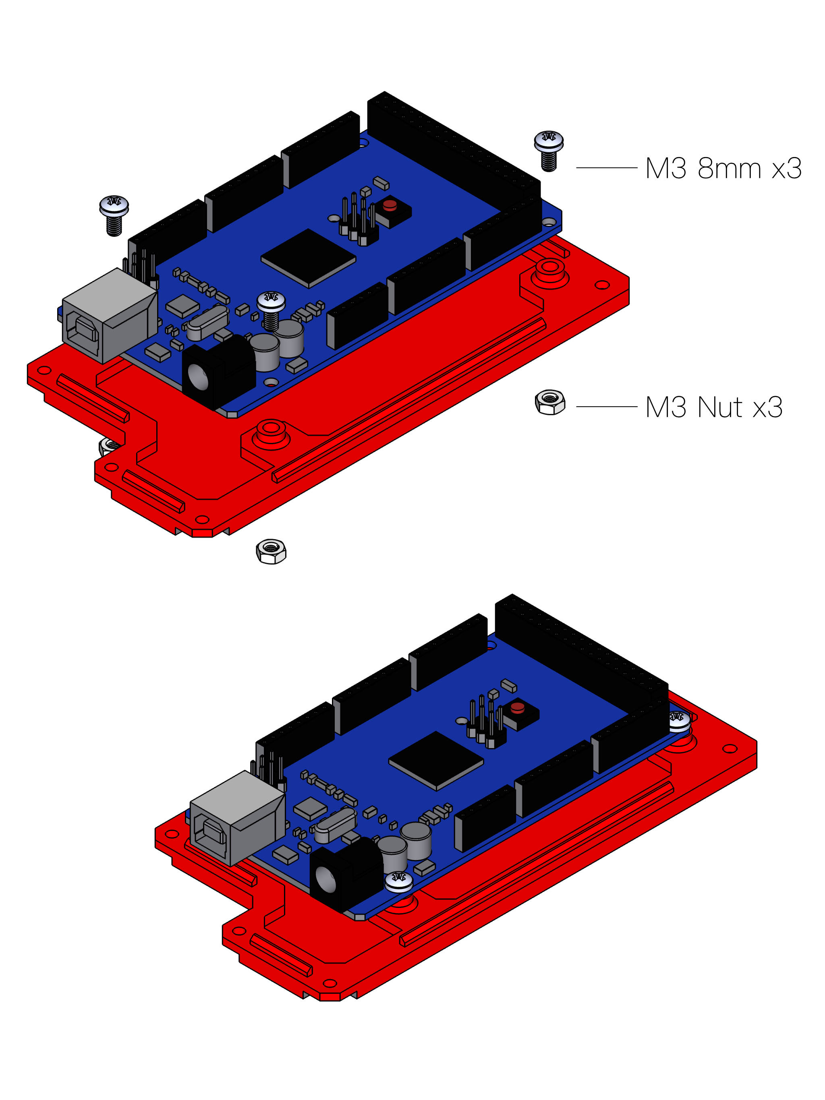
Assembly & Control Guides/Enclosure Assembly Gudie/case 01.jpg
