20sffactory/community_robot_arm/Assembly & Control Guides/Enclosure Assembly Gudie/case 05.jpg

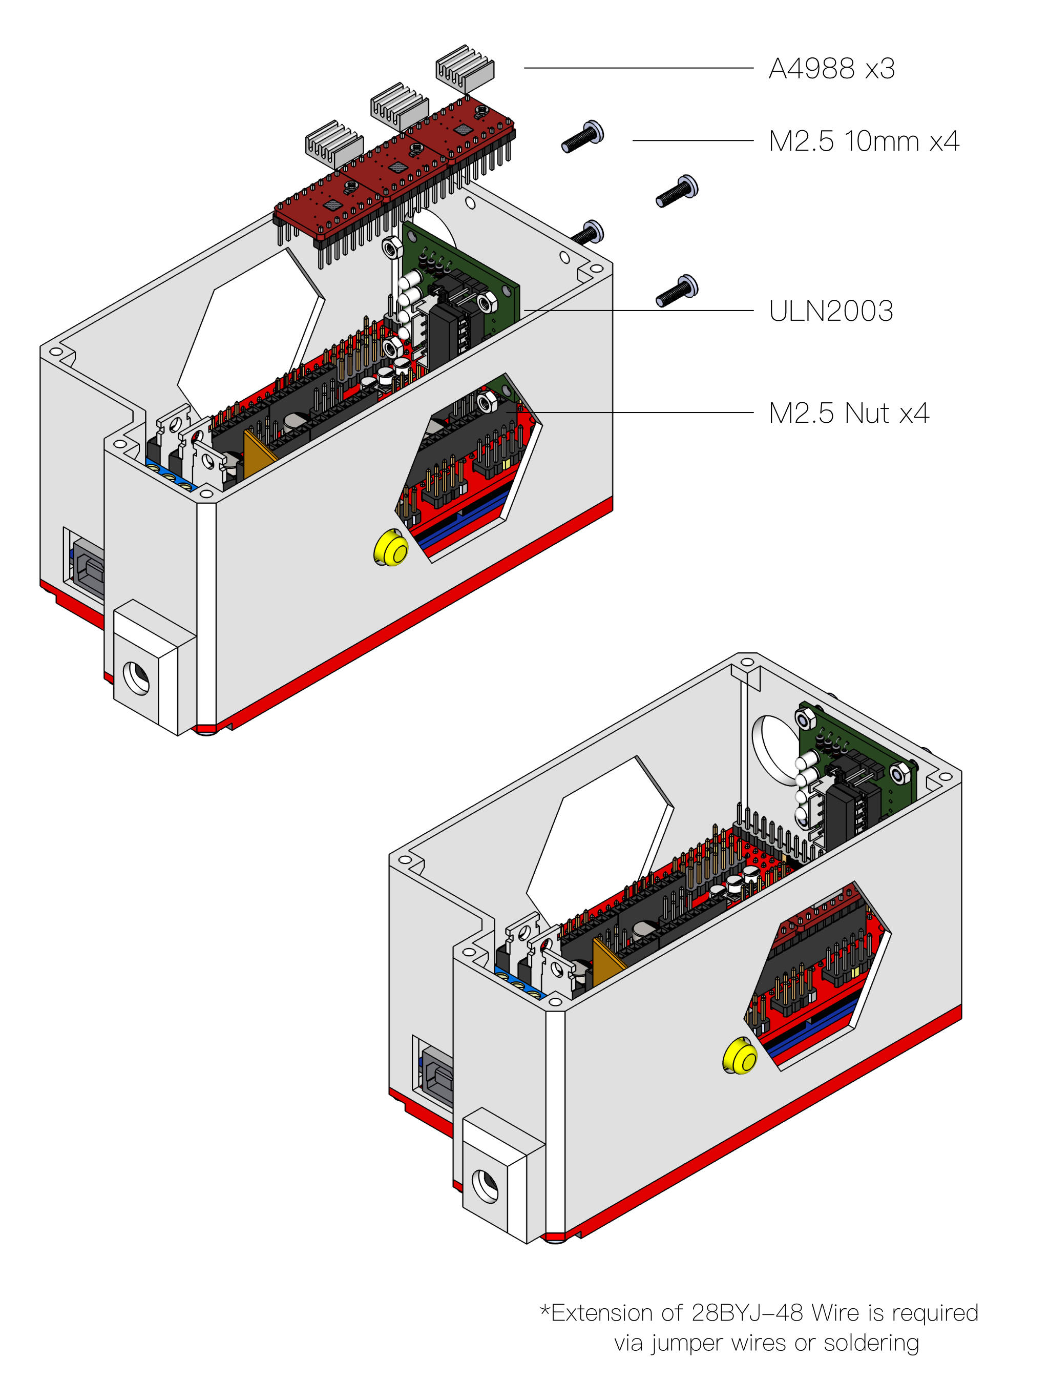
Assembly & Control Guides/Enclosure Assembly Gudie/case 05.jpg
