20sffactory/community_robot_arm/Assembly & Control Guides/ESP32 Guide/wemosd1r32_1.jpg

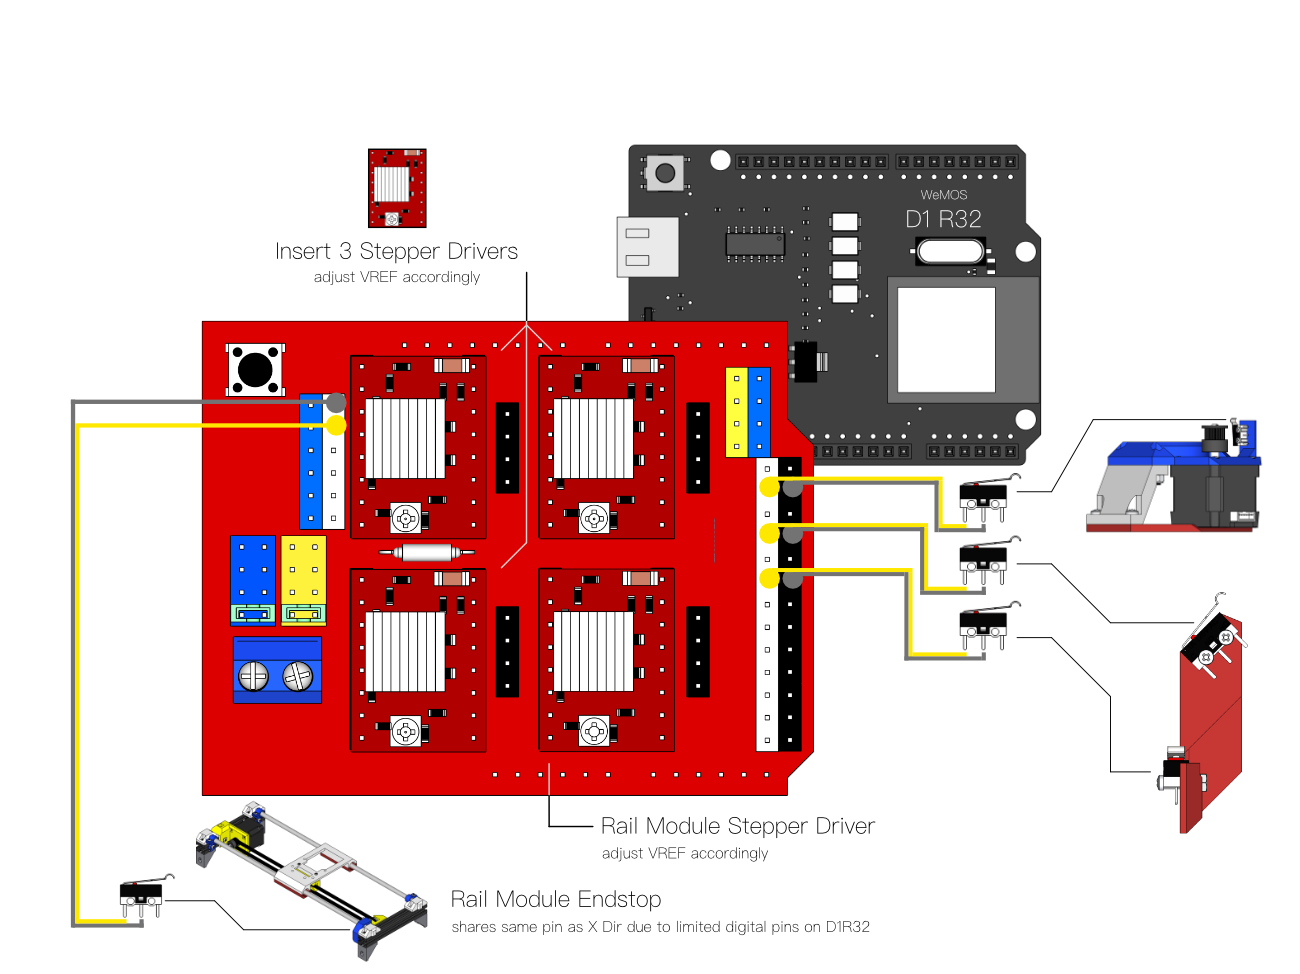
Assembly & Control Guides/ESP32 Guide/wemosd1r32_1.jpg
