20sffactory/community_robot_arm/Assembly & Control Guides/Firmware Guide/Firmware - Cartesian Guide.jpg

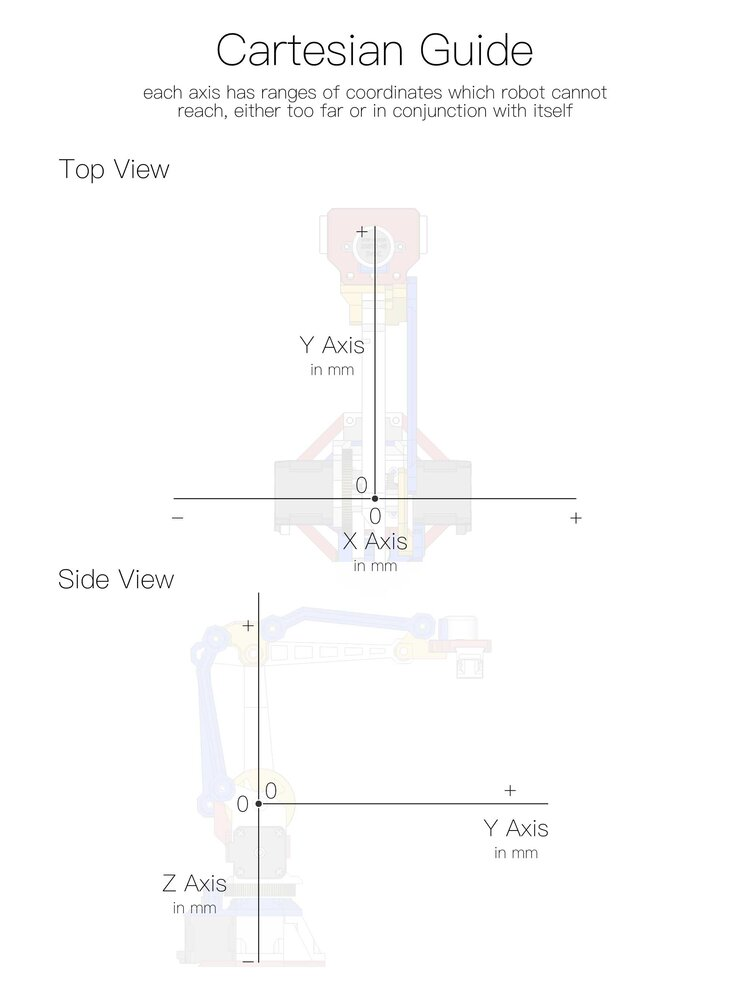
Assembly & Control Guides/Firmware Guide/Firmware - Cartesian Guide.jpg
