20sffactory/community_robot_arm/Assembly & Control Guides/Firmware Guide/Firmware - Operation Range Guide.jpeg

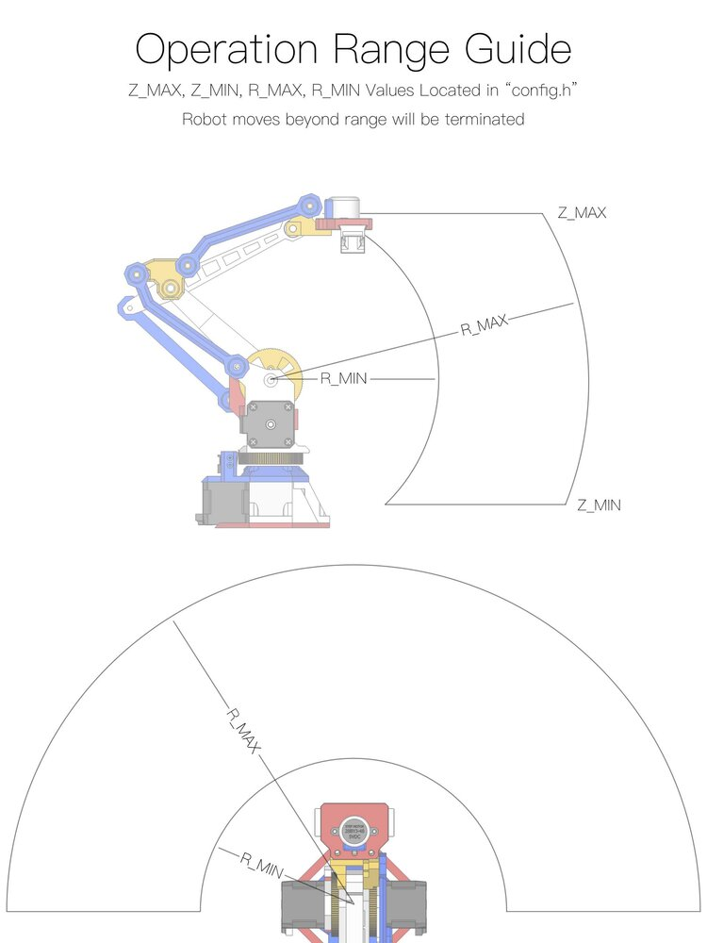
Assembly & Control Guides/Firmware Guide/Firmware - Operation Range Guide.jpeg
