20sffactory/community_robot_arm/Assembly & Control Guides/Firmware Guide/Firmware - Speed Curve Guide.jpg

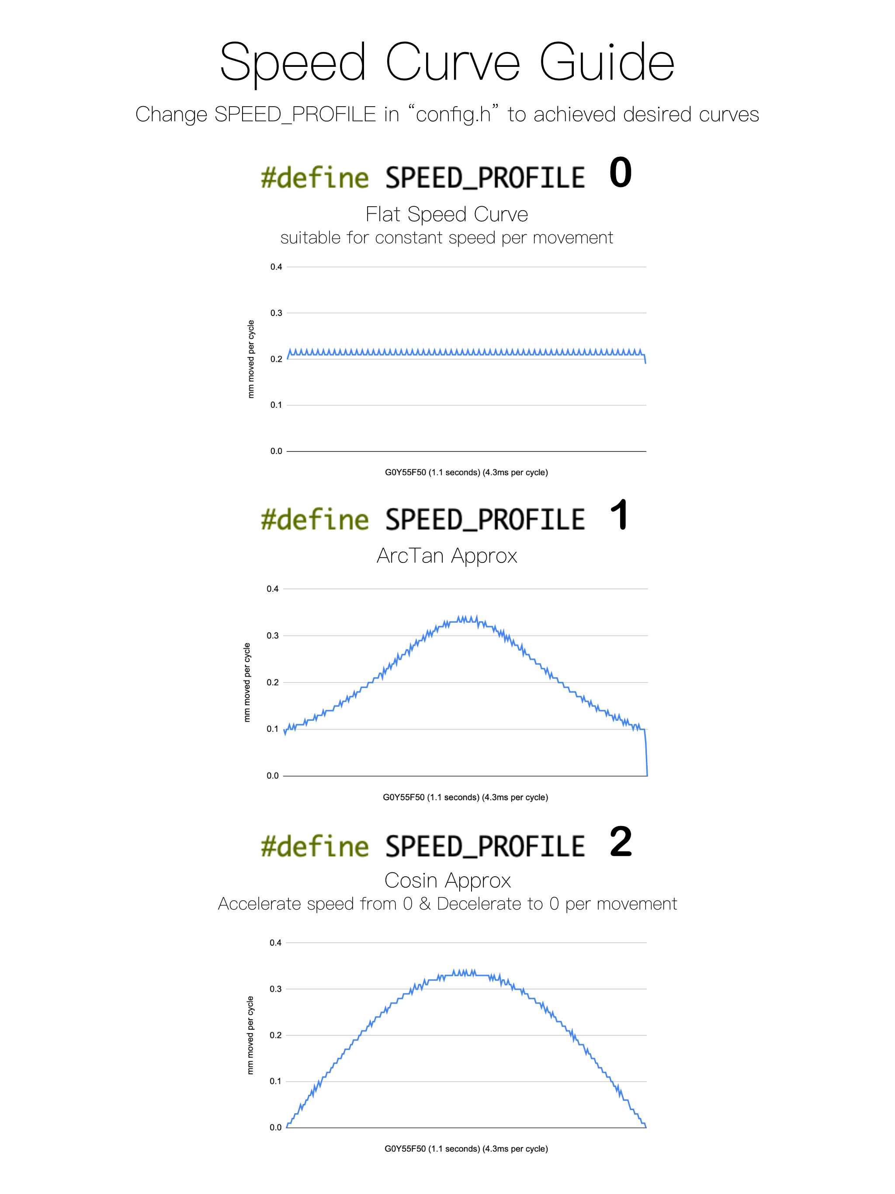
Assembly & Control Guides/Firmware Guide/Firmware - Speed Curve Guide.jpg
