20sffactory/community_robot_arm/Assembly & Control Guides/Firmware Guide/Servo Gripper.jpg

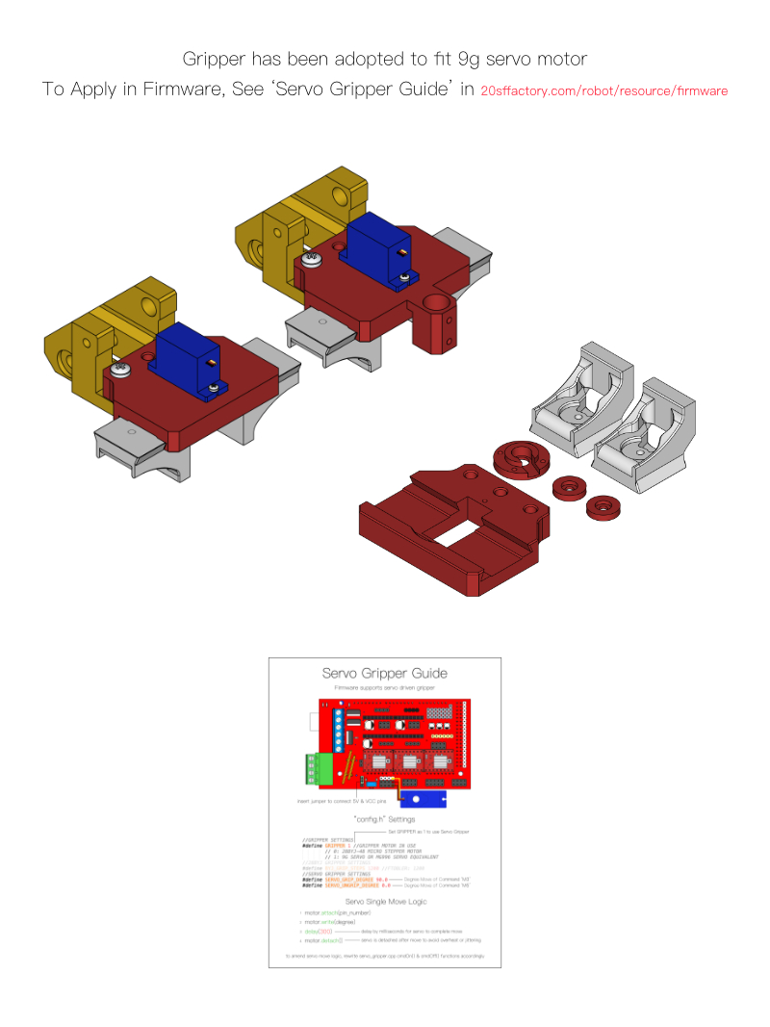
Assembly & Control Guides/Firmware Guide/Servo Gripper.jpg
