20sffactory/community_robot_arm/Assembly & Control Guides/Marlin Guide/Guide_Inkscape_Gcode.jpg

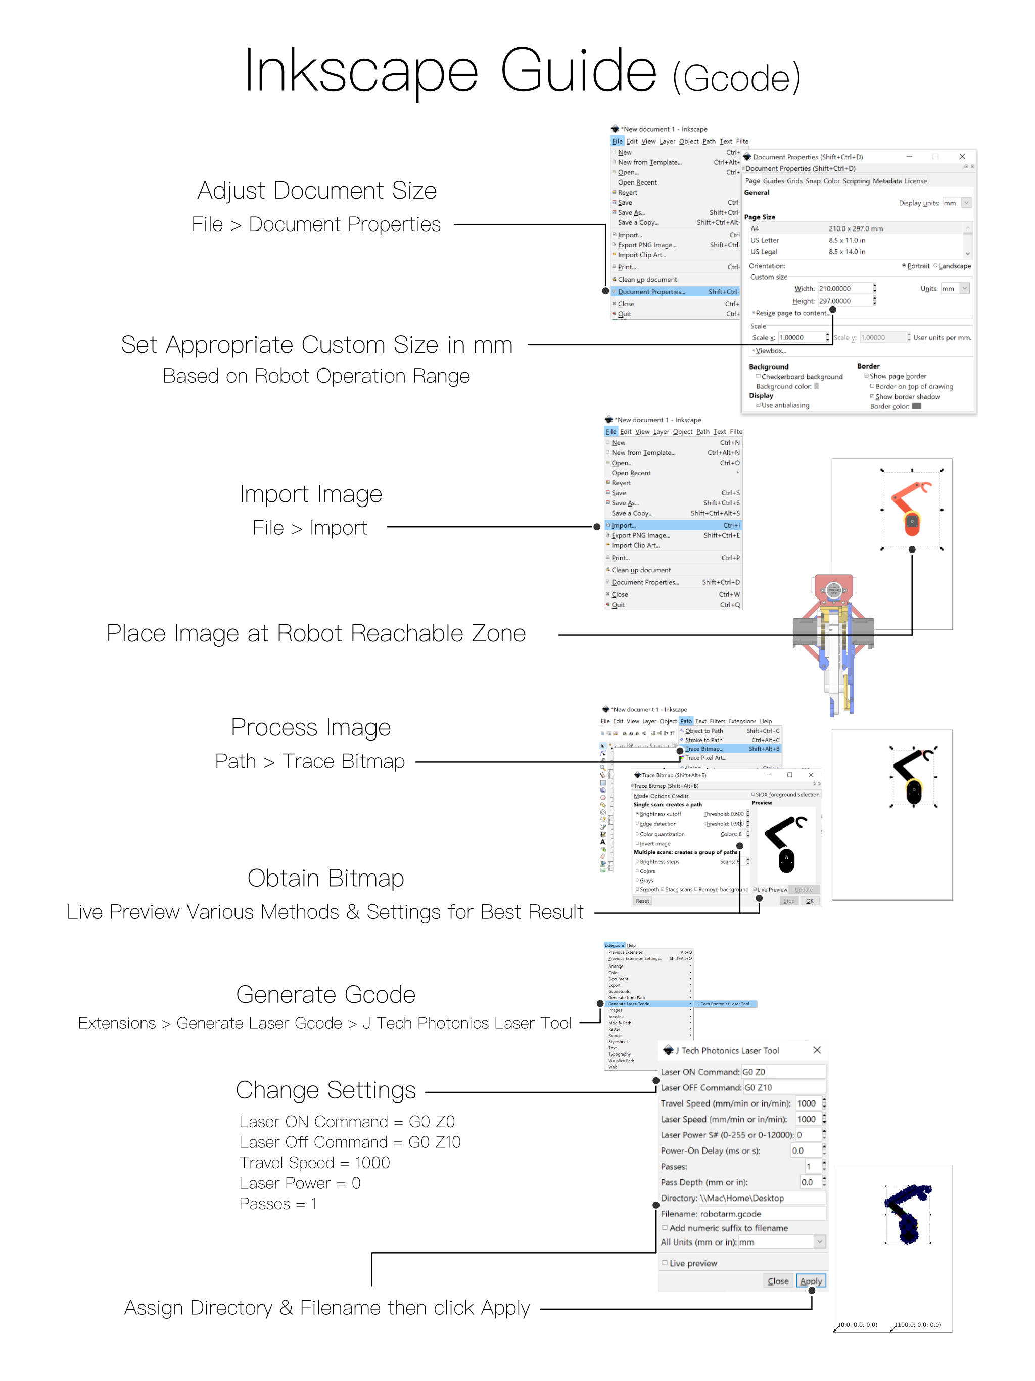
Assembly & Control Guides/Marlin Guide/Guide_Inkscape_Gcode.jpg
