20sffactory/community_robot_arm/Assembly & Control Guides/Marlin Guide/Guide_Inkscape_Setup.jpg

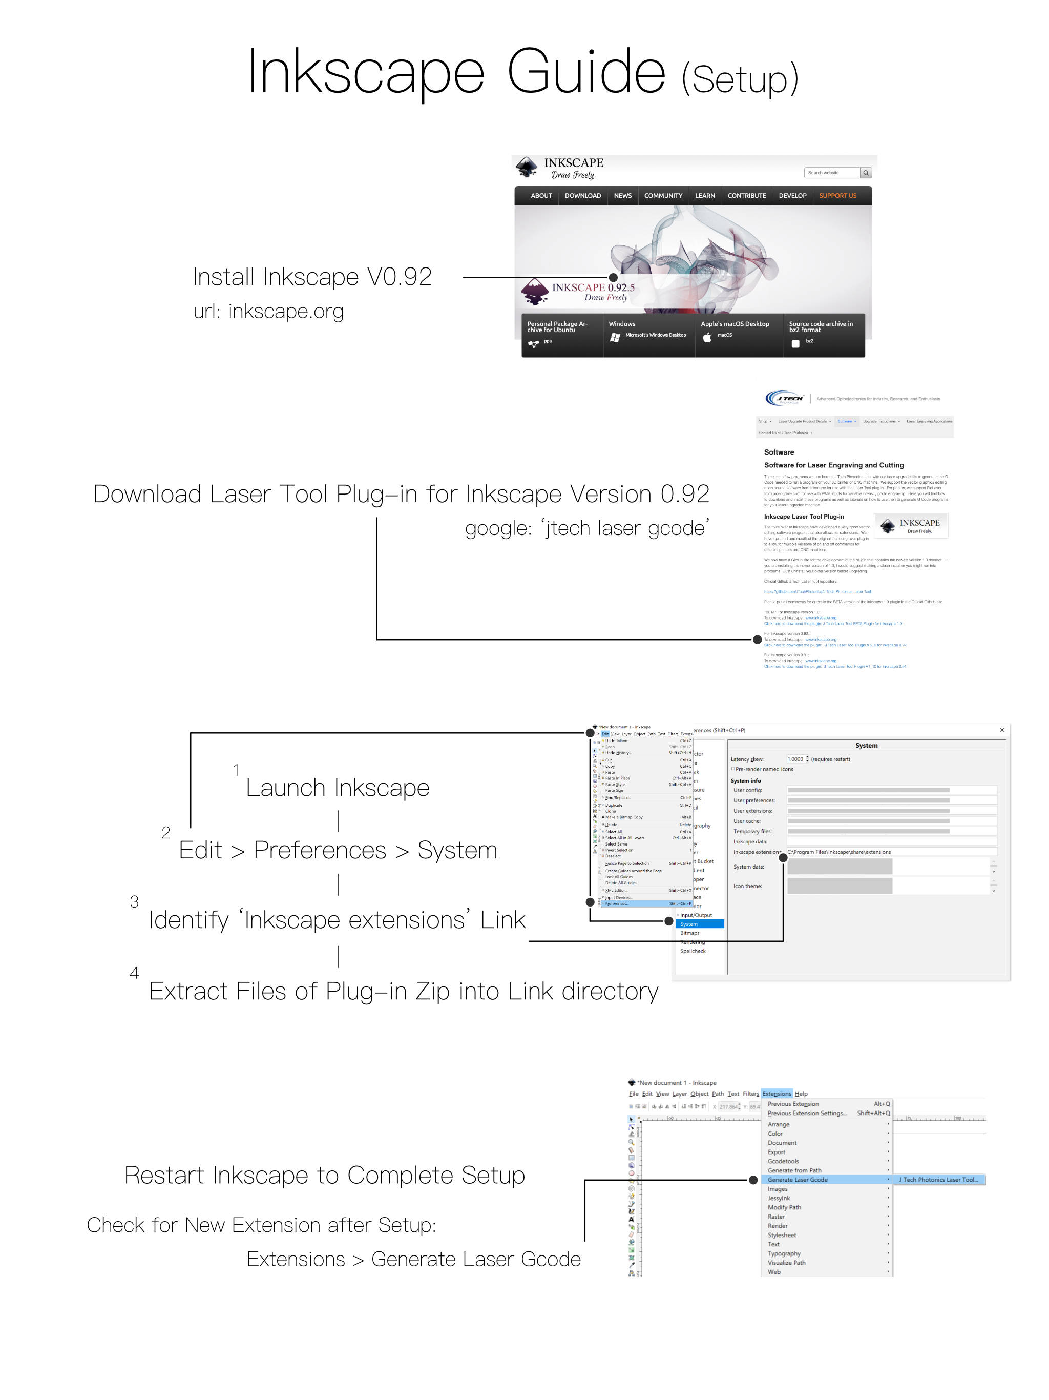
Assembly & Control Guides/Marlin Guide/Guide_Inkscape_Setup.jpg
