20sffactory/community_robot_arm/Assembly & Control Guides/Marlin Guide/Guide_Marlin.jpg

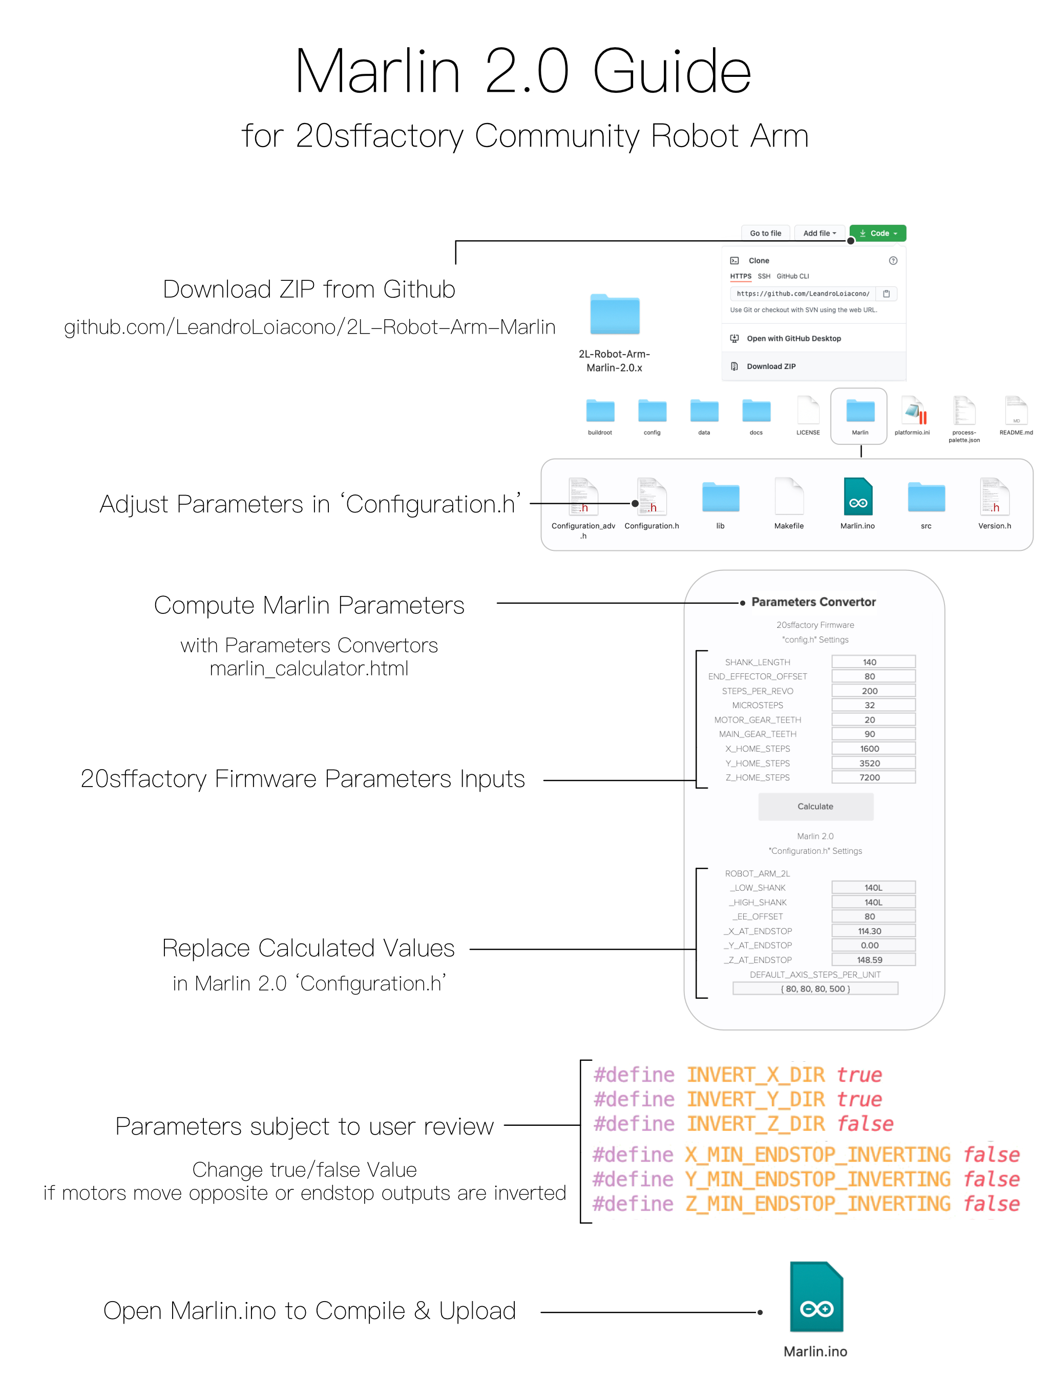
Assembly & Control Guides/Marlin Guide/Guide_Marlin.jpg
