20sffactory/community_robot_arm/Assembly & Control Guides/Marlin Guide/Guide_Pronterface_Plotting.jpg

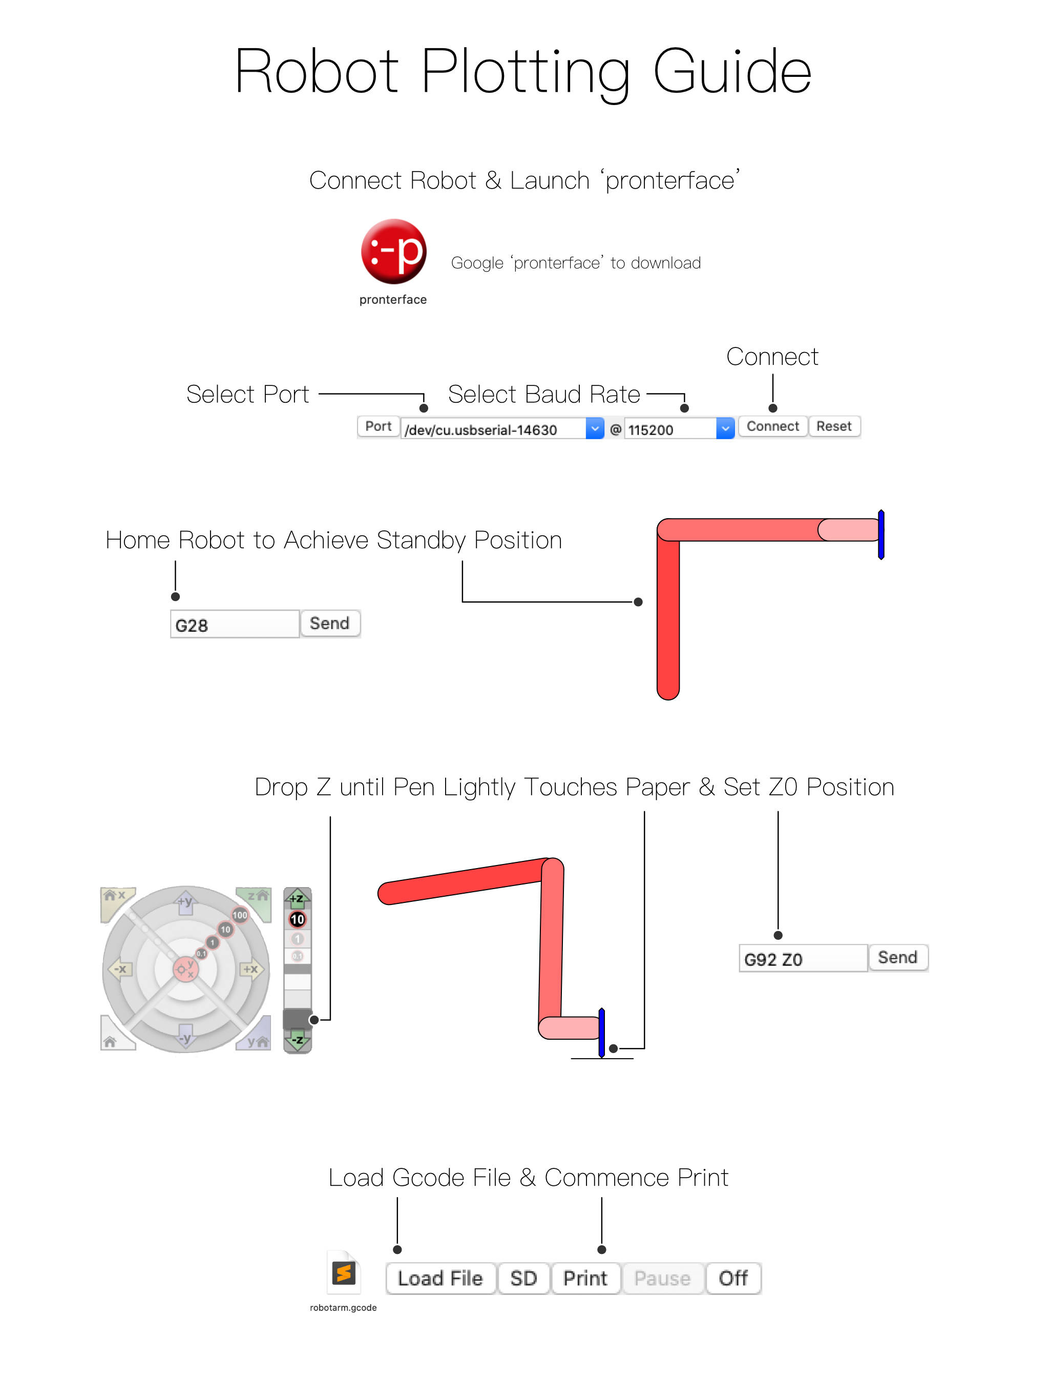
Assembly & Control Guides/Marlin Guide/Guide_Pronterface_Plotting.jpg
