20sffactory/community_robot_arm/Assembly & Control Guides/Rail Module Assembly Guide/Rail 03.jpg

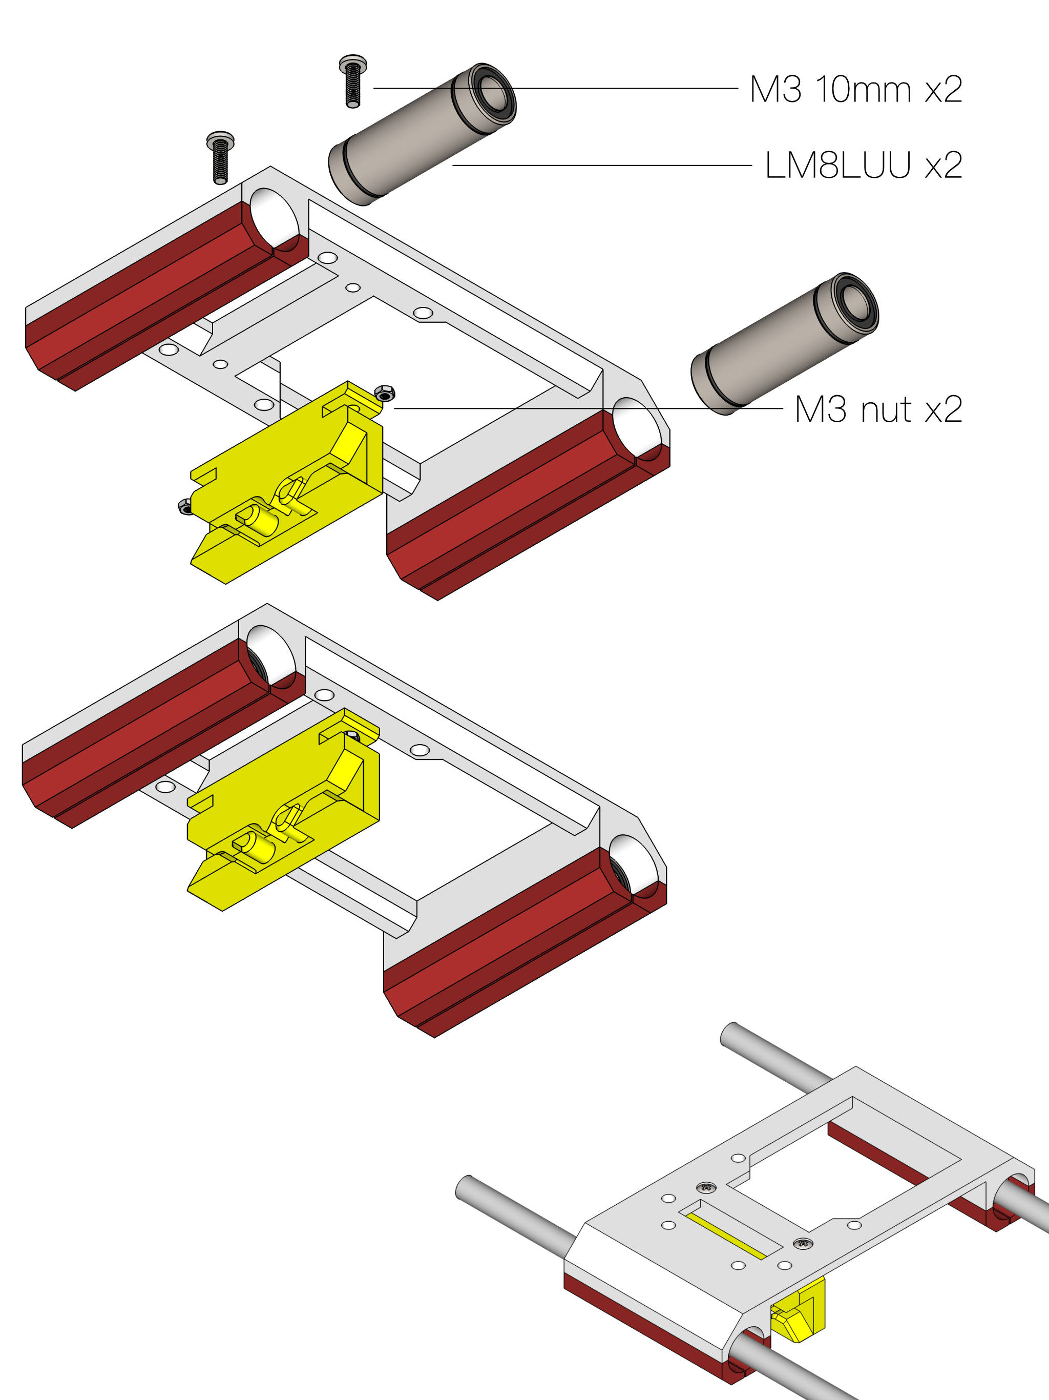
Assembly & Control Guides/Rail Module Assembly Guide/Rail 03.jpg
