20sffactory/community_robot_arm/Assembly & Control Guides/Rail Module Assembly Guide/Rail 04.jpg

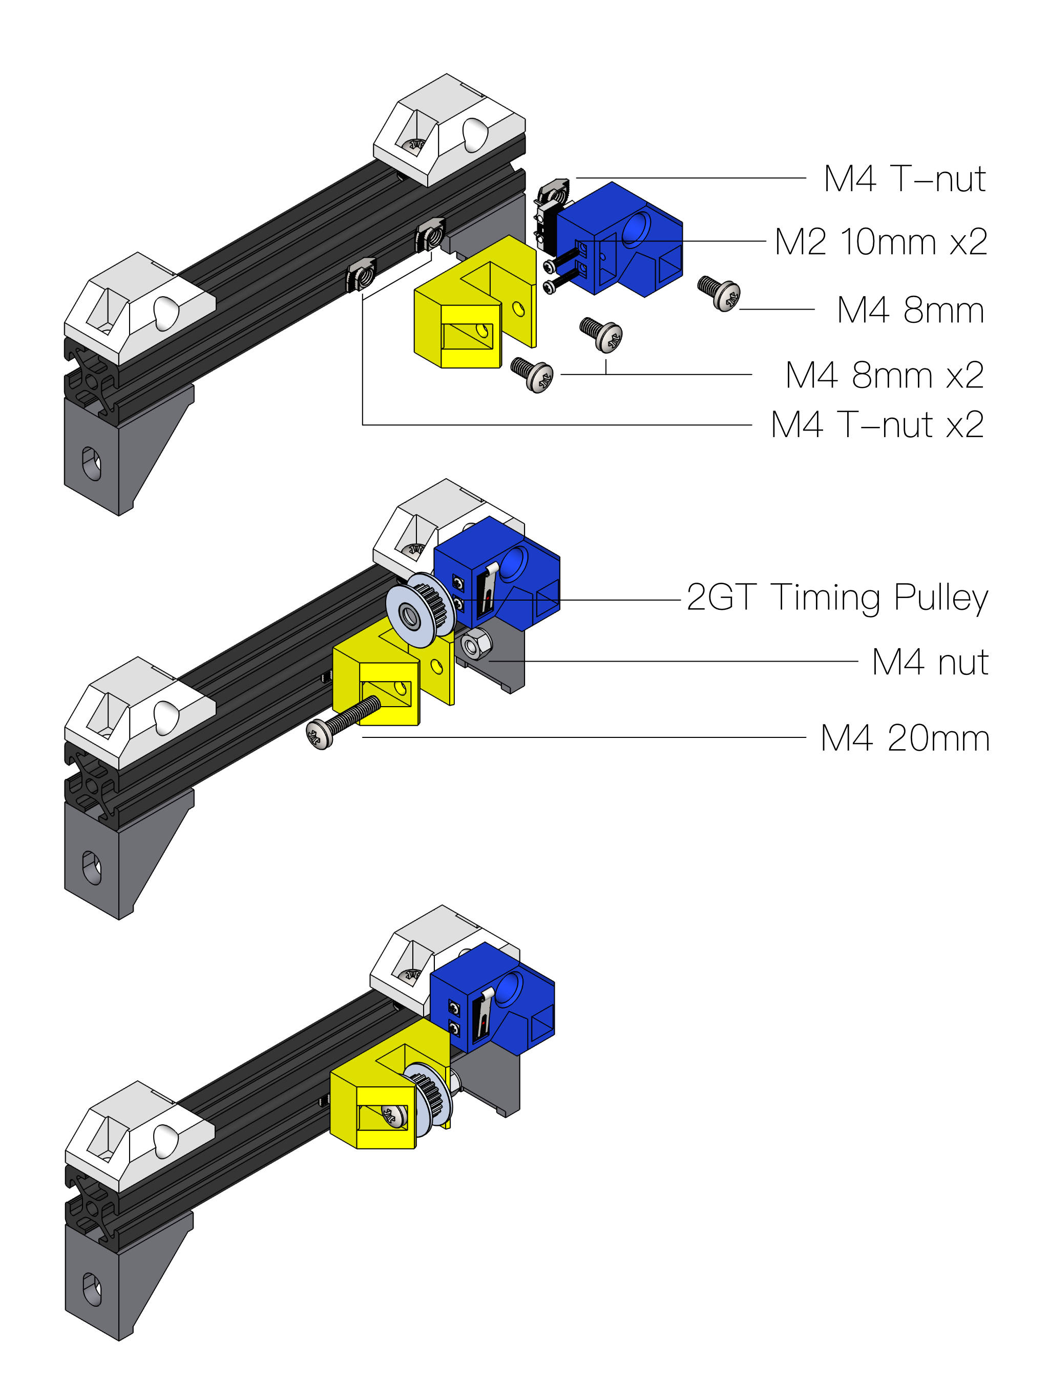
Assembly & Control Guides/Rail Module Assembly Guide/Rail 04.jpg
