20sffactory/community_robot_arm/Assembly & Control Guides/Uno Guide/uno_1.jpg

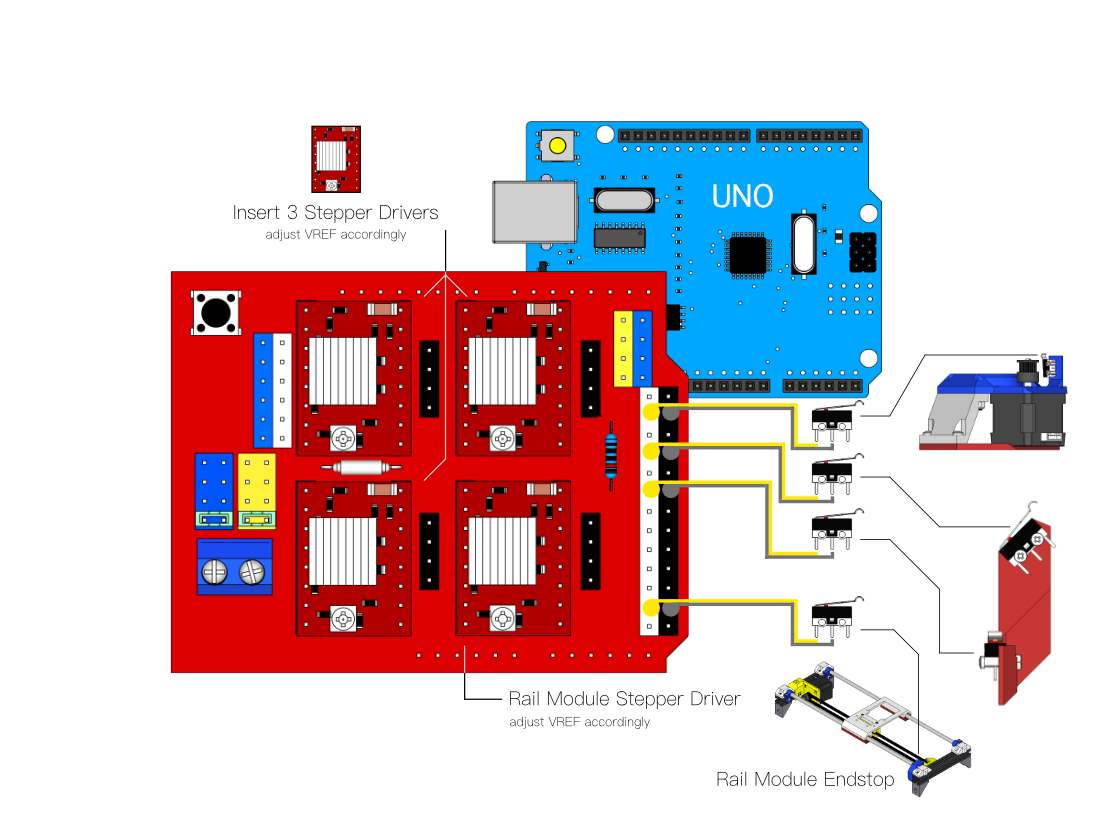
Assembly & Control Guides/Uno Guide/uno_1.jpg
