20sffactory/community_robot_arm/Assembly & Control Guides/Uno Guide/uno_firmware.jpg

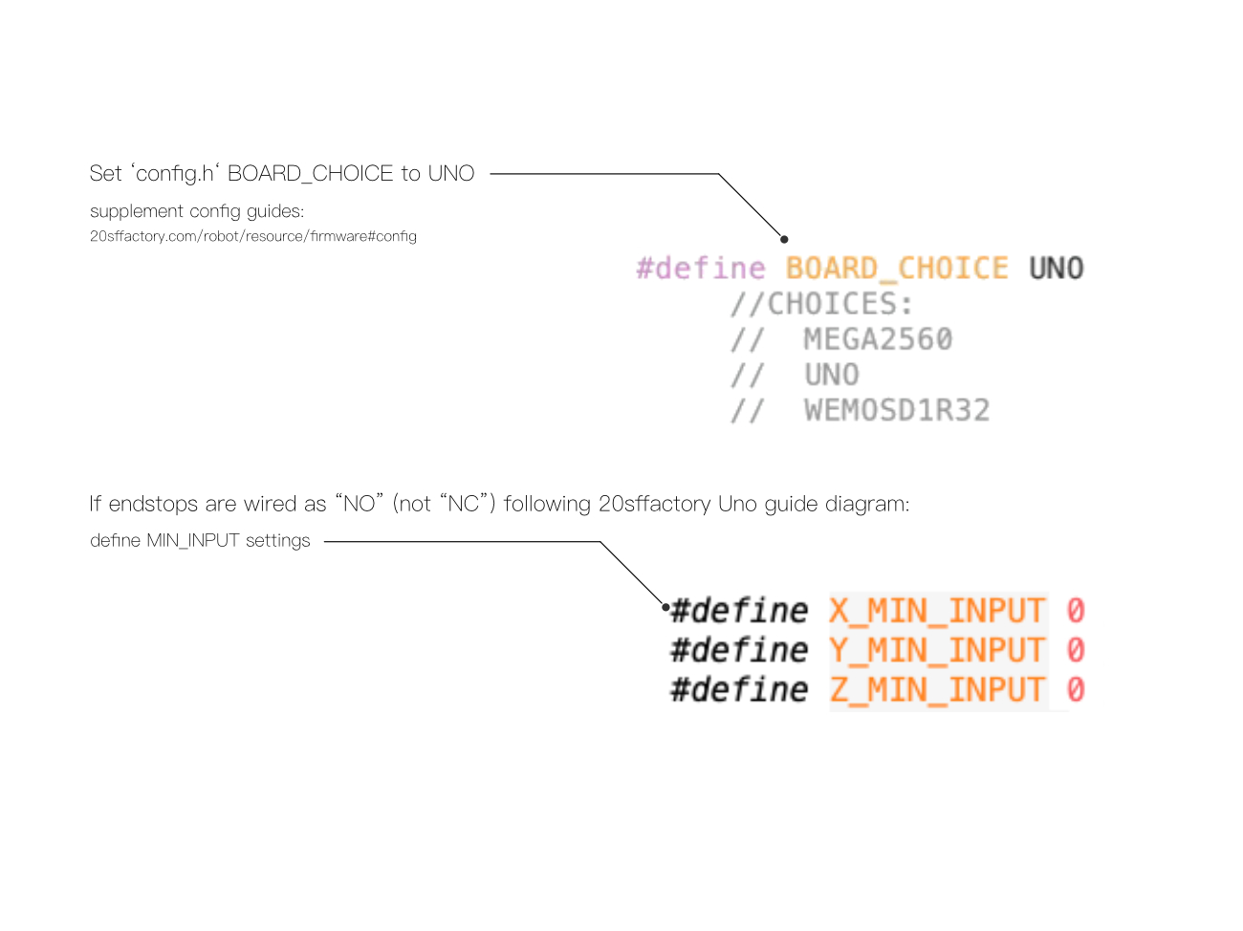
Assembly & Control Guides/Uno Guide/uno_firmware.jpg
