20sffactory/community_robot_arm/Assembly & Control Guides/Wiring Guide/wiring-fan.jpg

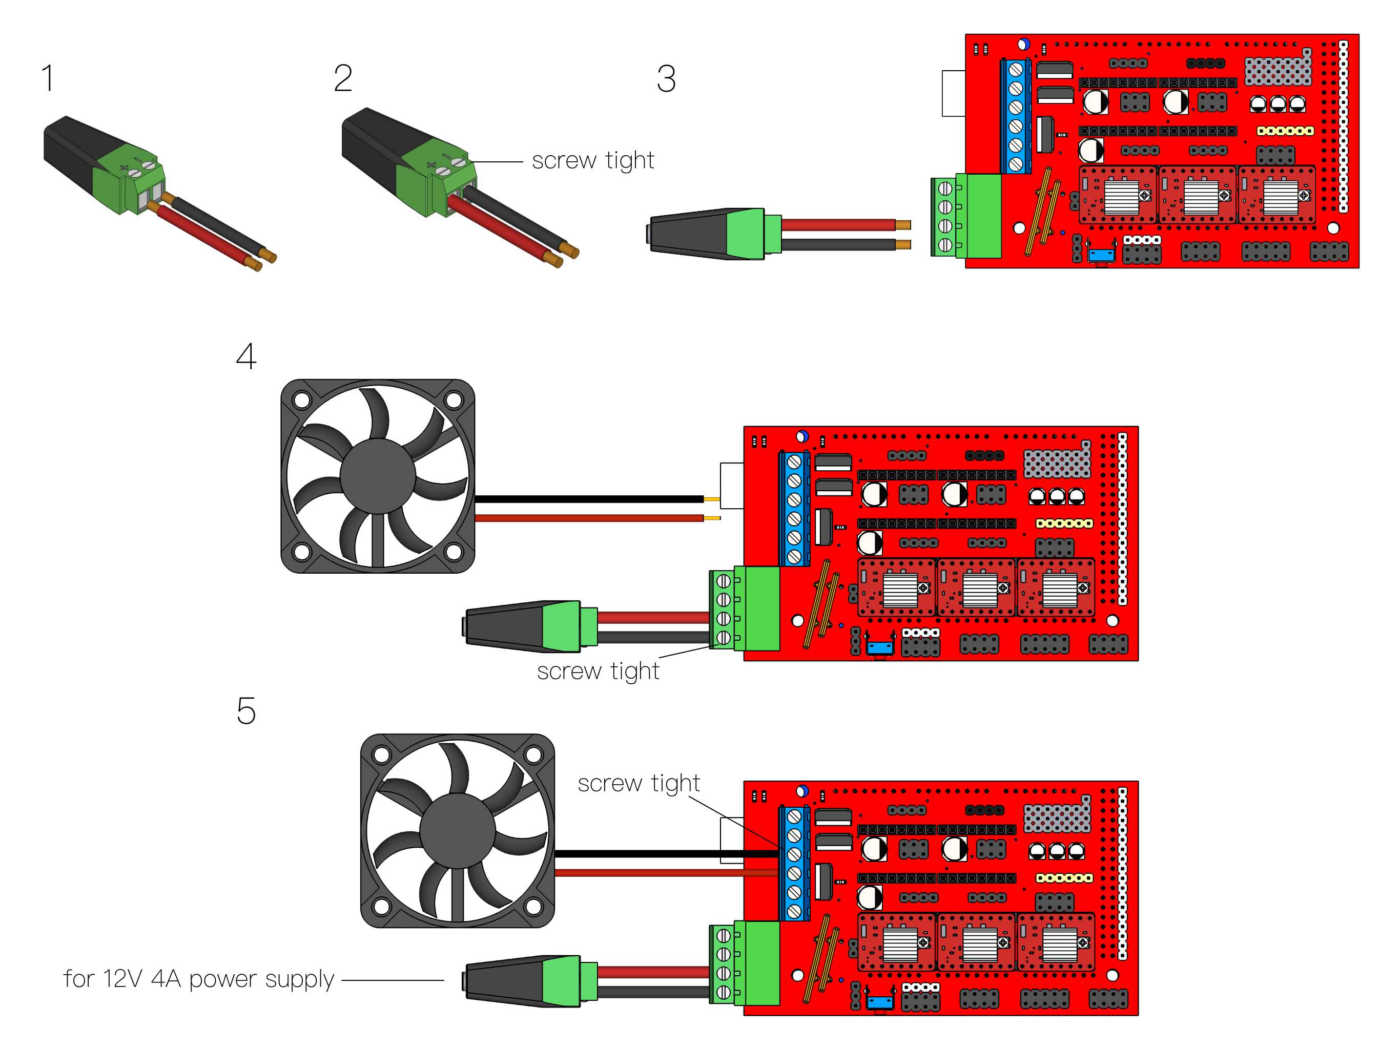
Assembly & Control Guides/Wiring Guide/wiring-fan.jpg
