20sffactory/community_robot_arm/Assembly & Control Guides/Wiring Guide/wiring-lower motor.jpg

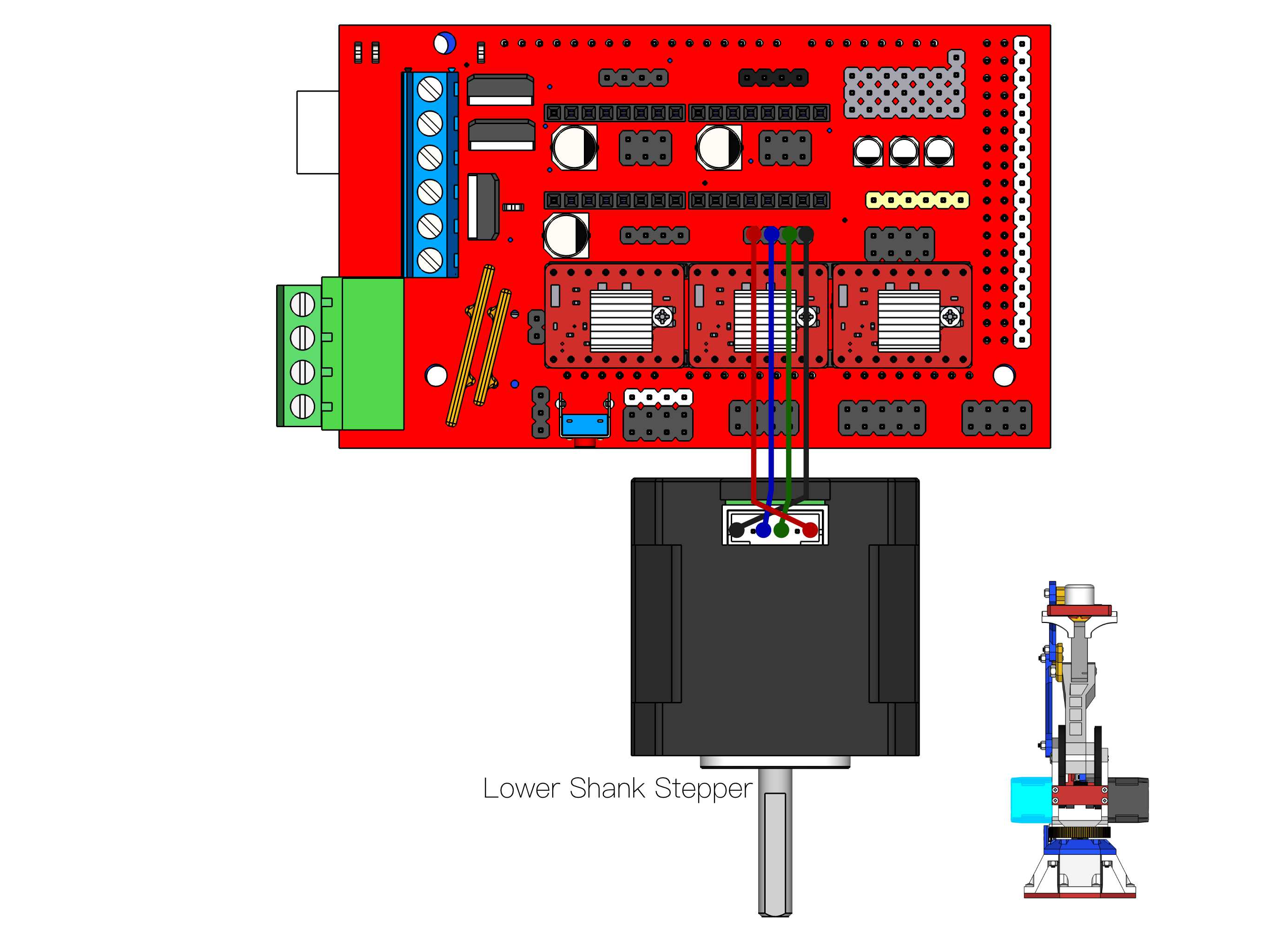
Assembly & Control Guides/Wiring Guide/wiring-lower motor.jpg
