20sffactory/community_robot_arm/Assembly & Control Guides/Wiring Guide/wiring-rotation motor.jpg

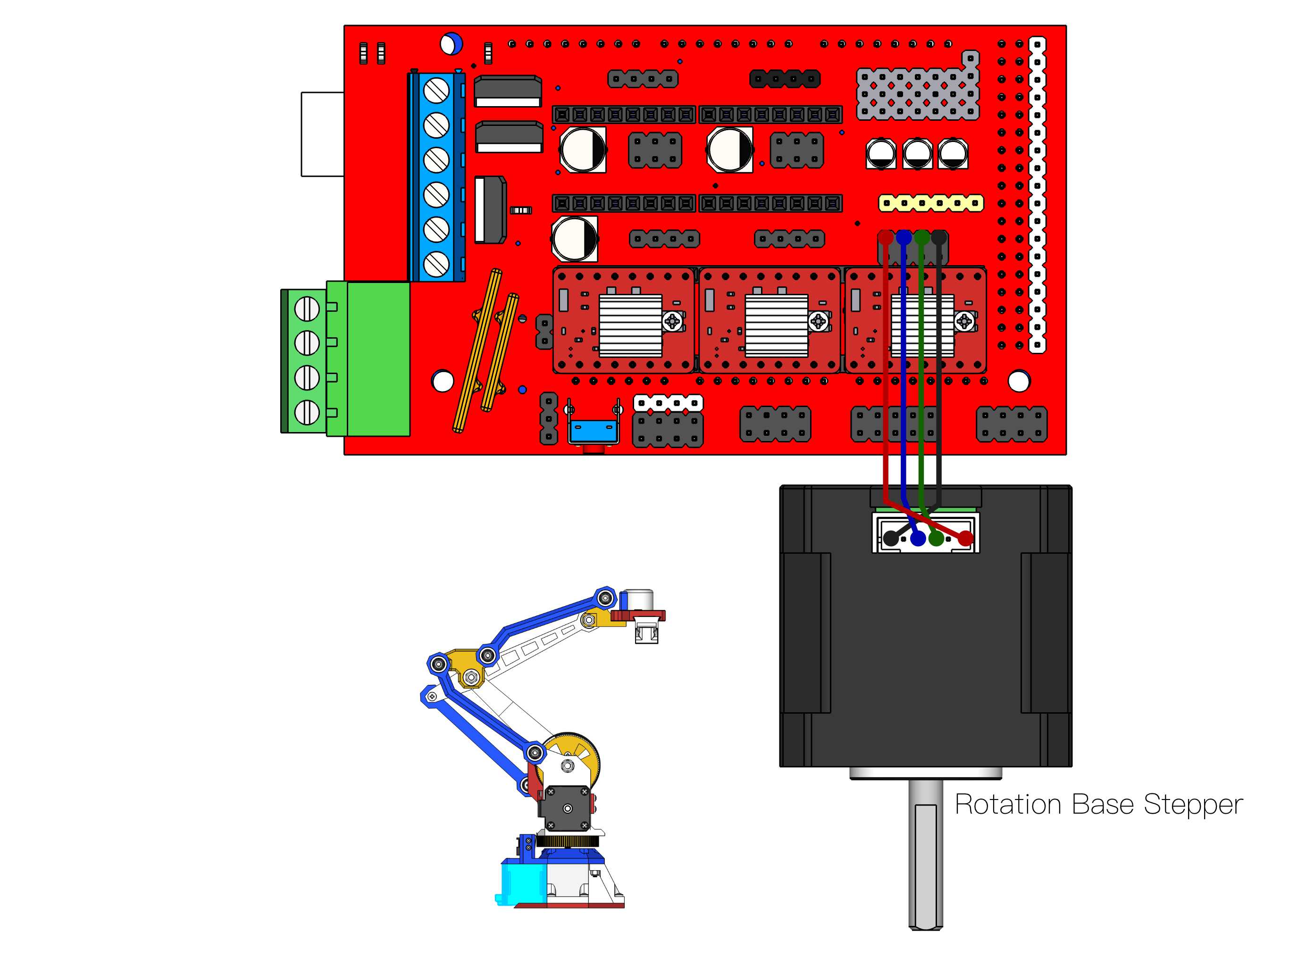
Assembly & Control Guides/Wiring Guide/wiring-rotation motor.jpg
