20sffactory/community_robot_arm/Assembly & Control Guides/Wiring Guide/wiring-uln2003.jpg

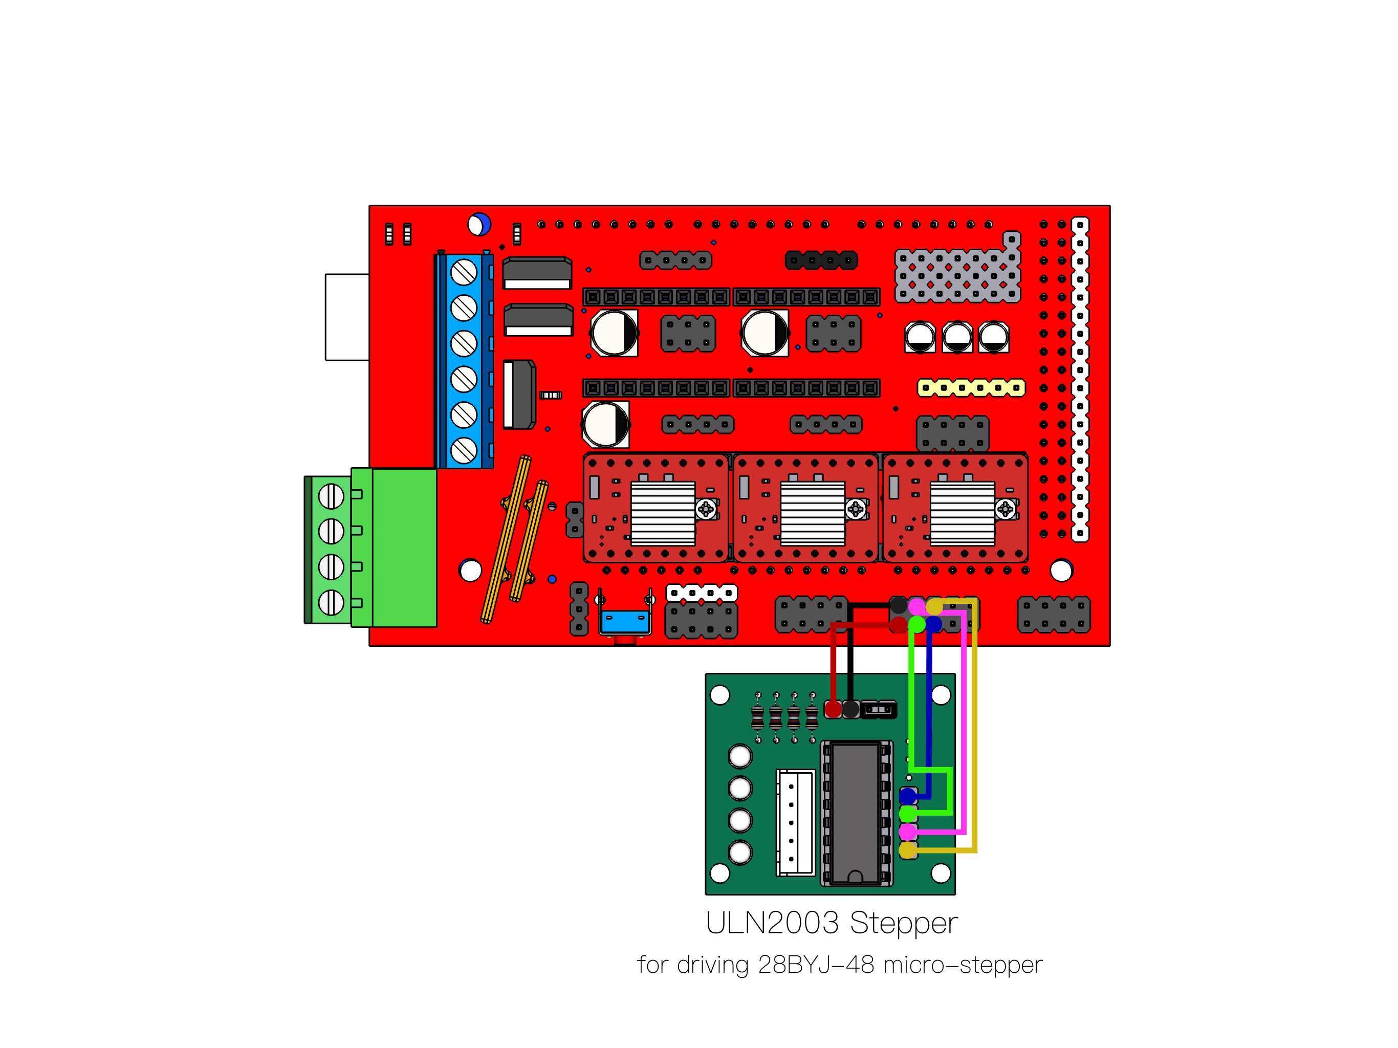
Assembly & Control Guides/Wiring Guide/wiring-uln2003.jpg
