20sffactory/community_robot_arm/Assembly & Control Guides/Wiring Guide/wiring-uppermotor.jpg

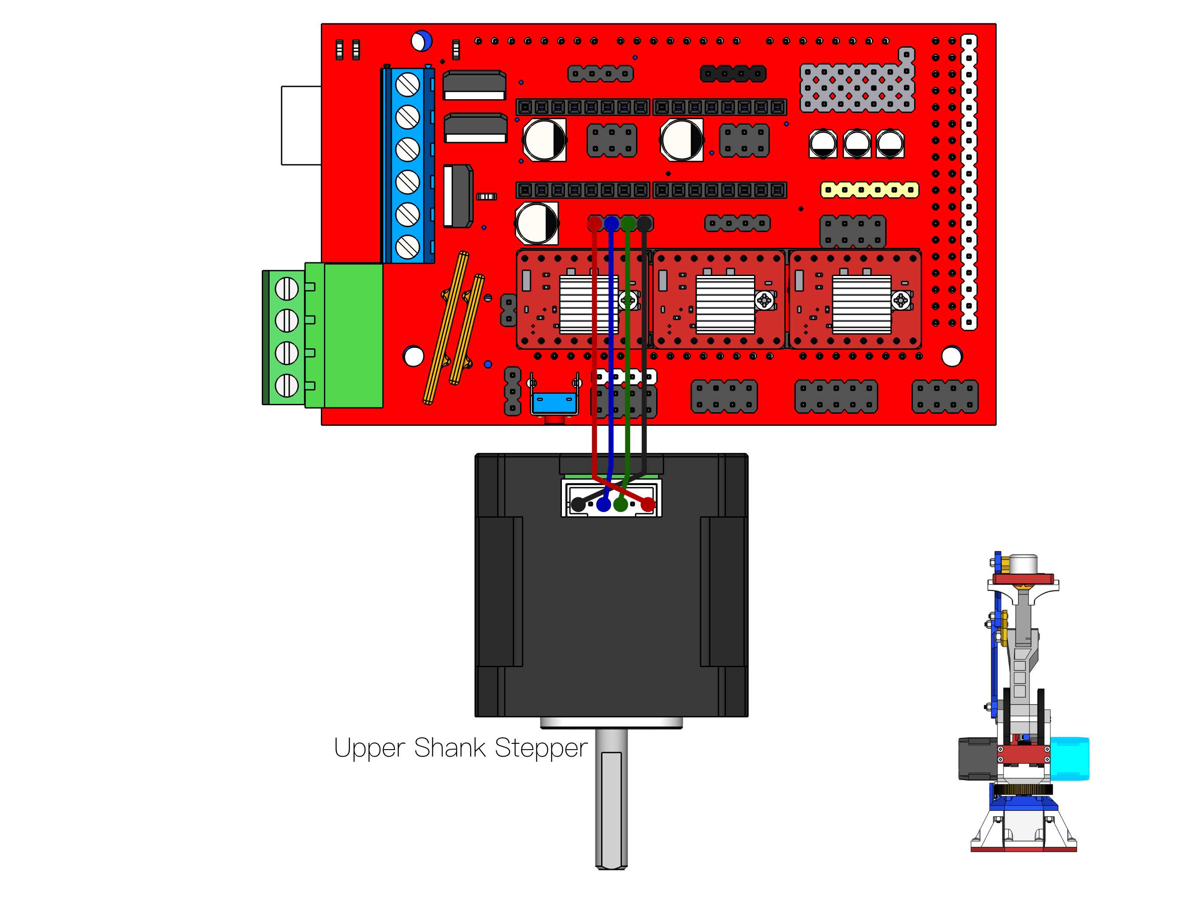
Assembly & Control Guides/Wiring Guide/wiring-uppermotor.jpg
