20sffactory/community_robot_arm/(threads)

Thread 5 (2021-12-13):

Can't upload code to the board

mycelium-networks, 2021-12-13:
`In file included from /home/og/Arduino/libraries/ESP32Servo/src/ESP32Servo.h:67:0,
                 from /home/og/Downloads/community_robot_arm-master/arduino_firmware/robotArm_v0.81/servo_gripper.h:7,
                 from /home/og/Downloads/community_robot_arm-master/arduino_firmware/robotArm_v0.81/robotArm_v0.81.ino:36:
/home/og/Arduino/libraries/ESP32Servo/src/analogWrite.h:3:10: fatal error: cstdint: No such file or directory
 #include <cstdint>
          ^~~~~~~~~
compilation terminated.
exit status 1
Error compiling for board Arduino Mega or Mega 2560.`
I have installed the esp32 servo package on Arduino. What do I need to do to fix this compiling error?
