20sffactory/community_robot_arm/arduino_firmware/robotArm_v0.81/pinout/pinout_uno.h

#ifndef PINOUT_UNO_H_
#define PINOUT_UNO_H_

#define X_STEP_PIN          2
#define X_DIR_PIN           5
#define X_ENABLE_PIN        8
#define X_MIN_PIN           9
#define X_MAX_PIN          -1
 
#define Y_STEP_PIN          3
#define Y_DIR_PIN           6
#define Y_ENABLE_PIN        8
#define Y_MIN_PIN          10
#define Y_MAX_PIN          -1

#define Z_STEP_PIN          4
#define Z_DIR_PIN           7
#define Z_ENABLE_PIN        8
#define Z_MIN_PIN          11 
#define Z_MAX_PIN          -1

#define E0_STEP_PIN        12
#define E0_DIR_PIN         13
#define E0_ENABLE_PIN       8
#define E0_MIN_PIN         16 //A2 PIN //UNO ANALOG PIN CAN FUNCTION AS DIGITAL PIN

#define E1_STEP_PIN        -1
#define E1_DIR_PIN         -1
#define E1_ENABLE_PIN      -1

#define BYJ_PIN_0          -1 
#define BYJ_PIN_1          -1 
#define BYJ_PIN_2          -1 
#define BYJ_PIN_3          -1


#define SERVO_PIN          17 //A3 PIN //UNO ANALOG PIN CAN FUNCTION AS DIGITAL PIN

#define PUMP_PIN           -1
#define LASER_PIN          -1
#define LED_PIN            -1

#define SDPOWER            -1
#define SDSS               -1

#define FAN_PIN            -1

#define PS_ON_PIN          -1
#define KILL_PIN           -1

#define TEMP_0_PIN         -1   // ANALOG NUMBERING
#define TEMP_1_PIN         -1   // ANALOG NUMBERING

#endif
