20sffactory/community_robot_arm/arduino_firmware/robotArm_v0.81/robotGeometry.h

#ifndef ROBOTGEOMETRY_H_
#define ROBOTGEOMETRY_H_

class RobotGeometry {
public:
  RobotGeometry(float a_ee_offset, float a_low_shank_length, float a_high_length);
  void set(float axmm, float aymm, float azmm);
  float getXmm() const;
  float getYmm() const;
  float getZmm() const;
  float getRotRad() const;
  float getLowRad() const;
  float getHighRad() const;
  float getHypot() const;
private:
  void calculateGrad();
  float ee_offset;
  float low_shank_length;
  float high_shank_length;
  float xmm;
  float ymm;
  float zmm;
  float rot;
  float low;
  float high;
  float rrot_ee;
};

#endif
