20sffactory/community_robot_arm/arduino_firmware/robotArm_v0.81/byj_gripper.h

#ifndef BYJ_GRIPPER_H_
#define BYJ_GRIPPER_H_


class BYJ_Gripper {
public:
  BYJ_Gripper(int pin0, int pin1, int pin2, int pin3, int steps);
  void cmdOn();
  void cmdOff();
private:
  bool direction;
  void moveSteps();
  void setDirection();
  int byj_pin_0;
  int byj_pin_1;
  int byj_pin_2;
  int byj_pin_3;
  int grip_steps;
  int step_cycle;
};
#endif
