20sffactory/community_robot_arm/arduino_firmware/robotArm_v0.81/endstop.h

#ifndef ENDSTOP_H_
#define ENDSTOP_H_

class Endstop {
  public:
    Endstop(int a_min_pin, int a_dir_pin, int a_step_pin, int a_en_pin, int a_switch_input, int a_step_offset, int a_home_dwell, bool does_swap_pin);
    void home(bool dir);
    void homeOffset(bool dir);
    void oneStepToEndstop(bool dir);
    bool state();
    bool bState;

  private:
    int min_pin;
    int dir_pin;
    int step_pin;
    int en_pin;
    int switch_input;
    int home_dwell;
    int step_offset;
    bool swap_pin;    
};

#endif
