20sffactory/community_robot_arm/arduino_firmware/robotArm_v0.81/interpolation.h

#ifndef INTERPOLATION_H_
#define INTERPOLATION_H_
#include <Arduino.h>

#define X_AXIS 0
#define Y_AXIS 1
#define Z_AXIS 2
#define E_AXIS 3

struct Point {
  float xmm;
  float ymm;
  float zmm;
  float emm;
};
class Interpolation {
public:
  //void resetInterpolation(float px, float py, float pz);
  //void resetInterpolation(float p1x, float p1y, float p1z, float p2x, float p2y, float p2z);
  //void resetInterpolation(Point p0, Point p1);
  Interpolation();
  void setCurrentPos(float px, float py, float pz, float pe);
  void setInterpolation(float px, float py, float pz, float pe, float v = 0);
  void setInterpolation(float p1x, float p1y, float p1z, float p1e, float p2x, float p2y, float p2z, float p2e, float av = 0);
  
  void setCurrentPos(Point p);
  void setInterpolation(Point p1, float v = 0);
  void setInterpolation(Point p0, Point p1, float v = 0);
  
  void updateActualPosition();
  bool isFinished() const;
  
  float getXPosmm() const;
  float getYPosmm() const;
  float getZPosmm() const;
  float getEPosmm() const;
  Point getPosmm() const;
  bool isAllowedPosition(float pos_tracker[4]);
  void setPosOffset(float new_x, float new_y, float new_z, float new_e);
  void resetPosOffset();
  Point getPosOffset() const;
  int speed_profile;
  void setSpeedProfile(int new_speed_profile);
  
private:
  Point pos_offset;
  float pos_tracker[4];
  byte state;
  
  long startTime;  
  
  float xStartmm;
  float yStartmm;
  float zStartmm;
  float eStartmm;
  float xDelta;
  float yDelta;
  float zDelta;
  float eDelta;
  float xPosmm;
  float yPosmm;
  float zPosmm;
  float ePosmm;
  float v;
  float tmul;
};

#endif
