20sffactory/community_robot_arm/arduino_firmware/robotArm_v0.81/logger.h

#ifndef LOGGER_H_
#define LOGGER_H_

#include <Arduino.h>

#define LOG_ERROR 0
#define LOG_INFO 1
#define LOG_DEBUG 2

class Logger {
  public:
    static void log(String message, int level);
    static void logINFO(String message);
    static void logERROR(String message);
    static void logDEBUG(String message);
};
#endif
