20sffactory/community_robot_arm/arduino_firmware/robotArm_v0.81/equipment.cpp

#include "equipment.h"
#include <Arduino.h>

Equipment::Equipment(int equipment_pin){
  pin = equipment_pin;
  pinMode(pin, OUTPUT);
}

void Equipment::cmdOn(){
  digitalWrite(pin, HIGH);  
}

void Equipment::cmdOff(){
  digitalWrite(pin, LOW);  
}
