20sffactory/community_robot_arm/(commit log)

2020-10-04 Add files via upload
    robot_arm_enclosure_v0.2
    - Credits to Wouter van Schaik for original design
    - Edited by 20sffactory:
    case_bottom, case_top concave design to conserve filament
    reset_button with expanded round plate
    case_body with DC jack compartment
    [robot_arm_enclosure_v0.2.step]
2021-01-16 fixed few issues due to lower/upper case of header files
    [RampsStepper.cpp, fanControl.cpp]
2021-01-16 Add files via upload
    Gripper is designed by Florin Tobler.
    gripper_screw_secure & gripper_shaft is adjusted by 20sffactory.
    [link to original ftobler robotarm](http://thingiverse.com/thing:1718984/)
    [gripperBase_by_ftobler.stl, gripperFinger_by_ftobler.stl, gripper_screw_secure.stl, gripper_shaft.stl]
